BZKDP/robot-arm/README.md

# Роборука 5-DOF (редукторная)

Пятиосевой настольный манипулятор с редукторным приводом. Кинематическая цепь:
yaw базы (J1) → pitch плеча (J2) → roll (J4) → pitch (J5) → вращение кисти (J6).
Рама собрана из алюминиевого профиля и U-кронштейнов, звенья на трубе 20x20.

## Привод
- 5x шаговых двигателя NEMA17 (17HS4401 на основных осях, NEMA14 на кисти);
- планетарные редукторы CM36 1:71 на каждом суставе;
- металлические фланцевые муфты на вал 8 мм, вторая опора pitch-суставов на фланцевых подшипниках KFL08.

## Обратная связь и управление
- драйверы TMC2209 (STEP/DIR, в перспективе UART);
- магнитные энкодеры AS5600 на выходных осях суставов (абсолютный угол после редуктора);
- единый контроллер на ESP32; firmware на FastAccelStepper (аппаратные RMT-движки на ось);
- десктопная панель управления на Python (jog-режим, телеметрия, E-STOP, watchdog).

## Обучение
Планируется обучение движениям джойстиком (teach-by-demonstration) с дальнейшим
переносом траекторий в стек LeRobot для автономного управления.

## Состав репозитория
- `arm/` — основная рука: CAD-генераторы (Python/CadQuery), печатные детали, прошивка (`firmware/`), схемы разводки (SVG), BOM и аудиты;
- `stl_original/` — исходный STL-набор EEZYbotARM MK2, взятый за механическую основу;
- `pan-tilt-tracker/` — подсистема pan-tilt камеры (ESP32-CAM, сервоприводы STS3215, трекинг);
- `vacuum/` — вакуумный захват (держатель присоски);
- `BOM.md`, `notes.md` — перечень компонентов и рабочие заметки.

## Статус
Проект в разработке: J1/J2 собраны и протестированы под нагрузкой, идёт установка
энкодеров и калибровка остальных осей. Абсолютное позиционирование и IK — следующий этап.
