BZKDP/robot-arm/arm/full_arm_v10_detail/README_RU.md

# Роборука V10 — полная детальная модель

Открыть `ARM_V10_FULL_DETAIL_INTERACTIVE_3D.html` двойным щелчком. Интернет не нужен.

Это сборочная модель для проверки компоновки, а не единый файл для печати.

Включено: шесть осей J1–J6, подробная геометрия v8, новый J3, перенесённый J4 roll, нижняя клетка M5×80, roll-клетка M5×80, двойной Hall-индекс J1, AS5600 на pitch-суставах, муфты, KFL08, трубы, винты, шайбы, гайки и видимые маршруты жгутов.

Гармонические редукторы HBS17 намеренно не добавлены: они пока только рассматриваются.
