BZKDP/robot-arm/notes.md

# EEZYbotARM MK2 — печать на Creality Ender 3 V3 SE

Заметки и рекомендации для 3D-печати робо-руки. Обновляй раздел «Журнал печати» по ходу — отмечай, что уже напечатано и какие настройки использовал.

---

## 0. Принятые дефолты (если не подходит — поменяй)

- **Сервы:** MG996R × 3 (база, плечо, локоть) + SG90 × 1 (захват)
- **Шестерня серво:** `EBAmk2_010_gearservo_22DENTI.STL` (под 22T-сплайн MG996R). Если у тебя Hitec/DS3218 с 25T — взять `_25DENTI`. Универсальная `010_gearservo.STL` тоже годится, но потребует разворачивания посадочного отверстия под сплайн.
- **Мастер-шестерня:** `EBAmk2_011_gearmast_full.STL` (усиленная)
- **Горизонтальное звено:** `EBAmk2_006_horarm_plate.STL` (с пластиной — жёстче)
- **Материал:** PLA+ (или обычный PLA, если PLA+ нет). См. раздел «Материал».
- **Слайсер:** OrcaSlicer, профиль `Creality Ender-3 V3 SE`

---

## 1. Материал: PLA vs PETG

**Рекомендация: PLA+ (или PLA).**

| Критерий | PLA / PLA+ | PETG |
|---|---|---|
| Прочность на изгиб/нагрузку | ✅ выше | средняя (упругий — гнётся под винтом) |
| Жёсткость (важно для точности руки) | ✅ выше | ниже |
| Точность отверстий под М4 и валы | ✅ отлично | хуже (тянется) |
| Печать шестерён (мелкие зубья) | ✅ отлично | плохо (ниточность) |
| Стойкость к UV/жаре | ❌ деформация от 50–60 °C | ✅ до 70–80 °C |
| Хрупкость на ударе | хрупче | прочнее на удар |

**Когда выбирать PETG:** если рука будет работать на солнце, рядом с радиатором/обогревателем, или в неотапливаемом гараже летом (>40 °C в воздухе).

**Когда PLA+:** комнатные условия, точная геометрия, чёткие шестерни. Для EEZYbotARM MK2 это норма — у автора проекта (Carlo Franciscone) сами детали и опубликованные сборки в PLA/ABS.

**ABS не рекомендую** — Ender 3 V3 SE без корпуса, будут трещины (warping) на крупных деталях 001/002/012.

---

## 2. Температуры

### PLA+ (рекомендация)
- **Сопло:** 210 °C (первый слой 215 °C)
- **Стол:** 60 °C (первый слой 65 °C)
- **Обдув:** 100% после 2-го слоя

### PLA (обычный)
- **Сопло:** 200 °C (первый слой 205 °C)
- **Стол:** 55–60 °C
- **Обдув:** 100% после 2-го слоя

### PETG (если выбран)
- **Сопло:** 235 °C (первый слой 240 °C)
- **Стол:** 75 °C
- **Обдув:** 30–40% (выше — расслоение)
- **Z-offset:** на 0.05 мм выше обычного (PETG липнет агрессивно)

**Первое — сделай Temp Tower и Flow test для конкретной катушки.** Любой производитель врёт на ±10 °C от рекомендации на этикетке.

---

## 3. Скорости (для V3 SE)

V3 SE паспортно умеет до 250 мм/с, но для **точных механических деталей** руки это перебор — будет звон (ringing) и потеря точности отверстий.

| Параметр | Значение | Почему |
|---|---|---|
| Outer wall (наружные стены) | **80 мм/с** | внешний вид и точность размеров отверстий |
| Inner walls | 150 мм/с | внутри детали, не критично |
| Infill | 180–200 мм/с | стандартно |
| Top/Bottom solid | 100 мм/с | гладкая поверхность |
| Travel | 250 мм/с | без выдавливания, можно гнать |
| Initial layer | **30 мм/с** | критично для адгезии |
| Initial layer travel | 50 мм/с | |

Включи **Input Shaping** в профиле V3 SE (Orca поддерживает — обычно уже в дефолтном профиле).

---

## 4. Высота слоя

| Категория | Layer height | Зачем |
|---|---|---|
| Шестерни (010, 011, 016, 018) | **0.12 мм** | мелкие зубья, плавность зацепления |
| Захват finger dx/sx (015, 017) | 0.16 мм | компромисс точности и времени |
| Линки 004/005/008 | 0.2 мм | стандарт |
| Большие звенья 002/003/006 | 0.2 мм | |
| База 001/012/013 | 0.24 мм | большие объёмы, не критично |

Первый слой везде — **0.24 мм** (даже если основная высота 0.12) — для адгезии.

---

## 5. Заполнение (infill)

**Тип заполнения для всех нагруженных деталей: `Gyroid`** — лучший на скручивание и многонаправленную нагрузку. На сжатие хуже Cubic, но робо-рука работает в основном на изгиб/кручение.

| Категория | Infill % | Тип |
|---|---|---|
| База (001, 012, 013) | **40%** Gyroid | держит весь вес руки |
| Главное плечо 002, V-arm 003 | **35%** Gyroid | основные нагруженные звенья |
| Horizontal arm 006_plate | **35%** Gyroid | плюс пластина усиления внутри |
| Линки 004/005/007/008/009 | 30% Gyroid | средняя нагрузка |
| Шестерни 010/011/016/018 | **60%** Cubic | жёсткие зубья, без деформации |
| Claw base 014 | 30% Gyroid | |
| Claw fingers 015/017 | **40%** Cubic | держат груз, нужна жёсткость кончика |
| Drive cover 019 | 15% Gyroid | декоративная крышка |

---

## 6. Стены / Walls

- **Outer + inner walls = 4 периметра** для всех механических деталей
- **Шестерни (010, 011, 016, 018): 5 периметров** — зубья должны быть плотные
- **Top/Bottom layers:** 5 (минимум) — особенно для деталей с отверстиями под валы (M4)
- **Line width:** оставить дефолт (0.42 при сопле 0.4)

---

## 7. Поддержки — конкретно по деталям

**Общее правило MK2:** STL автора **уже ориентированы под минимум поддержек**. Не вращай детали без необходимости.

### Поддержки НУЖНЫ:
| Деталь | Где |
|---|---|
| `001_base` | внутри углубления под подшипник (если есть выступ) |
| `002_mainarm` | в районе отверстия серво (M-форма) |
| `006_horarm_plate` | **точно нужны** — есть нависающие площадки. Тип: **Tree (organic)** в Orca |
| `012_mainbase_NEW` | внутренние полости под серву и подшипник |
| `014_claw base` | под крепление сервы захвата |

### Поддержки НЕ нужны (печатать без них):
| Деталь | Почему |
|---|---|
| `010_gearservo*` | плоская, ориентация лежа |
| `011_gearmast*` | то же |
| `004_link135`, `005_link135angled`, `008_link147` | линки печатаются плашмя |
| `007_trialink`, `009_trialinkfront` | треугольники плоские |
| `013_lower base` | плита |
| `015/017_claw finger` | лежа на боку — нет навесов |
| `016_claw gear drive`, `018_claw gear driven` | плоско, лежа |
| `019_drive_cover` | плоская крышка |
| `003_varm` | вертикальное звено, обычно без поддержек |

### Tree (Organic) vs Normal в OrcaSlicer
- **Tree (Organic)** — для `006_horarm_plate`, `001_base`, `012_mainbase`, `014_claw base` (сложная геометрия, легко удаляется)
- **Normal** — нигде особо не нужен. Только если будут глюки Tree.

### Параметры поддержек (Orca):
- Z-расстояние: **0.2 мм** (1 слой при 0.2 мм)
- Pattern: Default
- Threshold angle: 50° (по умолчанию)
- **Снимаем кусачками после остывания**, не пытайся ломать горячую деталь.

---

## 8. Ориентация на столе (критично!)

Слои печати должны идти **перпендикулярно нагрузке**, чтобы детали не расслаивались по шву.

| Деталь | Ориентация |
|---|---|
| **Шестерни 010, 011, 016, 018** | **Лежа плашмя**, зубьями вверх. Никогда не вертикально! Расслоение по зубу = шестерня сломается на первой нагрузке. |
| **Линки 004, 005, 008** | Плашмя (отверстия M4 вверх) — стержень нагружен на изгиб, слои перпендикулярны |
| **`002 mainarm`, `003 varm`** | По длинной оси на столе (как «лежит лопатка») |
| **`006 horarm_plate`** | Самой широкой плоскостью вниз, поддержки сверху |
| **`015/017 claw finger`** | На бок (как они работают в захвате) |
| **`001 base`** | Дном вниз |
| **`014 claw base`** | Открытой стороной вверх (поддержки внутри) |

В OrcaSlicer есть кнопка **Auto-orient** — она часто угадывает правильно, но **проверяй вручную** для шестерён и линков.

---

## 9. Адгезия (Brim / Raft / Skirt)

| Деталь | Адгезия |
|---|---|
| Большие плоские (001, 012, 013, 019) | **Skirt** (1 контур, 4 мм) — для прайма |
| Шестерни 010, 011, 016, 018 | **Brim 5 мм** — иначе угол отлипнет и зубья поплывут |
| Линки 004, 005, 007, 008, 009 | **Brim 3 мм** — мало площади на столе |
| `015/017 claw finger` (на боку) | **Brim 5 мм** — мало контакта |
| 006 horarm_plate | Skirt + Tree support срабатывают как адгезия |

**Raft не нужен** — V3 SE с PEI/PC-стеклом держит первый слой отлично, raft только тратит пластик и портит низ детали.

---

## 10. Порядок печати

### Шаг A — Тест точности (ОБЯЗАТЕЛЬНО первым)
Перед массовой печатью убедись, что твоя сборка даёт **±0.2 мм** на отверстиях:

1. Распечатай `EBAmk2_010_gearservo_22DENTI.STL` (~30 мин) — у неё центральное отверстие под вал сервы. Проверь по штангенциркулю.
2. Распечатай `EBAmk2_004_link135.STL` (~1.5 ч) — длинный линк с двумя отверстиями M4. Проверь штангенциркулем и попробуй вставить M4-винт. Должен заходить с лёгким усилием, не болтаться, не клинить.

**Если отверстия зарастают** → в слайсере выкрути `Hole horizontal compensation` или `XY hole compensation` на +0.1...+0.2 мм.
**Если слишком велики** → -0.1 мм или подкрути e-step / flow rate.

### Шаг B — Основная партия (от простого к сложному)
Печатать партиями по 1–3 детали (мелкие можно вместе на одном столе):

| № | Деталь | Прим. время | Примечание |
|---|---|---|---|
| 1 | 010_gearservo_22DENTI | 0.5 ч | (уже из теста) |
| 2 | 011_gearmast_full | 2 ч | |
| 3 | 016_claw gear drive | 0.5 ч | |
| 4 | 018_claw gear driven | 0.5 ч | |
| 5 | 015_claw finger dx | 1 ч | |
| 6 | 017_claw finger sx | 1 ч | |
| 7 | 014_claw base | 2 ч | |
| 8 | 019_drive_cover_new | 1 ч | |
| 9 | 004_link135 | 1.5 ч | (уже из теста) |
| 10 | 005_link135angled | 1.5 ч | |
| 11 | 007_trialink | 2.5 ч | |
| 12 | 008_link147_new | 2 ч | |
| 13 | 009_trialinkfront | 2.5 ч | |
| 14 | 013_lower base | 1.5 ч | |
| 15 | 003_varm | 2 ч | |
| 16 | 002_mainarm | 5 ч | крупная |
| 17 | 006_horarm_plate | 6 ч | крупная + поддержки |
| 18 | 001_base | 6 ч | |
| 19 | 012_mainbase_NEW | 7 ч | самая большая |

**Итого: ~45–50 часов чистой печати** на PLA при средних настройках (~180 мм/с infill, 80 мм/с outer wall).

Разумно растянуть на 5–7 дней по 1–2 партии в день — не оставляй принтер на ночь без присмотра, особенно в начале.

---

## 11. Workflow в OrcaSlicer (пошагово)

1. **Запусти OrcaSlicer.** При первом запуске мастер настройки — выбери `Creality` → `Ender-3 V3 SE` (профиль есть из коробки).
2. **Импорт STL:** `File → Import → Import STL` (или Ctrl+I), выбери файл из `.\stl_original\`.
3. **Ориентация:** нажми **Auto-orient** (иконка с поворотом), потом проверь по рекомендациям из §8.
4. **Применить настройки:** в правой панели выбери Filament (`Generic PLA`/`Generic PLA+`), затем процесс печати — создай свой preset:
    - `Process → New Preset → "EEZYbotARM_strong_0.2"`
    - Заполни параметры из §3–§9 для соответствующей категории детали.
    - Сохрани.
5. **Поддержки:** включи в `Support → Enable Support`. Тип — `Tree (organic)` (см. §7).
   - **Manual painting** (кнопка с кистью на верхней панели) — используй, когда хочешь убрать лишние поддержки или, наоборот, добавить точечно. Особенно полезно для `006_horarm_plate`.
6. **Slice:** кнопка `Slice plate` (внизу справа).
7. **Превью слоёв:** после слайса откроется preview. Прокрути ползунок снизу вверх — проверь:
   - Первый слой — без дыр
   - Поддержки не сваливаются на воздух
   - Шестерни и зубья выглядят как нужно
   - Время и расход внизу справа
8. **Экспорт G-code:** кнопка `Export G-code` (рядом со Slice). Сохрани в `.\gcode_output\`.

**Имя файла:** `NN_<деталь>_<материал>_<infill>.gcode`, например:
```
10_gearservo_22DENTI_PLA_60.gcode
04_link135_PLA_30.gcode
19_mainbase_NEW_PLA_40.gcode
```

### CLI (для будущей автоматизации)
```bash
"/c/Program Files/OrcaSlicer/orca-slicer.exe" --slice 0 \
  --load "профиль.json" \
  --output "gcode_output/файл.gcode" \
  "stl_original/EBAmk2_004_link135.STL"
```
Полная документация: `orca-slicer.exe --help`.

---

## 12. Перенос на принтер (Ender 3 V3 SE)

### Через USB-флешку
- **ФС:** **FAT32** (обязательно). exFAT V3 SE не читает. NTFS тоже не читает.
- **Размер флешки:** до 32 ГБ (FAT32-лимит). Хватает за глаза.
- **Имена файлов:** только латиница и цифры, без пробелов и кириллицы. Длина до 64 символов. Дефис и подчёркивание ok.
- **Куда класть:** в корень флешки. Поддерживаются подпапки до 1 уровня, но не все G-code-плагины их видят — лучше в корень.
- **Сортировка на экране:** по дате модификации (сверху — самые свежие).
- **Превью:** OrcaSlicer вшивает превью в G-code (thumbnail). Профиль `Ender-3 V3 SE` включает это по умолчанию.

### Через Wi-Fi (опционально)
**Ender 3 V3 SE НЕ имеет встроенного Wi-Fi** ([источник](https://www.crealitycloud.com/post-detail/6782c6e2ccf5567488d6dc88)). Нужен внешний модуль — варианты:
- **Creality Wi-Fi Box 2.0** (USB) — самый простой, подключается по USB к плате принтера, работает с `Creality Print` и Creality Cloud
- **Nebula Pad / Sonic Pad** — даёт Klipper + удалённый интерфейс, дороже
- **Raspberry Pi с OctoPrint** — самый гибкий, но требует возни. **OctoPrint в стоке Ender 3 V3 SE через USB работает** — V3 SE отдаёт серийник как обычный Marlin-принтер.

Без модуля — **флешка остаётся основным каналом**.

---

## 13. Pre-print checklist (делай перед КАЖДОЙ печатью)

### Калибровка стола (V3 SE с CR Touch)
- [ ] Нагрей стол до **рабочей температуры** (60 °C для PLA) — алюминий расширяется, делать леволинг холодным неправильно.
- [ ] Меню `Prepare → Auto Home` → дождись завершения.
- [ ] Меню `Prepare → Auto Leveling` — CR Touch проедет сетку (~3 минуты).
- [ ] После леволинга сделай **Z-offset проверку**: лист A4 между соплом и столом, медленно опускай Z по 0.05 мм, пока бумага не начнёт тереться (но не клинить).
- [ ] Сохрани Z-offset в EEPROM (`Settings → Store Settings` или автоматически на V3 SE).

### Перед запуском печати
- [ ] **Очисти стол изопропилом** (90%+) — никакого жира от пальцев.
- [ ] **Проверь ремни:** ось X и Y — нажимаешь пальцем посередине, ремень прогибается на 3–5 мм, дальше упругое сопротивление. Слишком слабый — будет ringing. Слишком тугой — потеря шагов.
- [ ] **Прокатай филамент 50 см** из сопла после смены катушки — должна идти **ровная** нитка без пузырей.
- [ ] **Flow test:** распечатай single wall куб 20×20×20 без верха/низа, измерь толщину стенки штангенциркулем — должна быть = line width × 1 (0.42 при сопле 0.4). Корректируй `Flow ratio` в filament-настройках.
- [ ] **Температурный тест:** для новой катушки — Temp Tower (есть готовые STL/gcode в репах OrcaSlicer).

### Первый слой (наблюдай первые 5 минут)
- [ ] Сопло **не царапает** стол (Z-offset слишком низкий) — крути up на 0.05.
- [ ] Линии **не размазываются и не зазоры** между ними — идеально, когда линии чуть приплюснуты, без щелей.
- [ ] Углы **не задираются** — если задрались, увеличь Brim или снизь скорость первого слоя до 20 мм/с.
- [ ] Если что-то не так — **жми `Stop` сразу**, не жди. Лучше перепечатать первый слой 10 раз, чем выкинуть 6-часовую печать с расслоением.

---

## 14. Мониторинг длинных печатей

V3 SE — без Wi-Fi и без экрана с прогрессом в облако в базовой комплектации. Варианты:

| Решение | Сложность | Что даёт |
|---|---|---|
| **Web-камера (USB → ноутбук)** | минимум | визуальный контроль, можно записать таймлапс через OBS/iSpy |
| **OctoPrint на Raspberry Pi** | средне | удалённый старт/стоп, прогресс, snapshot, плагины (включая failure detection) |
| **Creality Wi-Fi Box 2.0** | минимум | приложение `Creality Print` → удалённый статус, отправка G-code по Wi-Fi |
| **Nebula Pad** | средне | Klipper + Mainsail, лучшее качество и input shaping |

**Минимум-вариант:** телефон на штативе с приложением типа `Alfred Home Security Camera` (бесплатно) — даёт прямой стрим на твой второй телефон / комп. Если что — приходишь и жмёшь стоп.

**Никогда не оставляй принтер совсем без присмотра**, особенно ночью (рекомендация Creality и здравый смысл).

---

## 15. Журнал печати

Заполняй по ходу. Формат: дата · деталь · профиль · результат · заметки.

| Дата | Деталь | Профиль | Время | Результат | Заметки |
|---|---|---|---|---|---|
| | | | | | |
| | | | | | |

---

## 16. Полезные ссылки

- [EEZYbotARM MK2 на Instructables (инструкция автора)](https://www.instructables.com/EEZYbotARM-Mk2-3D-Printed-Robot/)
- [Thingiverse / MyMiniFactory оригинал](https://www.myminifactory.com/object/3d-print-eezybotarm-mk2-46620)
- [Ender-3 V3 SE Downloads (firmware, Creality Print)](https://www.creality.com/download/creality-ender-3-v3-se)
- [OrcaSlicer releases](https://github.com/SoftFever/OrcaSlicer/releases)
