BZKDP/robot-arm/arm/electronics_carrier_v1/ELECTRONICS_CARRIER_V2_INTERACTIVE_3D.html

# Кассета электроники — V2 PREVIEW

2× обычная ESP32 · 5× LERDGE TMC2209 · 3× F15 · CJMCU-9548 · ASW-17D · 5× AS5600. ЛКМ — вращать, колесо — масштаб, ПКМ — двигать камеру.

Разнести уровни 0%

СобраноРазобраноОбъёмСверху

Показать внутренности и провода

Скрыть верхнюю пластину

Верх STLКороб STLТест кнопки STLОбзор PNG

Пока это PREVIEW: детали ещё не измерены штангенциркулем. Полный корпус печатать после контрольных замеров. Калибратор выключателя уже можно использовать после его получения.

Две обычные ESP32
Левая управляет моторами, правая опрашивает датчики. У каждой свой передний выход USB-C, поэтому обе можно одновременно подключить к компьютеру двумя кабелями и открыть два COM-порта.

CJMCU-9548 / TCA9548A
Размер заложен 31,5×22 мм. Крепление универсальное: направляющие за края и прорези под стяжку, потому что источники расходятся по диаметру штатных отверстий. Пять AS5600 подключаются к каналам SC0/SD0…SC4/SD4.

Пять AS5600 находятся на руке
В корпус заходят пять отдельных четырёхжильных кабелей S1–S5: 3V3, GND, SDA, SCL. Справа предусмотрено пять вводов с разгрузкой стяжками и один отдельный AUX. SDA/SCL датчиков не объединяются до TCA.

Три внутренних F15
F1: 3V3 моторной ESP → VIO пяти драйверов. F2: 3V3 датчиковой ESP → VCC пяти AS5600. F3: GND датчиковой ESP → GND пяти AS5600. Размер посадки 39,8×29×14,5 мм; крепление уголками и стяжкой.

Питание и земли
Линии 3V3 двух ESP32 между собой не соединять. Общая GND ESP32, драйверов и 12-вольтового источника обязательна. CJMCU-9548 получает 3V3 и GND от датчиковой ESP32 короткими проводами.

Выключатель REXANT ASW-17D
Учтён новый точный чертёж: окно 34,2×20,2 мм, рамка 38,5×22,5 мм. В модели окно 34,5×20,5 мм. Короб увеличен до 40 мм, чтобы поместились корпус и клеммы. Это обычное отключение питания моторов, не аварийная кнопка.

Пять драйверов и моторные кабели
J1–J5 стоят одним рядом, радиаторы открыты. Сзади каждому драйверу соответствует отдельный широкий ввод моторного кабеля с парой пазов под стяжку.

Габариты печати
Верх и короб: 200×160 мм, подходят для стола Ender‑3 V3 SE 220×220 мм. Полезная высота нижнего отсека 37 мм. Обе печатные сетки замкнуты и состоят из одного тела.

+12 V после выключателя общая GND управление моторами кабели датчиков S1–S5

СВЕРХУ: ПЛАТЫ И КЛЕММЫ · ВНУТРИ: 3× F15, КОНДЕНСАТОР, ПАЙКА И КАБЕЛИ
