BZKDP/robot-arm/arm/electronics_carrier_v1/FINAL_DIMENSION_CHECK_RU.md

# Проверка размеров финальной кассеты

## Принтер и габарит

- Принтер: Creality Ender-3 V3 SE.
- Рабочая область: 220×220×250 мм.
- Основание каждой печатаемой детали: 200×140 мм.
- Запас на столе: 10 мм с каждой стороны по оси 200 мм и 40 мм по оси 140 мм.
- С brim 5 мм: итоговый след 210×150 мм; минимальный запас до границы стола 5 мм.

## Нижний короб

- Общая высота: 24 мм.
- Дно: 3 мм.
- Стенки: 3 мм.
- Полезная внутренняя высота: около 21 мм.
- Ввод 12 В: 10×16 мм.
- Выводы моторов: 5 штук по 12×10 мм.
- Выводы датчиков/AUX: 6 штук по 10×8 мм.
- Передний вырез USB-C: 22×10 мм.

## Верхняя пластина

- Толщина основы: 3,2 мм.
- Максимальная высота с направляющими: 6,38 мм.
- ESP32: номинальный DevKit 30 pin 51,5×28,5 мм; междурядье выводов 25,4 мм.
- LERDGE TMC2209: официальная плата 20,5×15,5 мм; междурядье выводов 12,7 мм.
- Высота драйвера с радиатором по пользовательскому замеру: 13 мм; радиаторы открыты сверху.
- CH-22/12P-1/1: 75,6×41,6×15 мм; отверстия Ø3,4 мм; межосевое расстояние 70 мм.
- От заднего края прорези CH-22 до края пластины остаётся 5,7 мм материала.
- Между зоной драйверов и корпусами CH-22 остаётся около 6,95 мм.
- От торца каждой CH-22 до боковой границы пластины остаётся около 20,2 мм.
- Проход USB-C в пластине: 22×14 мм.

## Проверка STL

Обе печатаемые сетки проверены программно:

- замкнутые и водонепроницаемые;
- согласованное направление граней;
- каждая состоит из одного связного тела;
- нет разорванных граней;
- нижняя поверхность лежит на Z=0;
- обе детали помещаются на стол 220×220 мм с brim 5 мм;
- поддержки не требуются: найденные нижние микрограни имеют короткие пролёты, печатаемые как обычные мосты.

Перед окончательной пайкой обязательна сухая примерка: у клонов ESP32 может немного отличаться внешний контур и положение USB-разъёма, поэтому посадка сделана по рядам контактов и увеличенному окну, а не по жёсткому контуру платы.
