BZKDP/robot-arm/arm/PROJECT_AUDIT_2026-08-28.md

# Роборука — независимый аудит проекта на 2026-08-28

## 1. Текущее понимание конструкции

Финальная обсуждавшаяся кинематическая цепь имеет пять управляемых осей:

`J1 yaw базы → J2 pitch плеча → J4 roll → J5 pitch → J6 вращение кисти`.

J3-локоть был исключён ради массы. Поэтому старые файлы, где есть J3 и шесть двигателей, не являются текущей архитектурой.

Основная механика:

- длинные NEMA17 на J1 и J2;
- CM36 1:71;
- металлические фланцевые муфты на вал 8 мм;
- U-кронштейны;
- труба 20 × 20 × 1,5 мм;
- противоположная опора pitch-суставов — вал Ø8 и ромбический фланцевый подшипник;
- AS5600 на выходных осях pitch-суставов;
- NEMA17 в большом стакане на J4 roll;
- NEMA14 в малом стакане на J6.

## 2. Что восстановлено из спорных итераций J2

Точный замер реальной металлической муфты:

- фланец: Ø21,8 × 2 мм;
- хаб: примерно Ø14,1 мм;
- общая длина: около 12,8 мм;
- вал: Ø8 мм;
- четыре отверстия: около Ø3,5 мм, то есть крепёж M3;
- измеренное расстояние между противоположными центрами: BC ≈16,5 мм.

Предыдущий мост имел две отдельные проблемы:

1. Трубные винты стояли на ±16 мм, и фланец муфты перекрывал их цековки. В T5 они перенесены на ±21,5 мм.
2. После правильного вывода «муфта = M3» генератор V4 снова ошибочно вернулся к M4. Эта версия больше не считается рабочей.

Текущая размерная цепь T5 по оси Z:

- стенка A U-кронштейна: −24…−21,5 мм;
- хаб муфты: примерно −21…−10,2 мм;
- фланец муфты: −10,2…−8,2 мм;
- мост T5: −8,2…−3,2 мм;
- труба: −3,2…+16,8 мм;
- зазор до стенки B: около 4,7 мм;
- стенка B: +21,5…+24 мм.

## 3. Текущий мост V7/T5

- Габарит: 40 × 56 × 5 мм.
- Труба: M4 на ±21,5 мм; цековки Ø8,4 × 3 мм.
- Центральный проход: Ø9,2 мм.
- Муфта: четыре радиальных паза шириной 4,0 мм.
- После V6 добавлено ещё +5% без отдельного пробника.
- Новая цель: BC20,963 мм; номинальный центр пазов V7: BC21,0 мм.
- Допустимый диапазон V7: BC18,0…24,0 мм.
- Крепёж муфты: 4 × M3×7 и гайки M3.

Сетка STL герметична, габарит и сечения проверены автоматически. Точки BC=20,963 проходят внутри всех четырёх пазов.

## 4. Стакан roll NEMA17

Старый стакан имел правильный моторный квадрат 31 × 31 мм, но не оставлял места головкам длинных M3 возле углов стенки. Старое указание M4×30 также не позволяло нормально поставить гайку на стакан наружной шириной 29,4 мм.

В финальной V3:

- фланец 50 × 50 × 5 мм;
- карман трубы 20,4 × 20,4 мм, глубина около 30,5 мм фактического входа;
- NEMA17: квадрат 31 × 31 мм, проход M3 Ø3,8 мм;
- четыре вертикальных выреза Ø6,6 мм для головок и шестигранника;
- поперечные отверстия Ø4,6 мм;
- встроен удаляемый после печати диск Ø70×0,4 мм, увеличивающий расчётную площадь первого слоя примерно на 66%;
- кабельный паз открыт сверху, поэтому печать не строит поздний мостик над окном;
- к трубе: M4×35 минимум или M4×40 с шайбами/нейлоками;
- внутри трубы обязательны распорки;
- стяжные M3 мотора нужно измерить и заменить по одному на винты на 5 мм длиннее.

Маленький стакан NEMA14 пока остаётся прототипом: перед его будущей печатью нужно повторить исправление доступа к головкам и проверить реальный мотор.

## 5. Сильные стороны конструкции

- Нагруженная кинематика основана на металлических редукторах, U-кронштейнах, валу и подшипнике, а не целиком на печатном пластике.
- Выходной AS5600 на pitch-суставе видит люфт редуктора и фактический угол звена, что полезнее датчика только на моторе.
- Двухопорная схема J2/J5 механически значительно лучше консольного крепления.
- Кассета распределяет затяжку M4 и защищает тонкую трубу от локального смятия.
- Повторяемость одинаковых узлов J2/J5 упрощает запасные детали и калибровку.
- Проект модульный: PETG-мост можно позже заменить алюминиевой пластиной без полной переделки руки.

## 6. Главные риски механики

### 6.1. Пять осей без локтя

Это не универсальная рука с произвольным радиусом достижения. Без J3 рабочая область сильно ограничена дугой/оболочкой. Для перекладывания банок между заранее выставленными фиксированными местами это может работать. Для произвольного pick-and-place позже понадобится лёгкий локоть либо линейная ось/подвижная база.

### 6.2. Противоположная ось Ø8

Её нельзя оставлять свободно вращаться или перемещаться относительно трубы. Иначе AS5600/подшипник покажут люфт, а труба будет жить отдельно от оси. После сухой проверки нужна жёсткая фиксация: удерживающий состав для цилиндрических соединений, эпоксидка либо новая кассета с разрезным зажимом/стопорным винтом. Зажимная версия предпочтительнее клея для обслуживаемости.

### 6.3. Зазор T5

Расчётный запас у второй стенки около 4,7 мм, обычная головка M4 DIN912 около 4 мм. Геометрически проходит, но реальный запас всего около 0,7 мм. Низкая головка M4 ISO 7380 даёт лучший резерв. До питания узел нужно вручную провести по всему диапазону.

### 6.4. PETG под постоянной нагрузкой

Мост подходит для сборки и прототипа, но PETG ползёт под постоянным прижимом и нагревом. После проверки геометрии нагруженный J2 лучше сделать из алюминия 4–5 мм. Первые циклы проводить на малой скорости и повторно проверить затяжку M3/M4 после прогрева.

### 6.5. Точность

Цель ±0,3–0,5 мм для первой версии слишком оптимистична. Ошибку суммируют люфт планетарников, изгиб труб, PETG, зазор подшипников, магнитная ошибка AS5600 и калибровка нескольких осей. Реалистичная первая цель — стабильные 1–3 мм. После калибровки, подхода к точке всегда с одной стороны и устранения люфта можно стремиться к 0,5–1,5 мм.

## 7. Электрика и текущий тестовый софт

Папка `one_joint_stand` — полезный стенд одного сустава, но не готовый контроллер руки.

Критичные ограничения текущей прошивки:

- `PIN_EN = -1`, а EN драйвера привязан к GND. Команда `EN OFF` останавливает выдачу STEP, но физически не отключает силовые ключи TMC2209.
- При старте текущий угол AS5600 автоматически становится нулём. Абсолютная механическая калибровка после перезапуска не сохраняется.
- `GOTO` использует кратчайший путь по кругу 0…360°. Для ограниченного сустава это может выбрать запрещённую сторону и ударить в механику.
- Нет watchdog/heartbeat: при зависшем ПК или оборванном USB постоянный JOG может продолжиться.
- STEP формируется опросом `micros()` в основном цикле; I2C, телеметрия и блокирующее чтение строки создают джиттер.
- Нет конечников, программных границ, защёлки ошибки энкодера, аварийного входа и безопасной процедуры включения.
- Deadband 1° соответствует примерно 2,6 мм линейного смещения на плече 150 мм ещё до остальных ошибок.

До движения собранной руки нужен новый низкоуровневый контроллер:

1. физически управляемый EN каждого драйвера;
2. аппаратная аварийная остановка, снимающая VMOT;
3. heartbeat и немедленный STOP при потере связи/датчика;
4. сохранённый ноль и направление каждой оси;
5. развёрнутый угол и жёсткие soft limits вместо кругового кратчайшего пути;
6. аппаратный генератор STEP и синхронные траектории;
7. конечный автомат `BOOT → SENSOR_CHECK → DISABLED → HOMING → READY → MOVING → FAULT`;
8. работа сначала на пониженном токе и скорости.

## 8. Противоречие архитектуры контроллеров

`system_wiring.svg` и `cluster_wiring.svg` всё ещё описывают три ESP32 и шесть осей, включая отменённый J3. Для первых J1+J2 одна ESP32 достаточна. Перед полной рукой нужно выбрать окончательную разводку.

Распределённые ESP32 уменьшают проблему одинакового I2C-адреса AS5600 0x36, но три независимых USB-COM требуют аккуратной синхронизации и fault-протокола. Для промышленно-похожего варианта лучше CAN/RS485 между контроллерами; для прототипа USB допустим, если траектория интерполируется локально, есть timestamps и общий аварийный останов.

## 9. Рекомендуемый порядок запуска J1+J2

1. Напечатать и физически проверить тестовый шаблон муфты.
2. Напечатать мост V7 и стакан roll V3 отдельными файлами.
3. Собрать J2 без двигателя и проверить ручной ход, зазоры и жёсткость противоположной оси.
4. Подключить только AS5600, проверить статус магнита и направление угла.
5. Собрать один мотор с TMC2209 на столе, с реальным EN и аварийным отключением VMOT.
6. На малом токе проверить направление STEP/DIR без присоединённого плеча.
7. Соединить мотор с J2, выставить механический ноль и очень узкие временные soft limits.
8. Провести медленный JOG короткими импульсами.
9. Только после этого включать позиционное движение, затем J1+J2 вместе.
10. Камеру, IK, pick-and-place и обучение добавлять после повторяемого безопасного движения двух осей.

## 10. Итоговая оценка

Это сильный и действительно интересный прототип, а не бессмысленный набор деталей. Хорошая часть проекта — металлическая силовая схема и обратная связь на выходе. Слабая часть — не сама идея, а накопившиеся несовместимые версии размеров, слишком раннее обещание высокой точности и отсутствие системной безопасности в софте.

В текущем виде проект можно довести до работающего демонстратора фиксированного pick-and-place. До надёжной рабочей машины потребуются алюминиевый мост, жёсткая фиксация осей, калибровка люфта, окончательная архитектура контроллеров и полностью переписанный безопасный motion-control слой.
