BZKDP/robot-arm/arm/electronics_carrier_v1/ELECTRONICS_CARRIER_V1_INTERACTIVE_3D.html

# Кассета электроники — финальная компоновка

ESP32 DevKit 30 pin · 5× LERDGE TMC2209 · двухэтажная разводка. ЛКМ — вращать, колесо — масштаб, ПКМ — двигать камеру.

Разнести уровни 0%

СобраноРазобраноОбъёмСверху

Показать провода снизу

Скрыть верхнюю пластину

Верхний держатель STLНижний короб STLОбзор PNG

Печатать двумя отдельными деталями: верхний держатель — плоской стороной на стол, направляющими вверх; нижний короб — дном на стол, открытой стороной вверх. Сборочный STL предназначен только для просмотра.

ESP32 — нижний левый угол
USB смотрит наружу. Две длинные прорези повторяют ряды 30-pin с шагом 2,54 мм. Пины и пайка доступны из нижнего отсека.

J1–J5 — один ряд драйверов
Размер каждого LERDGE взят из документации: 20,5×15,5 мм. Ряды контактов разнесены на 12,7 мм. Радиаторы полностью открыты сверху.

Питание — две твои CH-22/12P-1/1
Размер каждой по фото: 75,6×41,6×15 мм; два отверстия Ø3,4 мм с межосевым 70 мм. Левая колодка — +12 V, правая — GND. Используем по шесть каналов: пять драйверов и один запасной.

Важно: CH-22 не является общей шиной
По схеме на фото соседние каналы изолированы. Общую линию нельзя получить одной колодкой без отдельного объединения. В нижнем закрытом отсеке показаны две изолированные силовые шины, от которых идут отдельные короткие хвосты к шести каналам каждой колодки.

Пустой резерв под будущий хаб датчиков
Это не дополнительная купленная деталь. Сейчас зона остаётся пустой. Позже сюда можно закрепить маленькую плату, которая соберёт провода магнитных датчиков положения локтей. Если она не понадобится, площадка останется обычным свободным местом.

Твой конденсатор 470 мкФ / 50 В
Это уже имеющийся цилиндрический конденсатор между +12 V и GND. Он сглаживает короткие провалы и выбросы питания драйверов. В финале он лежит внутри нижнего отсека и фиксируется стяжкой — сверху цилиндра больше нет.

Все внешние кабели имеют собственный ввод
Спереди — увеличенное окно USB-C; слева — ввод питания 12 V; сзади — пять выходов моторов; справа — шесть малых выходов датчиков/AUX. Возле каждого ввода снизу есть пара пазов под стяжку для разгрузки пайки.

Нижний отсек
Полезная высота около 21 мм. Красная и чёрная линии — силовые шины; синие — STEP/DIR/UART; серые — пять четырёхжильных выходов к моторам. Верх снимается на шести M3.

Проверка перед печатью выполнена
Обе детали имеют размер основания 200×140 мм и помещаются на стол Ender-3 V3 SE 220×220 мм вместе с brim 5 мм. Сетки замкнуты, состоят из одного тела и лежат плоско на Z=0. Выключатель и предохранитель можно добавить позже в разрыв внешнего провода питания — отдельной неизвестной посадки сейчас нет.

+12 V общая земля управление от ESP32 кабели двигателей

ВЕРХ: МОДУЛИ И РАДИАТОРЫ · НИЗ: ПАЙКА, ПИТАНИЕ И КАБЕЛЬНЫЕ КАНАЛЫ
