BZKDP/robot-arm/arm/adapter_plate_PREVIEW.png

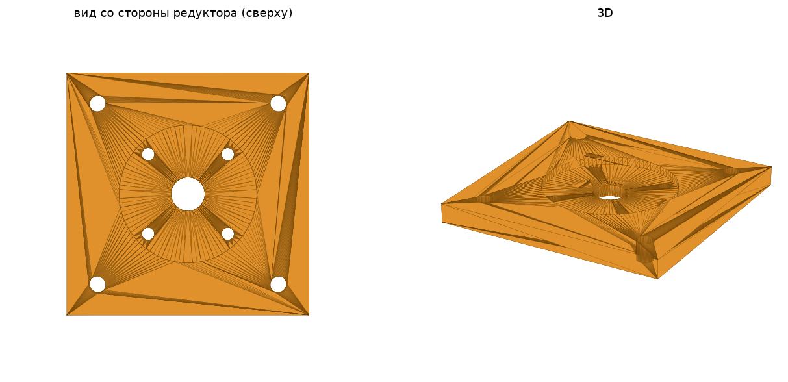
arm/adapter_plate_PREVIEW.png
