BZKDP/robot-arm/arm/arm_top.png

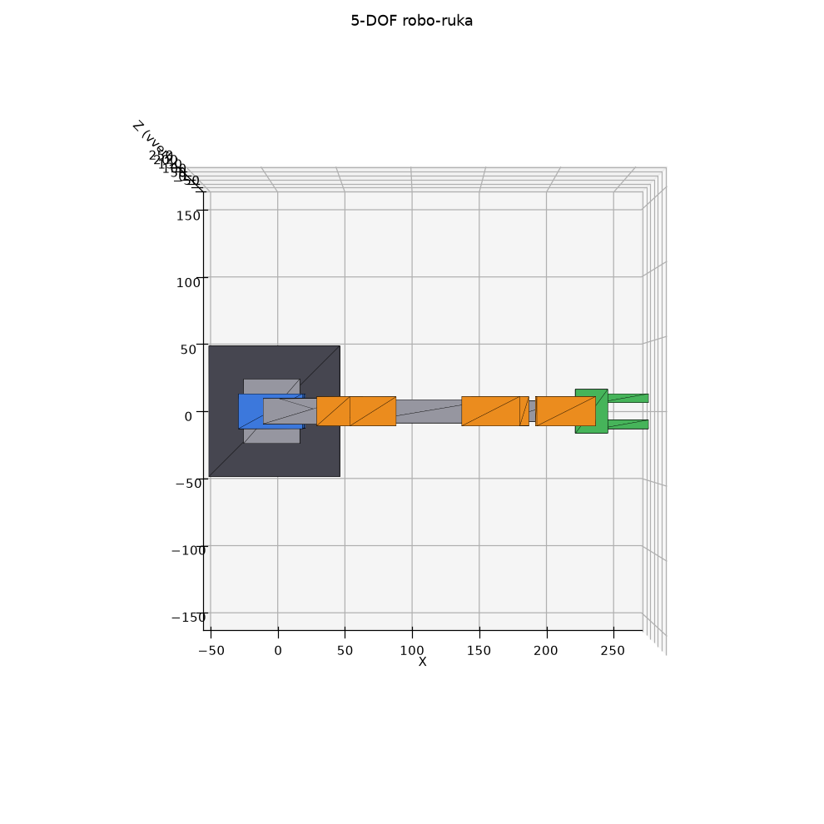
arm/arm_top.png
