BZKDP/robot-arm/arm/arm_view1.png

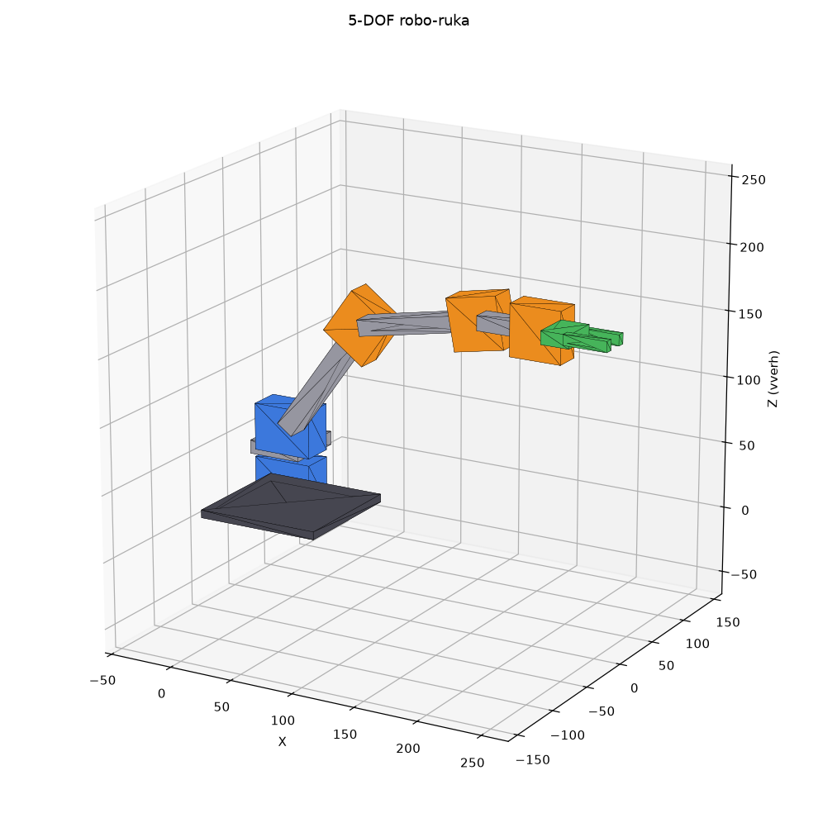
arm/arm_view1.png
