BZKDP/robot-arm/arm/arm_view2.png

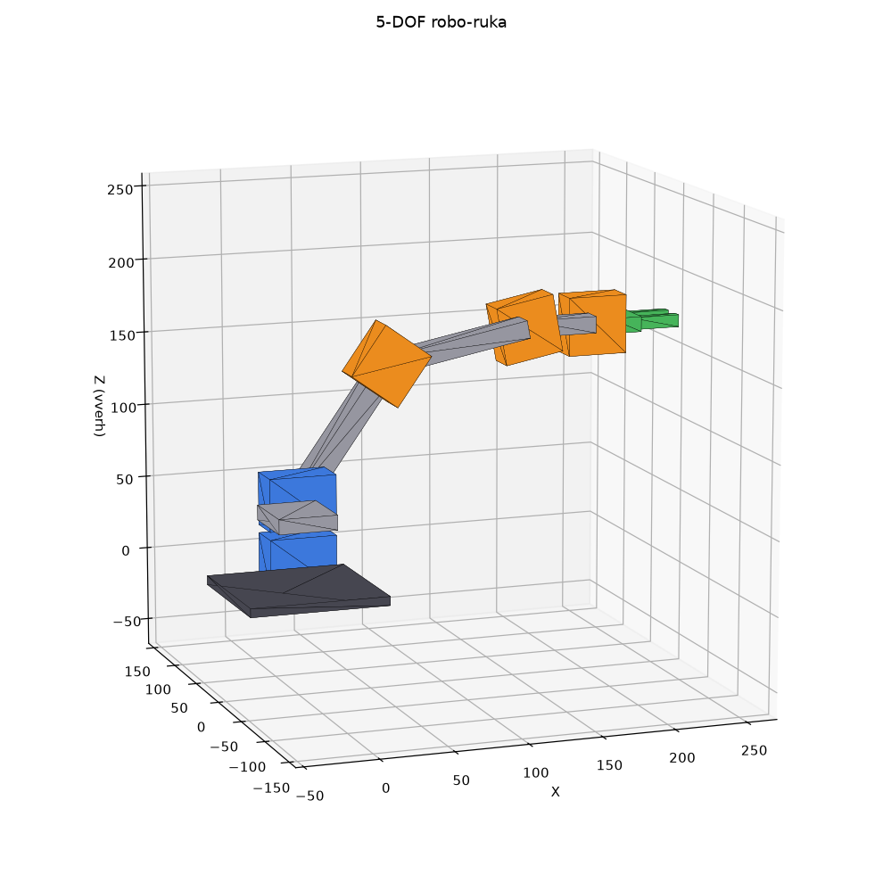
arm/arm_view2.png
