BZKDP/robot-arm/arm/base_j1/arm_v9_6axis_review_check.png

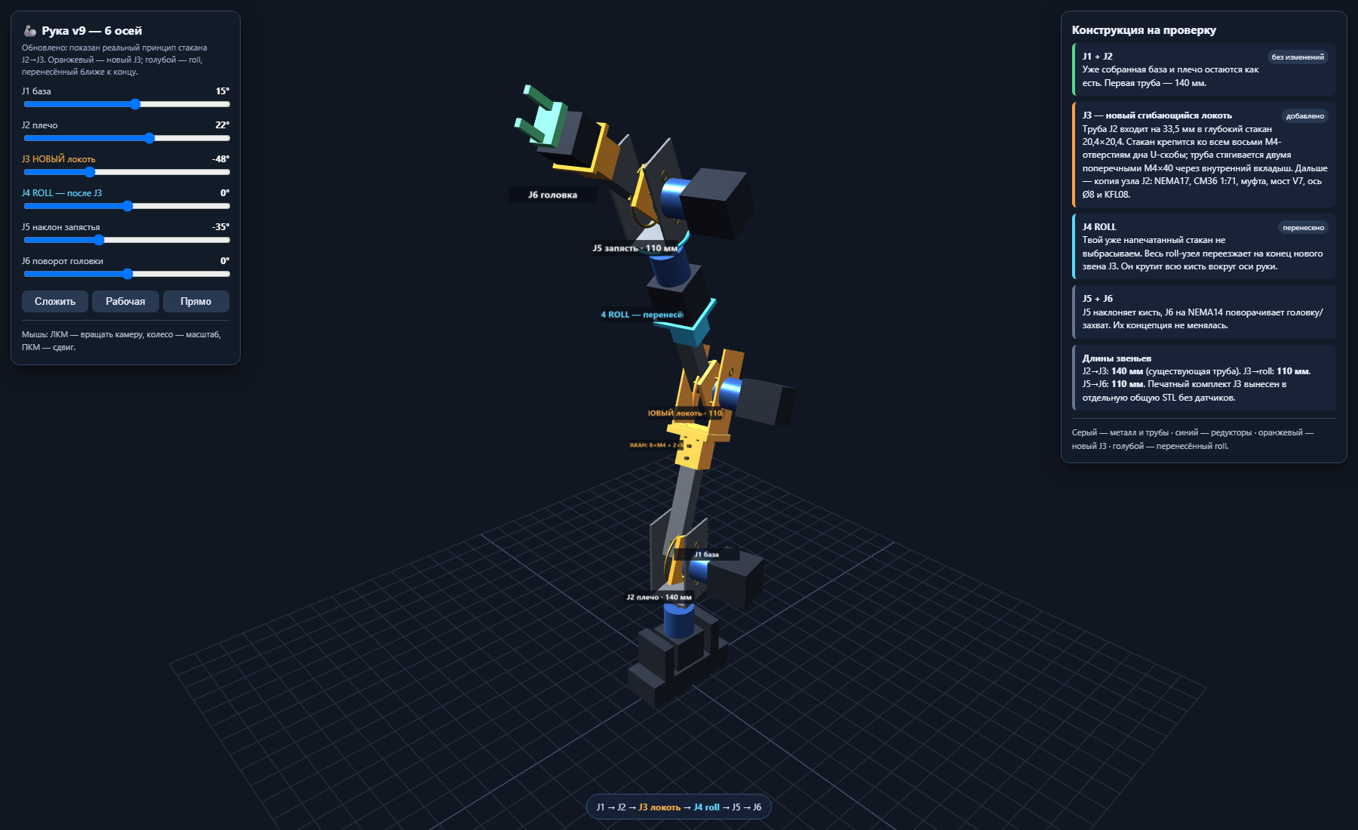
arm/base_j1/arm_v9_6axis_review_check.png
