BZKDP/robot-arm/arm/base_j1/base_arm_v1.png

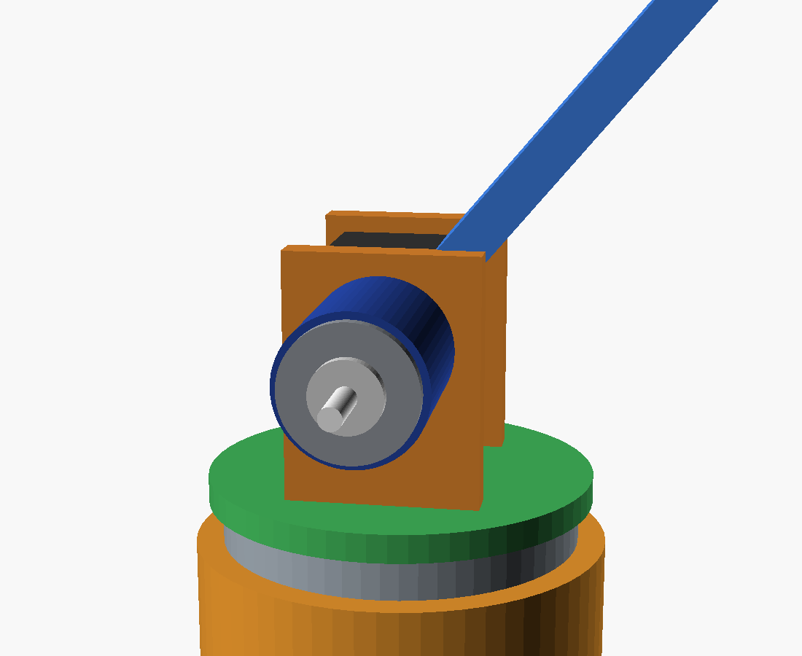
arm/base_j1/base_arm_v1.png
