BZKDP/robot-arm/arm/base_j1/base_arm_v3_back.png

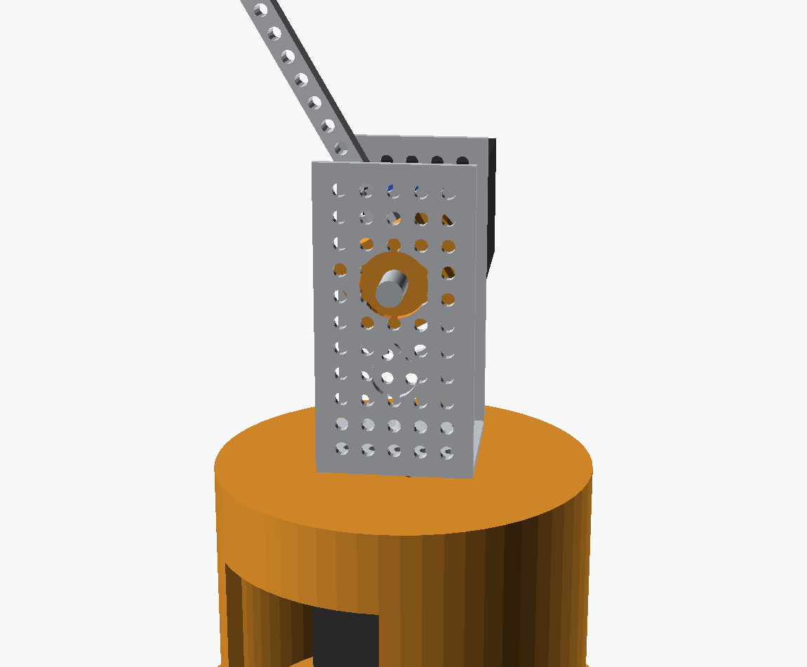
arm/base_j1/base_arm_v3_back.png
