BZKDP/robot-arm/arm/base_j1/base_j1_cutaway.png

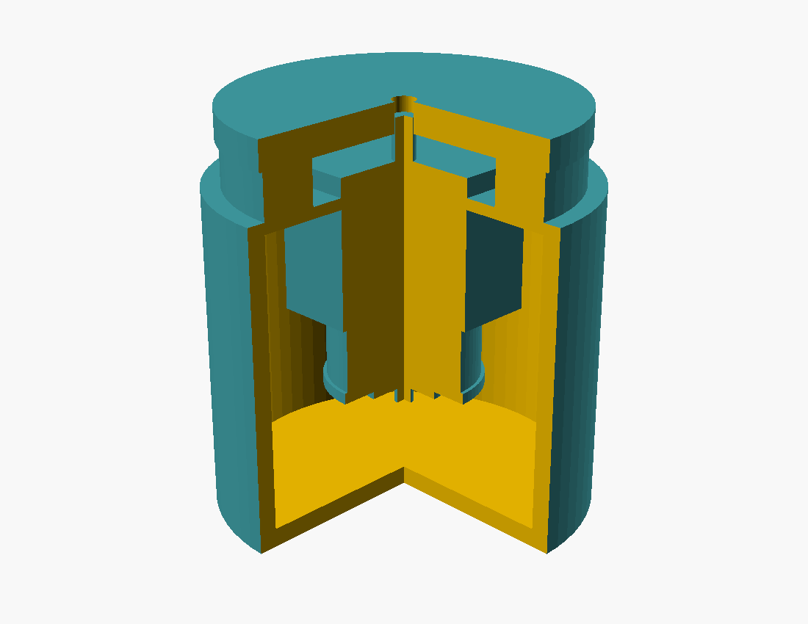
arm/base_j1/base_j1_cutaway.png
