BZKDP/robot-arm/arm/coffee_view1.png

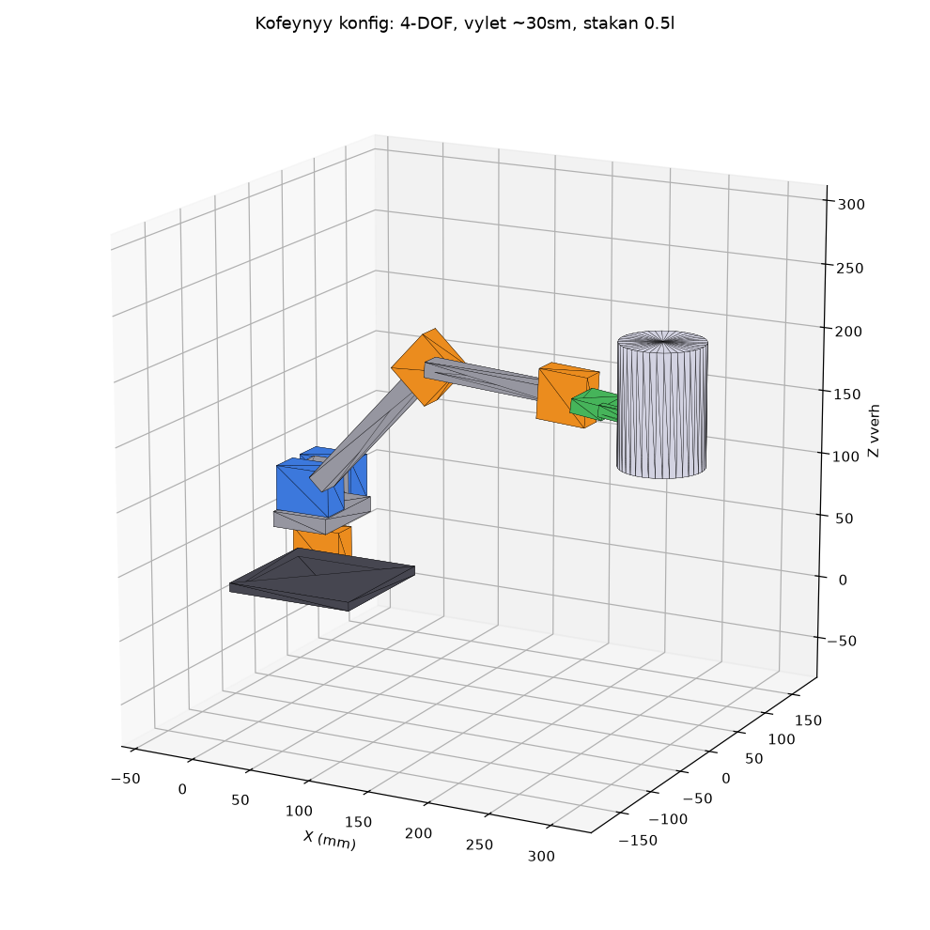
arm/coffee_view1.png
