BZKDP/robot-arm/arm/coffee_view2.png

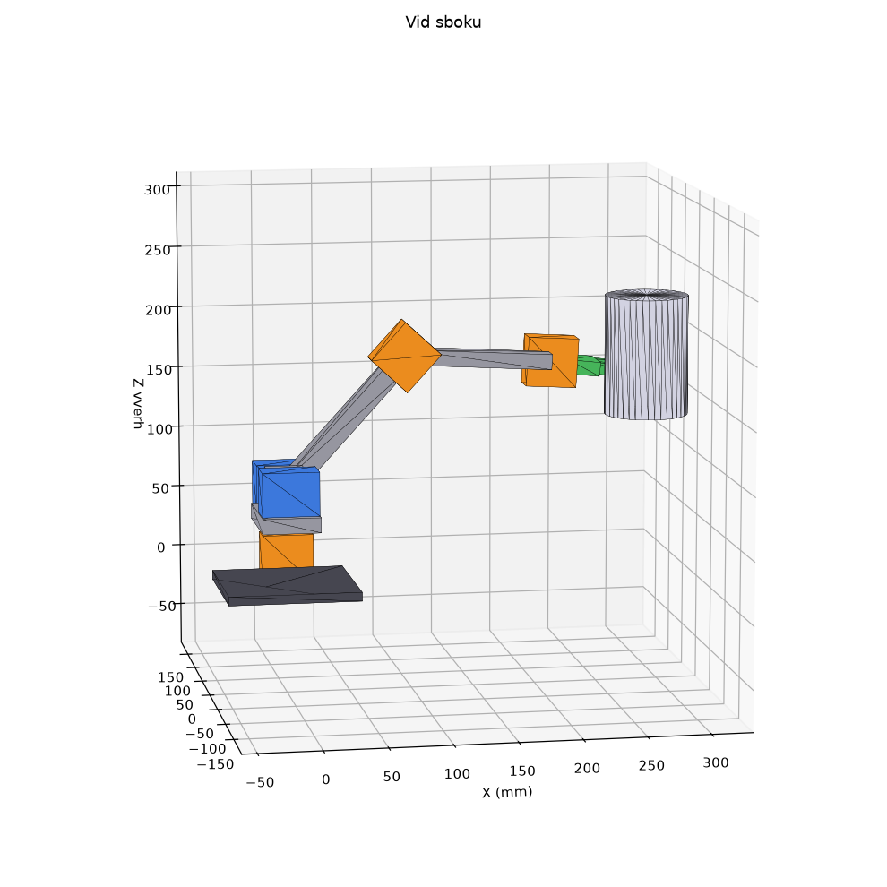
arm/coffee_view2.png
