BZKDP/robot-arm/arm/electronics_carrier_v1/ELECTRONICS_CARRIER_FINAL_INTERACTIVE_CHECK.png

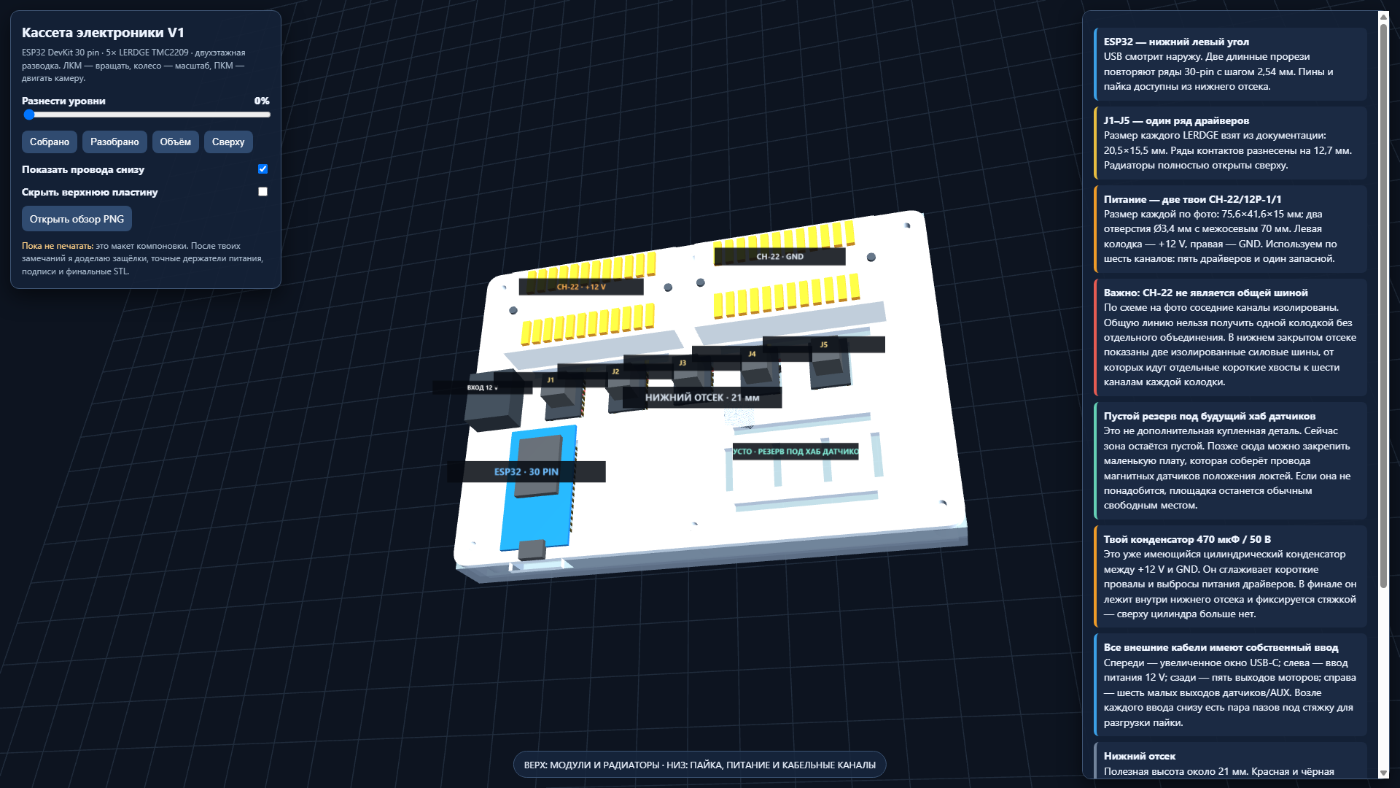
arm/electronics_carrier_v1/ELECTRONICS_CARRIER_FINAL_INTERACTIVE_CHECK.png
