BZKDP/robot-arm/arm/electronics_carrier_v1/ELECTRONICS_CARRIER_V2_PREVIEW_3D_REVIEW.png

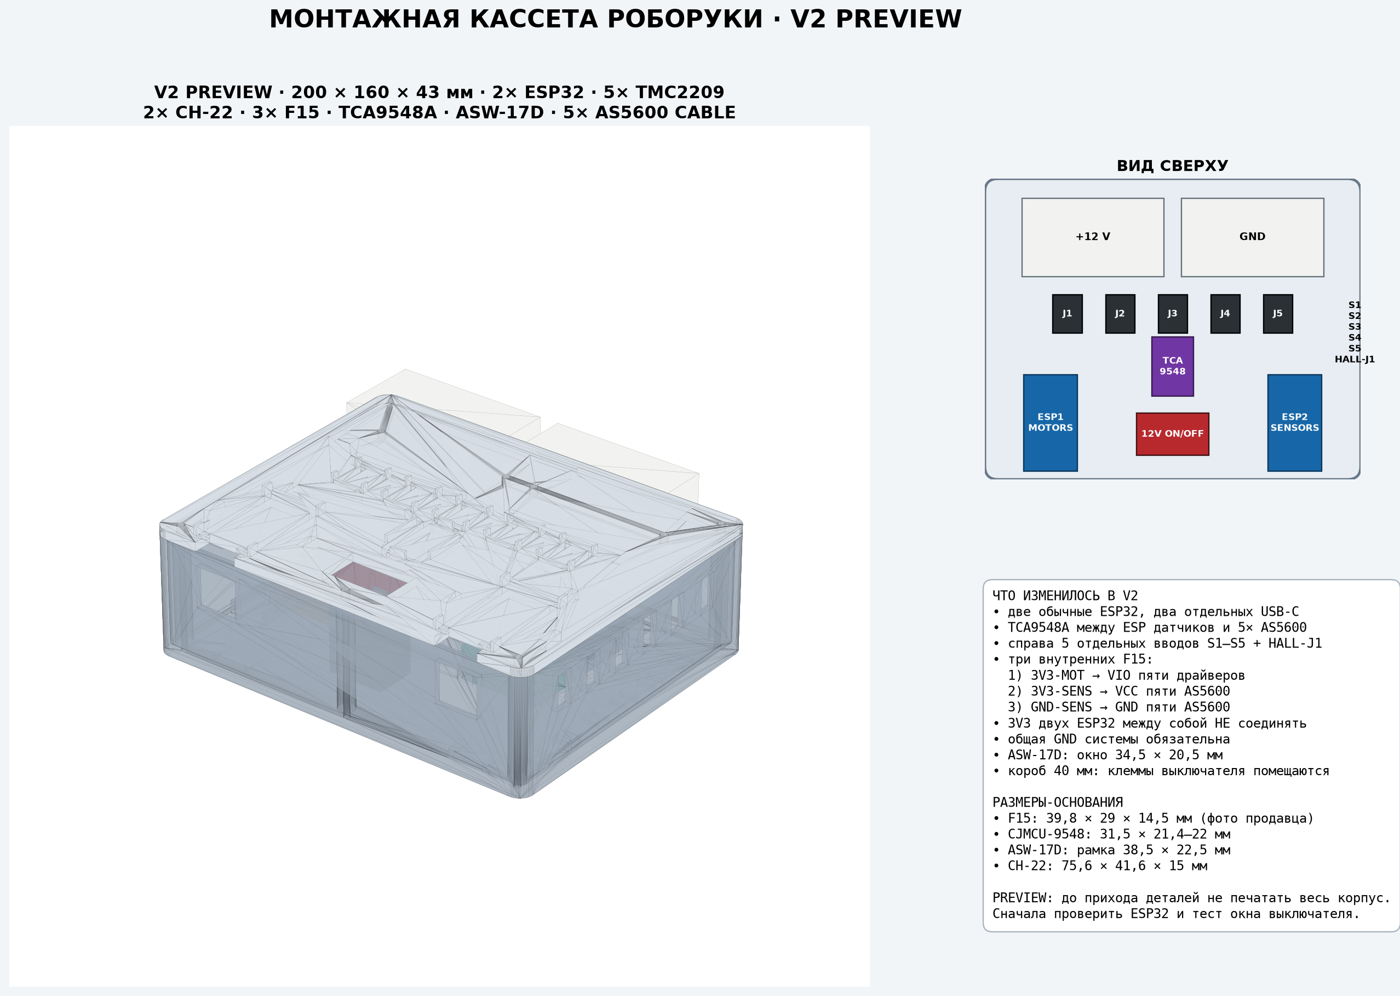
arm/electronics_carrier_v1/ELECTRONICS_CARRIER_V2_PREVIEW_3D_REVIEW.png
