BZKDP/robot-arm/arm/final_view1.png

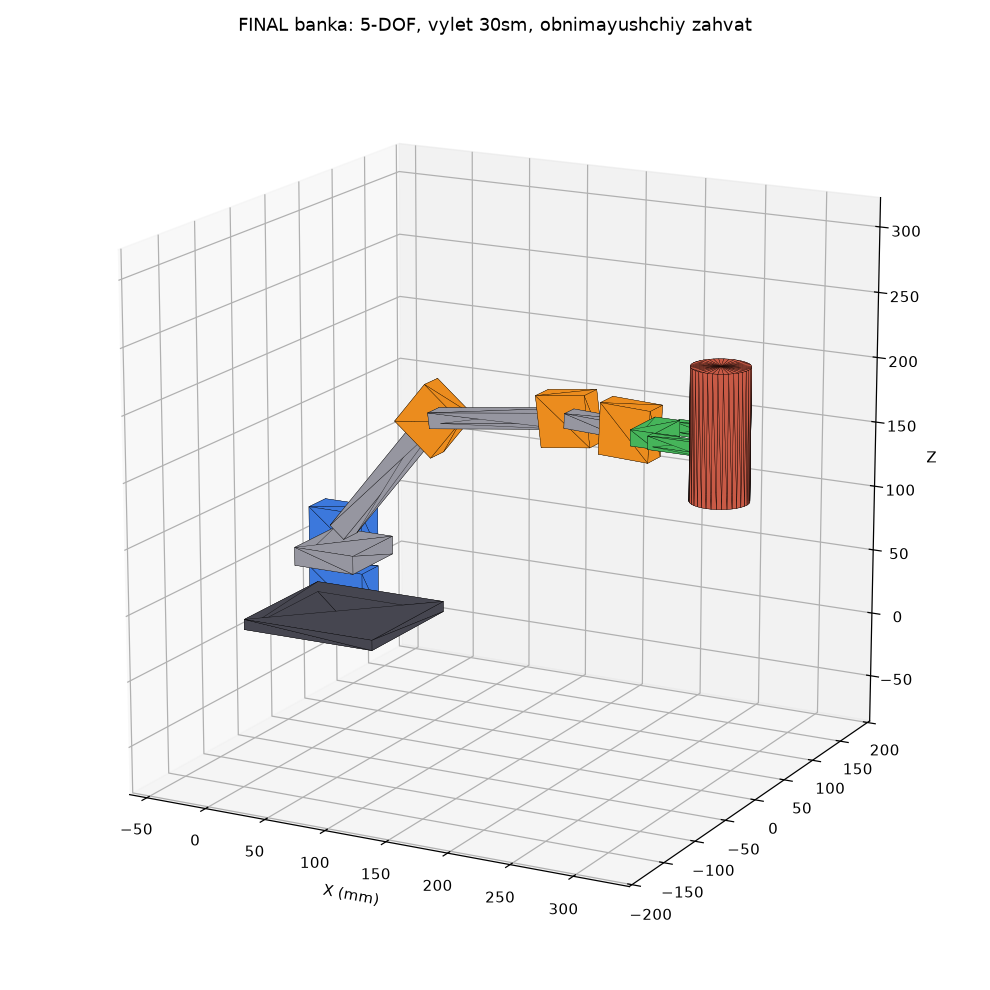
arm/final_view1.png
