BZKDP/robot-arm/arm/final_view2.png

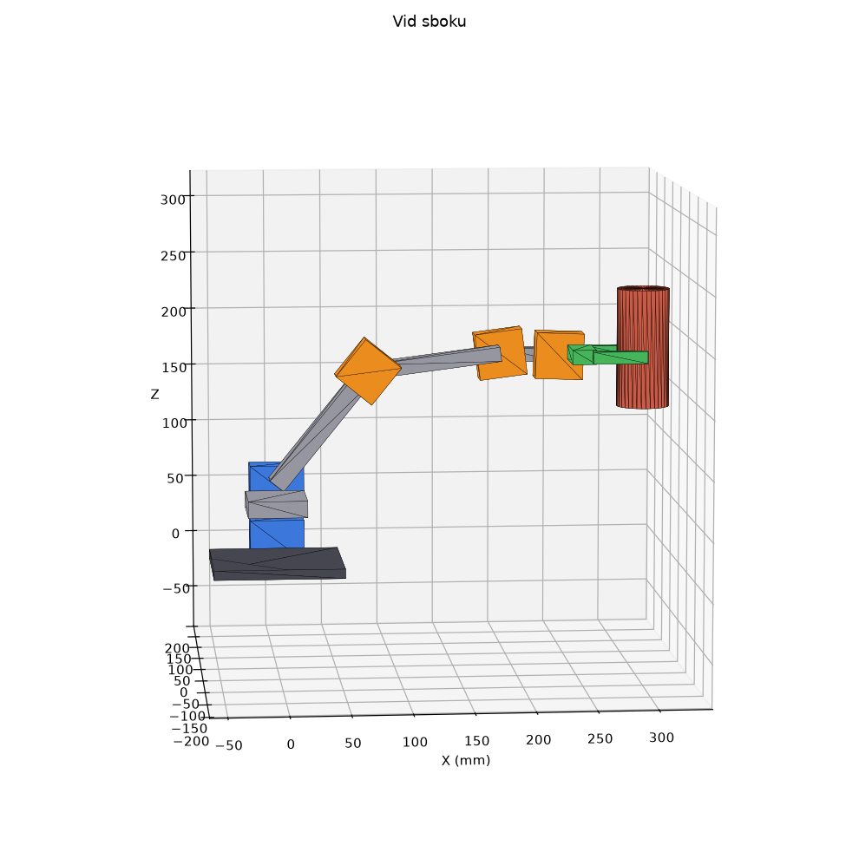
arm/final_view2.png
