BZKDP/robot-arm/arm/fit_section.png

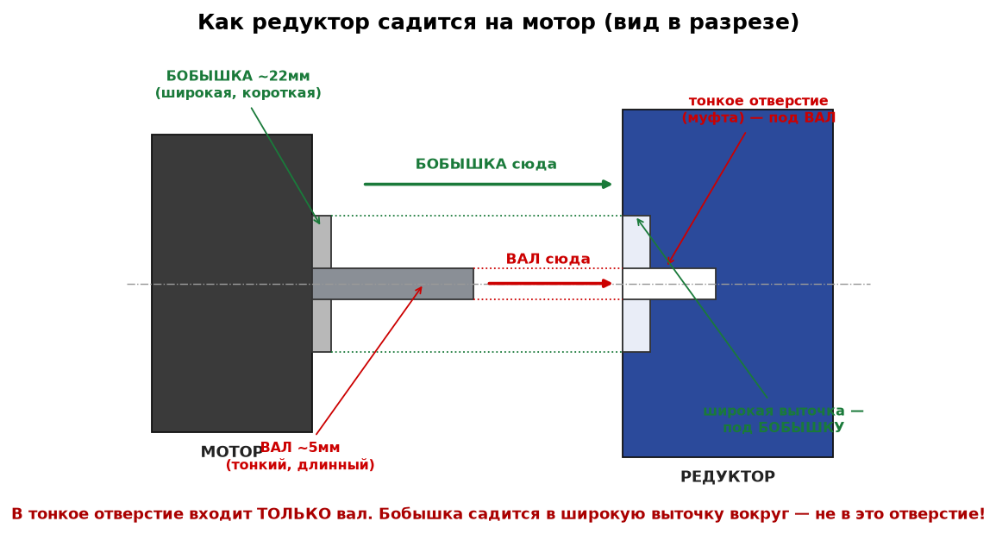
arm/fit_section.png
