BZKDP/robot-arm/arm/full_arm_v10_detail/ARM_V10_FULL_DETAIL_REVIEW.png

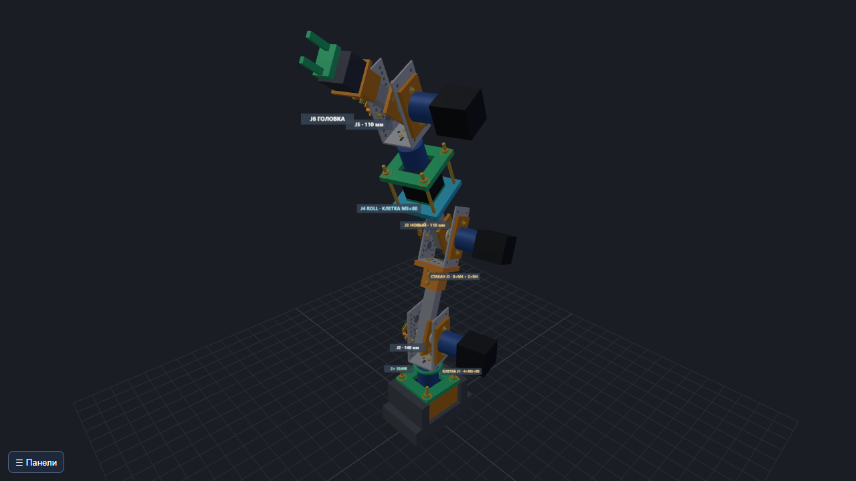
arm/full_arm_v10_detail/ARM_V10_FULL_DETAIL_REVIEW.png
