BZKDP/robot-arm/arm/joint_module_v1/joint_module_v1_preview.png

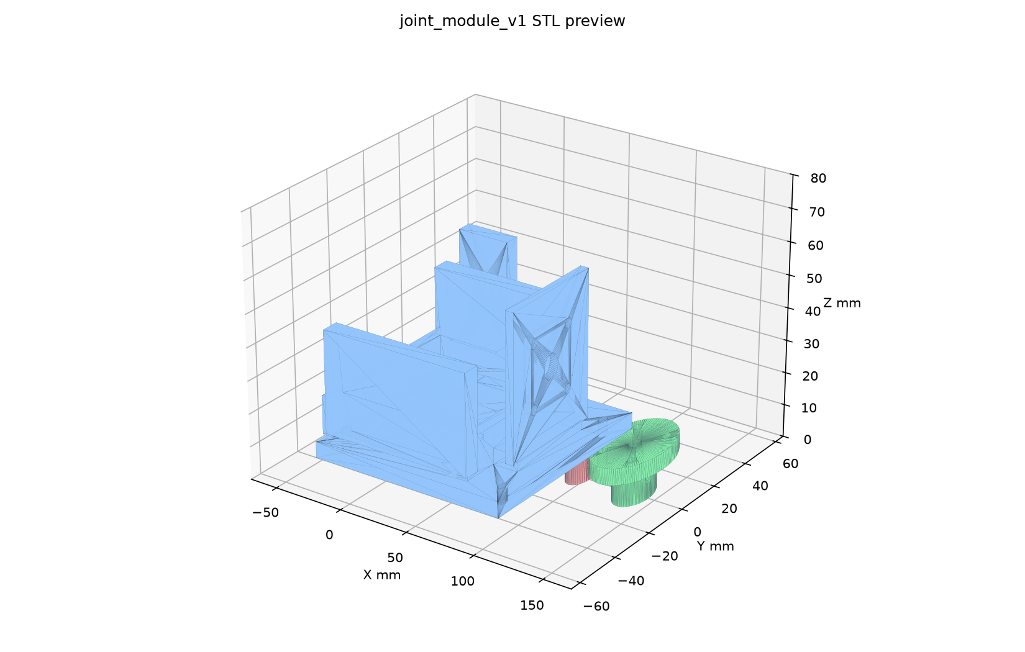
arm/joint_module_v1/joint_module_v1_preview.png
