BZKDP/robot-arm/arm/modular_five_joint_electronics_check.png

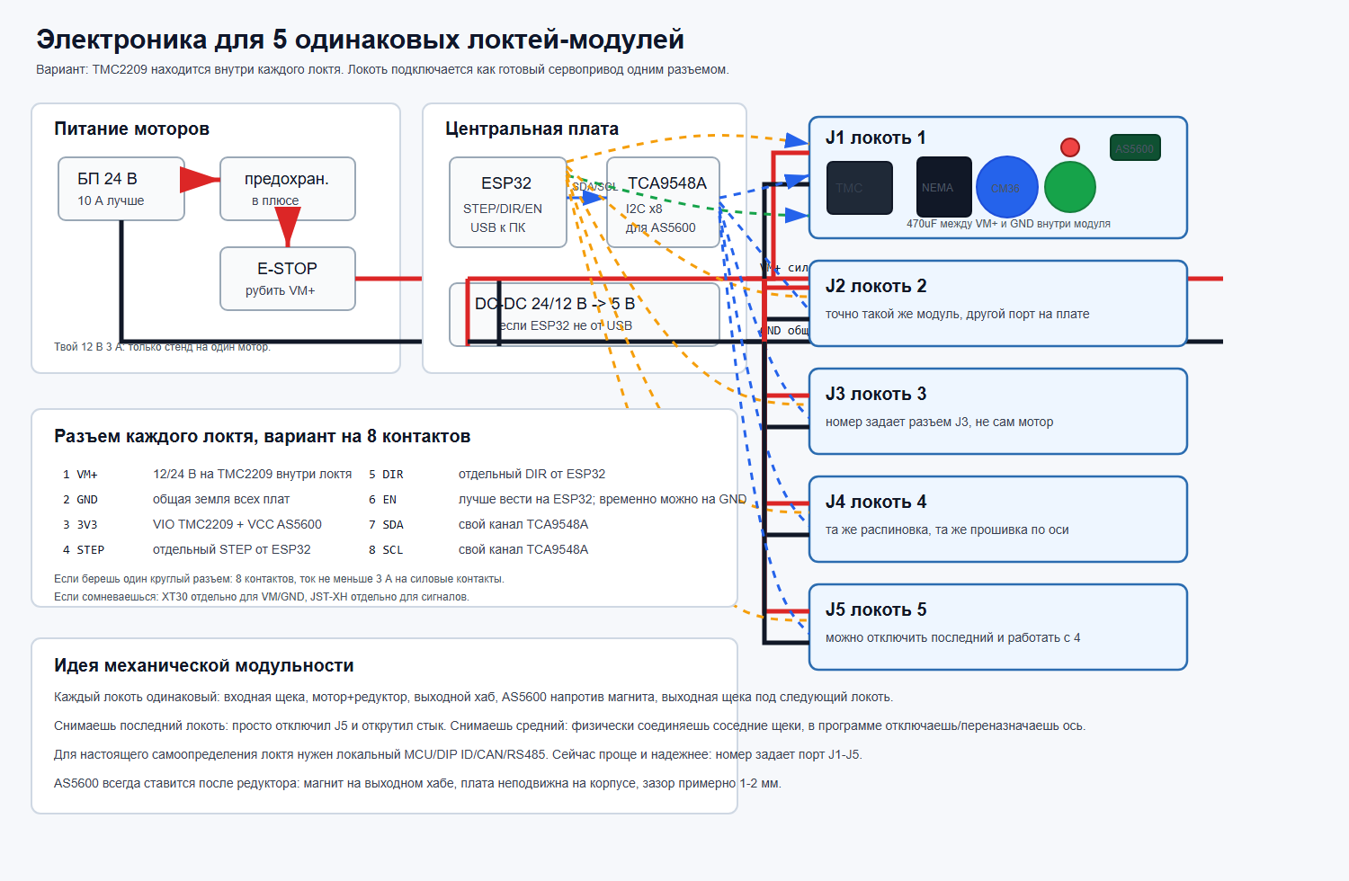
arm/modular_five_joint_electronics_check.png
