BZKDP/robot-arm/arm/modular_joint_module_3d_check.png

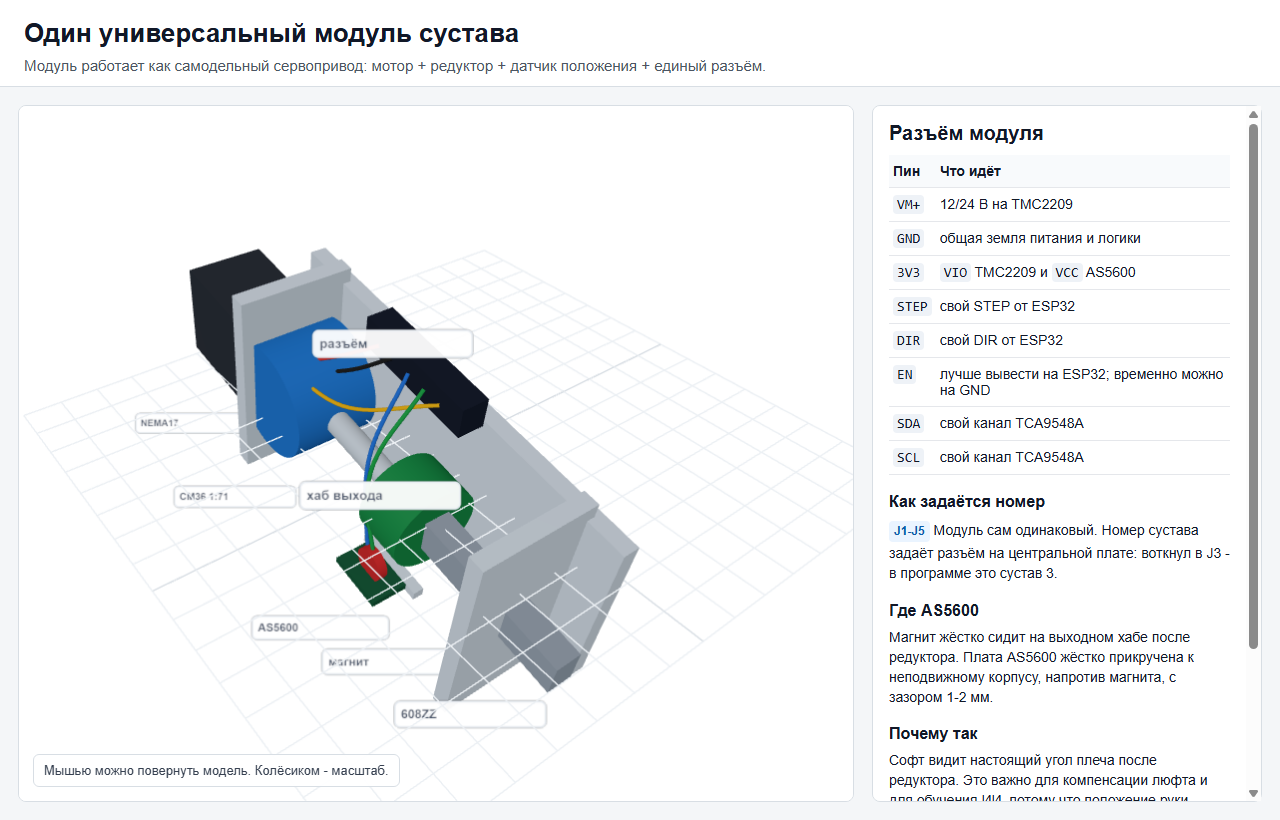
arm/modular_joint_module_3d_check.png
