BZKDP/robot-arm/pan-tilt-tracker/_c.jpg

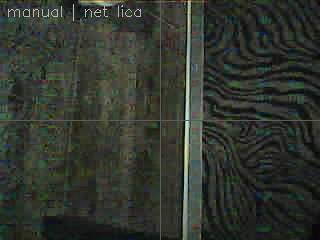
pan-tilt-tracker/_c.jpg
