BZKDP/robot-arm/pan-tilt-tracker/_chk.jpg

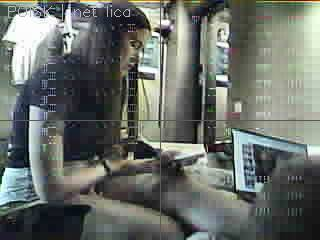
pan-tilt-tracker/_chk.jpg
