BZKDP/robot-arm/pan-tilt-tracker/_clahe.jpg

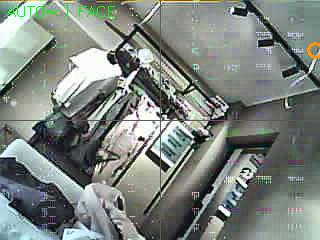
pan-tilt-tracker/_clahe.jpg
