BZKDP/robot-arm/pan-tilt-tracker/_clean.jpg

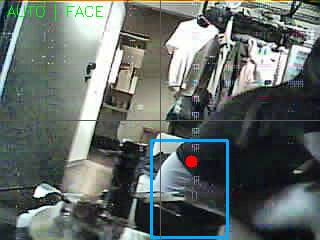
pan-tilt-tracker/_clean.jpg
