BZKDP/robot-arm/pan-tilt-tracker/_dark.jpg

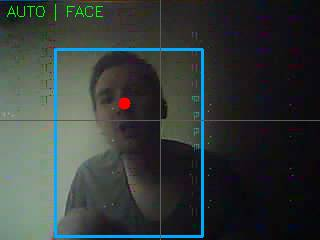
pan-tilt-tracker/_dark.jpg
