BZKDP/robot-arm/pan-tilt-tracker/_final.jpg

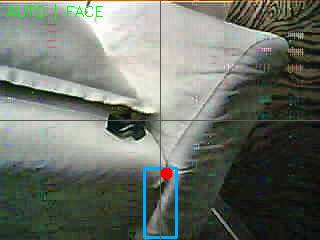
pan-tilt-tracker/_final.jpg
