BZKDP/robot-arm/pan-tilt-tracker/_frame.jpg

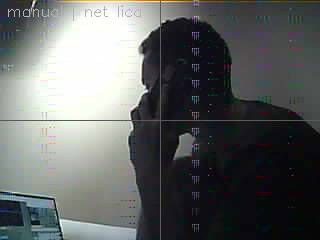
pan-tilt-tracker/_frame.jpg
