BZKDP/robot-arm/pan-tilt-tracker/_fs_CIF.jpg

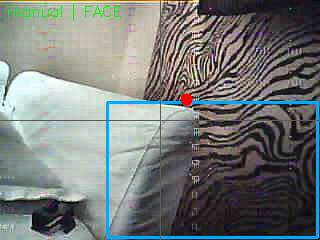
pan-tilt-tracker/_fs_CIF.jpg
