BZKDP/robot-arm/pan-tilt-tracker/_fs_HVGA.jpg

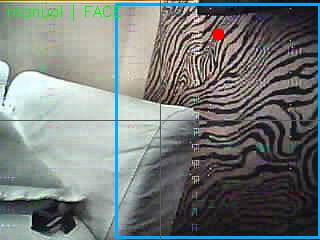
pan-tilt-tracker/_fs_HVGA.jpg
