BZKDP/robot-arm/pan-tilt-tracker/_fs_QVGA.jpg

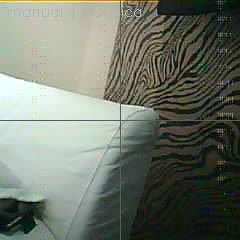
pan-tilt-tracker/_fs_QVGA.jpg
