BZKDP/robot-arm/pan-tilt-tracker/_fs_VGA.jpg

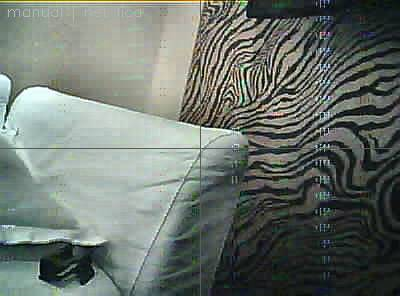
pan-tilt-tracker/_fs_VGA.jpg
