BZKDP/robot-arm/pan-tilt-tracker/_g2.jpg

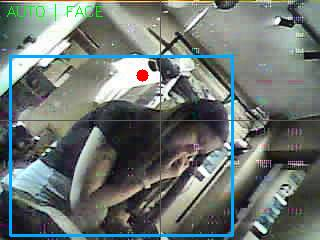
pan-tilt-tracker/_g2.jpg
