BZKDP/robot-arm/pan-tilt-tracker/_girl.jpg

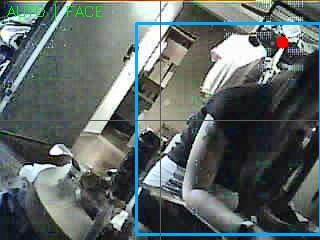
pan-tilt-tracker/_girl.jpg
