BZKDP/robot-arm/pan-tilt-tracker/_head.jpg

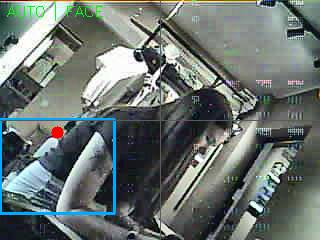
pan-tilt-tracker/_head.jpg
