BZKDP/robot-arm/pan-tilt-tracker/_light.jpg

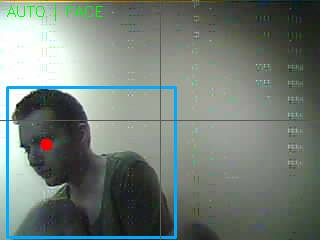
pan-tilt-tracker/_light.jpg
