BZKDP/robot-arm/pan-tilt-tracker/_lock.jpg

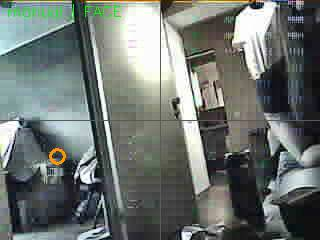
pan-tilt-tracker/_lock.jpg
