BZKDP/robot-arm/pan-tilt-tracker/_loss0.jpg

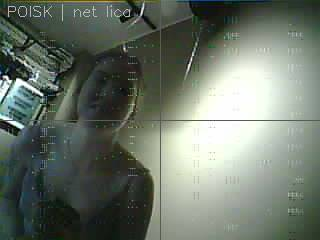
pan-tilt-tracker/_loss0.jpg
