BZKDP/robot-arm/pan-tilt-tracker/_loss1.jpg

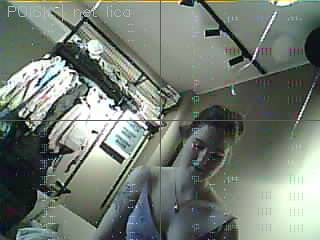
pan-tilt-tracker/_loss1.jpg
