BZKDP/robot-arm/pan-tilt-tracker/_loss2.jpg

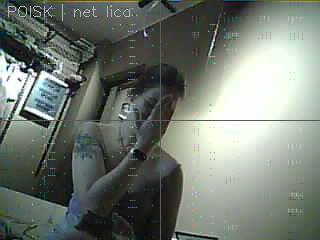
pan-tilt-tracker/_loss2.jpg
