BZKDP/robot-arm/pan-tilt-tracker/_loss3.jpg

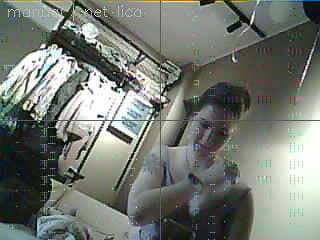
pan-tilt-tracker/_loss3.jpg
