BZKDP/robot-arm/pan-tilt-tracker/_loss4.jpg

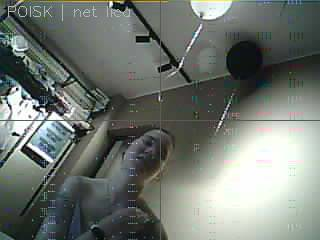
pan-tilt-tracker/_loss4.jpg
