BZKDP/robot-arm/pan-tilt-tracker/_loss5.jpg

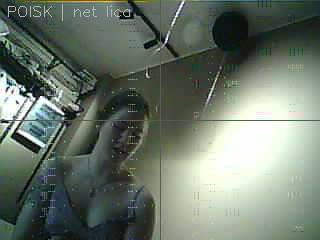
pan-tilt-tracker/_loss5.jpg
