BZKDP/robot-arm/pan-tilt-tracker/_m0.jpg

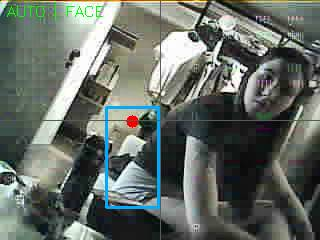
pan-tilt-tracker/_m0.jpg
