BZKDP/robot-arm/pan-tilt-tracker/_m1.jpg

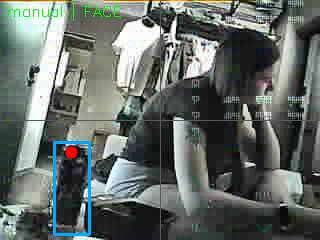
pan-tilt-tracker/_m1.jpg
