BZKDP/robot-arm/pan-tilt-tracker/_m2.jpg

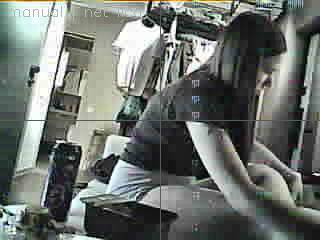
pan-tilt-tracker/_m2.jpg
