BZKDP/robot-arm/pan-tilt-tracker/_m3.jpg

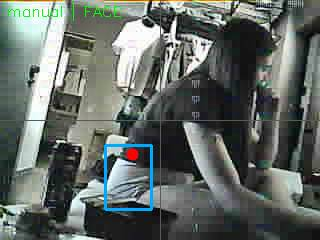
pan-tilt-tracker/_m3.jpg
