BZKDP/robot-arm/pan-tilt-tracker/_m4.jpg

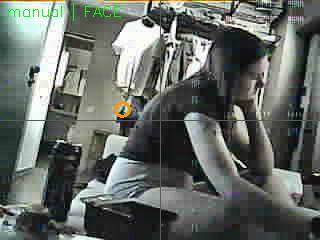
pan-tilt-tracker/_m4.jpg
