BZKDP/robot-arm/pan-tilt-tracker/_m5.jpg

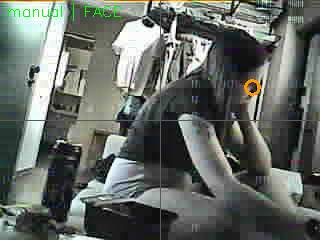
pan-tilt-tracker/_m5.jpg
