BZKDP/robot-arm/pan-tilt-tracker/_n2.jpg

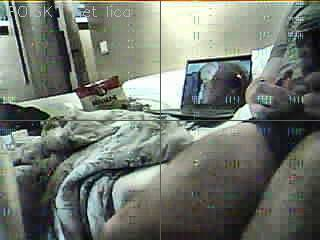
pan-tilt-tracker/_n2.jpg
