BZKDP/robot-arm/pan-tilt-tracker/_n3.jpg

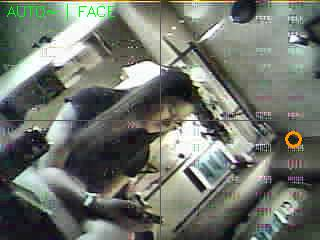
pan-tilt-tracker/_n3.jpg
