BZKDP/robot-arm/pan-tilt-tracker/_now.jpg

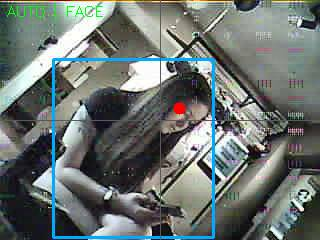
pan-tilt-tracker/_now.jpg
