BZKDP/robot-arm/pan-tilt-tracker/_q14.jpg

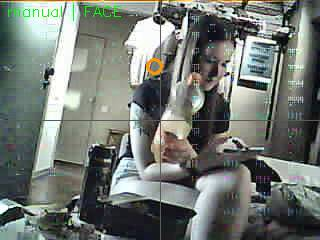
pan-tilt-tracker/_q14.jpg
