BZKDP/robot-arm/pan-tilt-tracker/_q28.jpg

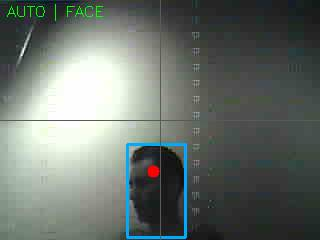
pan-tilt-tracker/_q28.jpg
