BZKDP/robot-arm/pan-tilt-tracker/_q.jpg

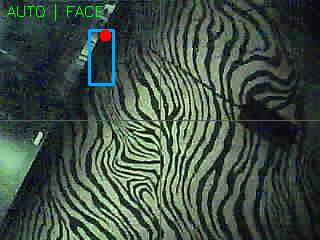
pan-tilt-tracker/_q.jpg
