BZKDP/robot-arm/pan-tilt-tracker/_see.jpg

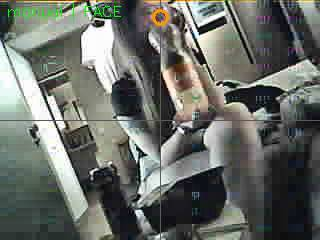
pan-tilt-tracker/_see.jpg
