BZKDP/robot-arm/pan-tilt-tracker/_t0.jpg

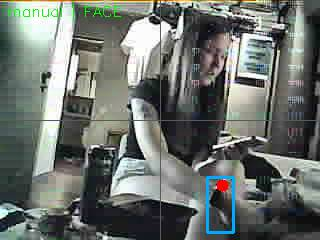
pan-tilt-tracker/_t0.jpg
