BZKDP/robot-arm/pan-tilt-tracker/_t1.jpg

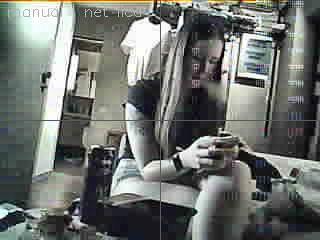
pan-tilt-tracker/_t1.jpg
