BZKDP/robot-arm/pan-tilt-tracker/_t5.jpg

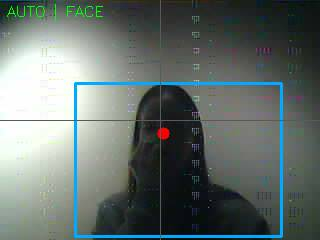
pan-tilt-tracker/_t5.jpg
