BZKDP/robot-arm/pan-tilt-tracker/_v.jpg

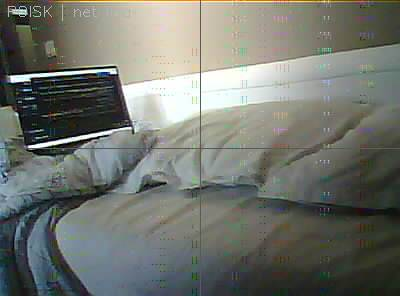
pan-tilt-tracker/_v.jpg
