BZKDP/robot-arm/pan-tilt-tracker/twin/align.png

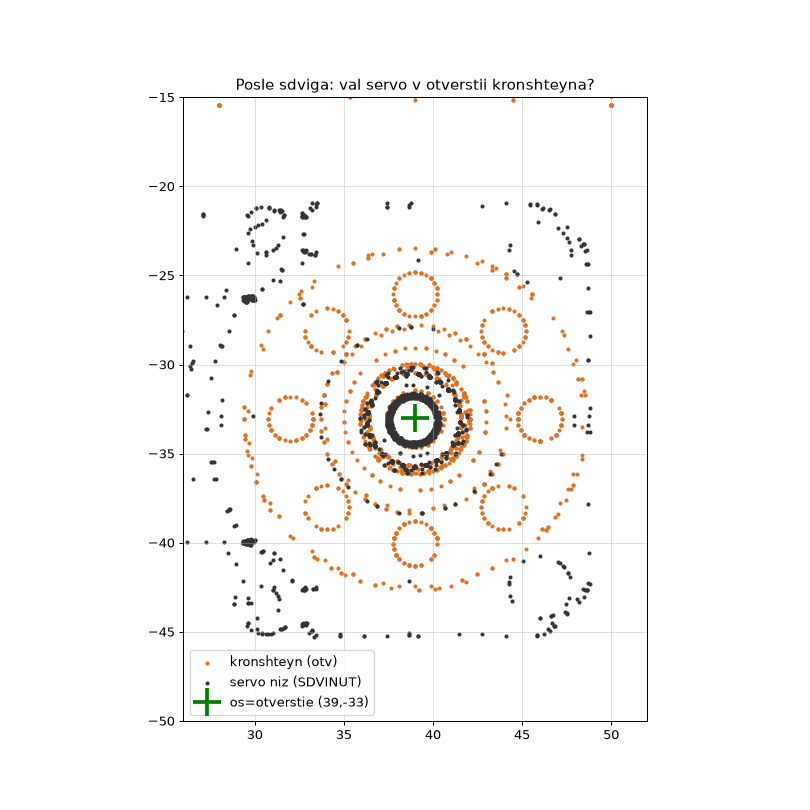
pan-tilt-tracker/twin/align.png
