BZKDP/robot-arm/pan-tilt-tracker/twin/axis_check.png

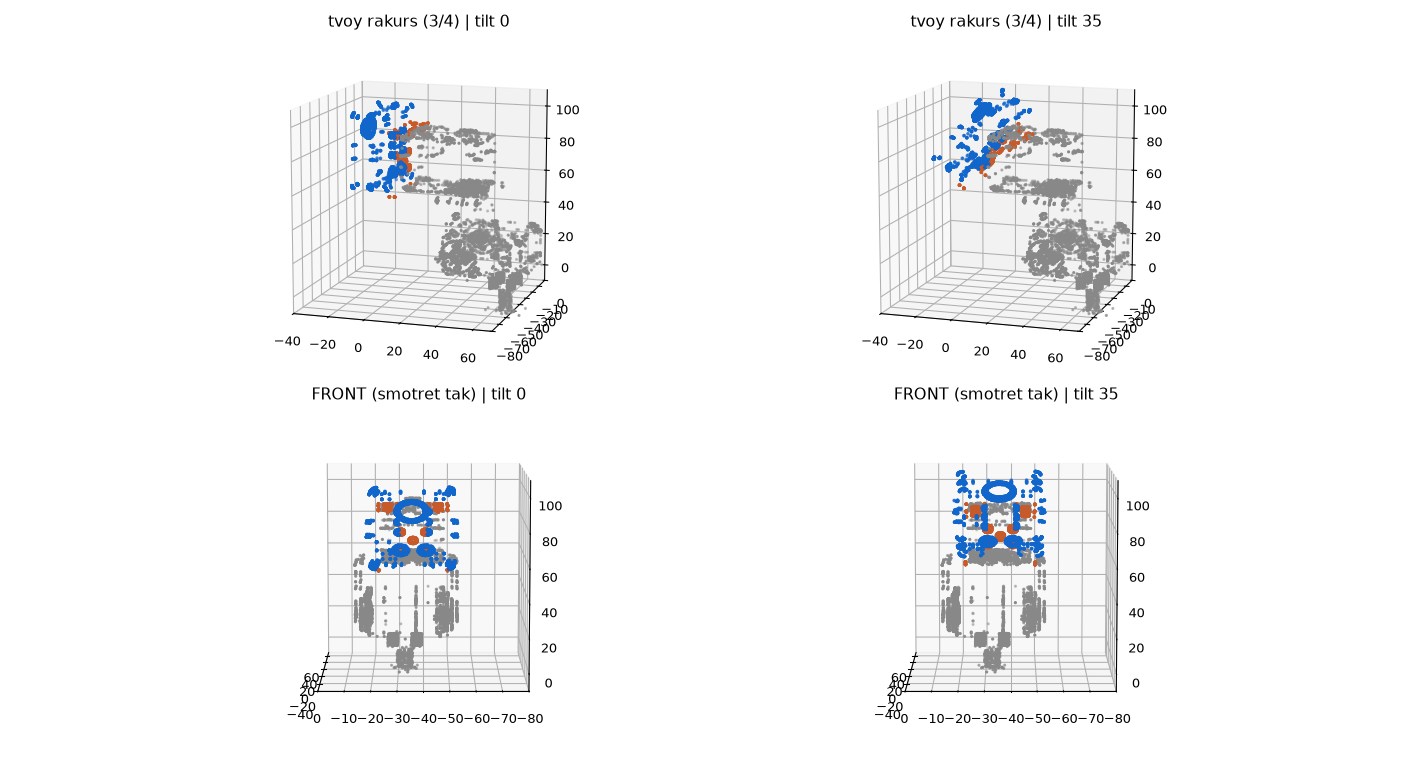
pan-tilt-tracker/twin/axis_check.png
