BZKDP/robot-arm/pan-tilt-tracker/twin/brk_hole.png

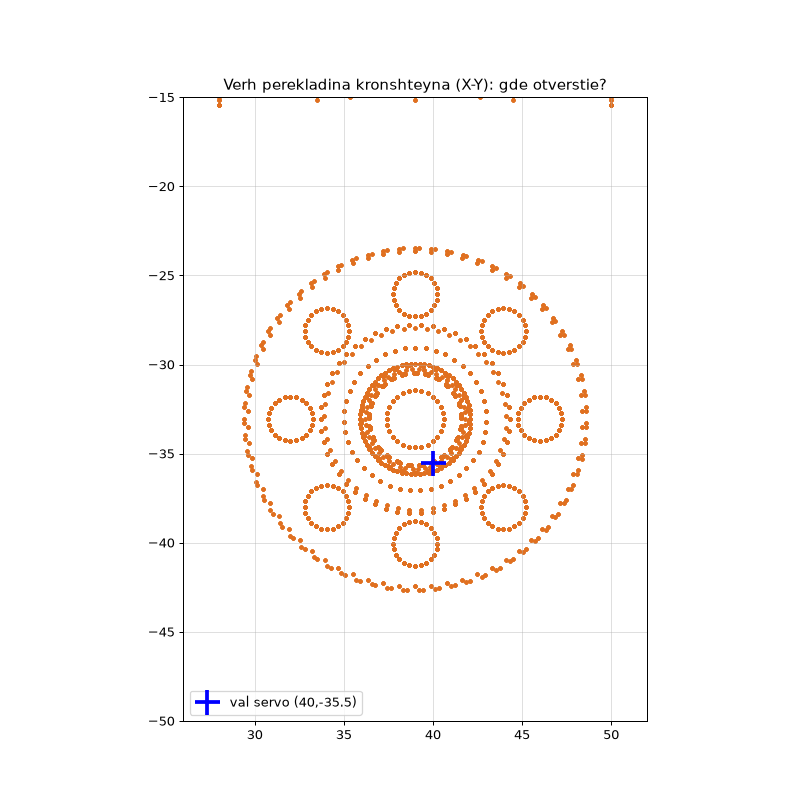
pan-tilt-tracker/twin/brk_hole.png
