BZKDP/robot-arm/pan-tilt-tracker/twin/horn.png

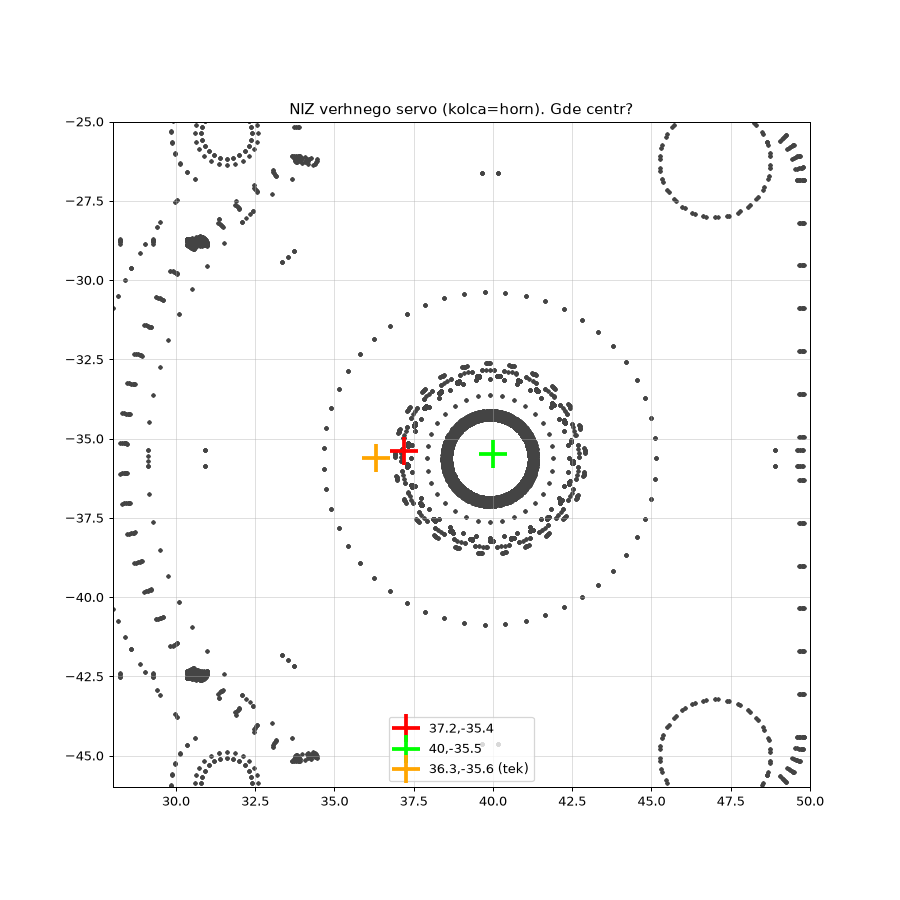
pan-tilt-tracker/twin/horn.png
