BZKDP/robot-arm/pan-tilt-tracker/twin/kin_check.png

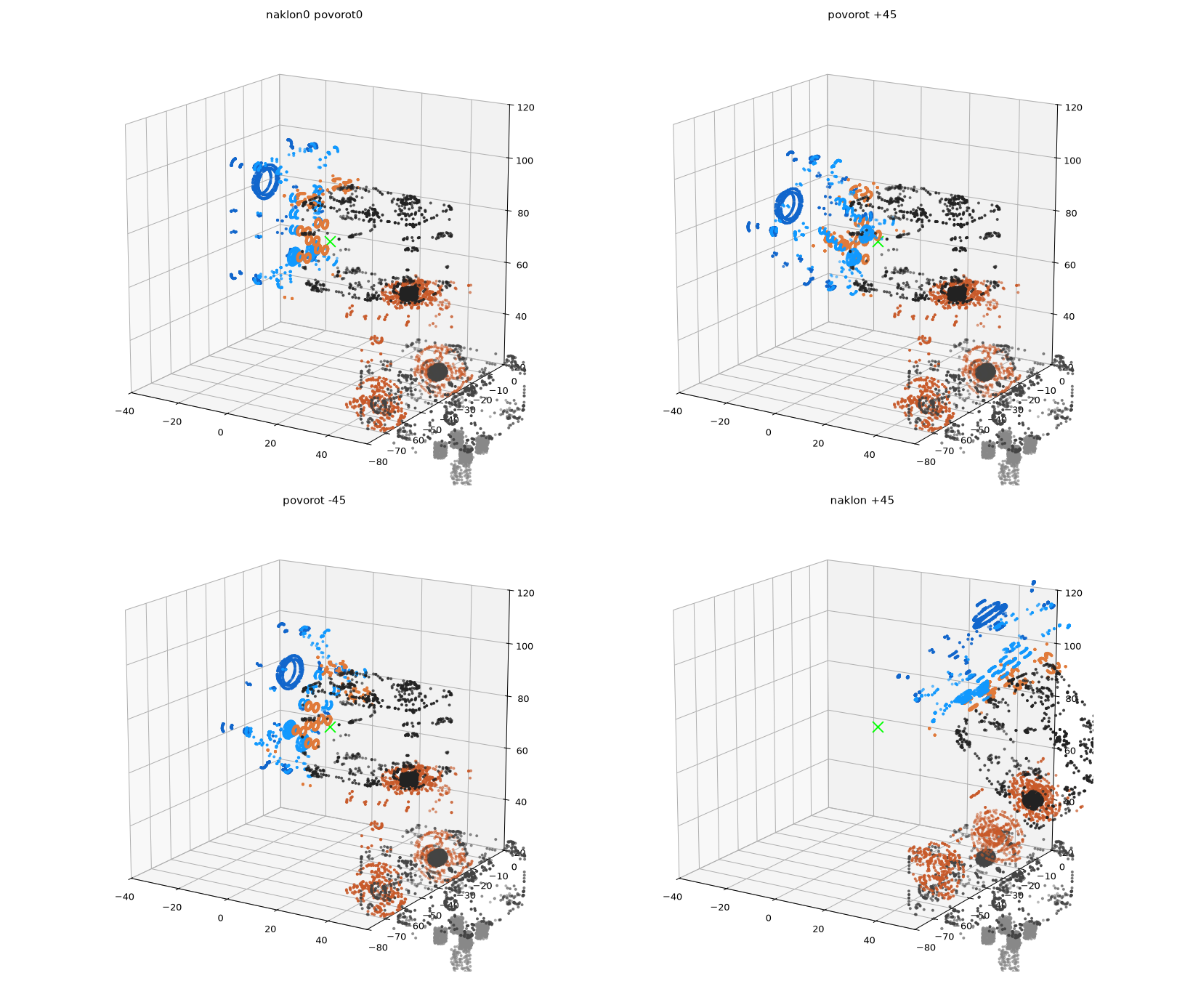
pan-tilt-tracker/twin/kin_check.png
