BZKDP/robot-arm/pan-tilt-tracker/twin/seat.png

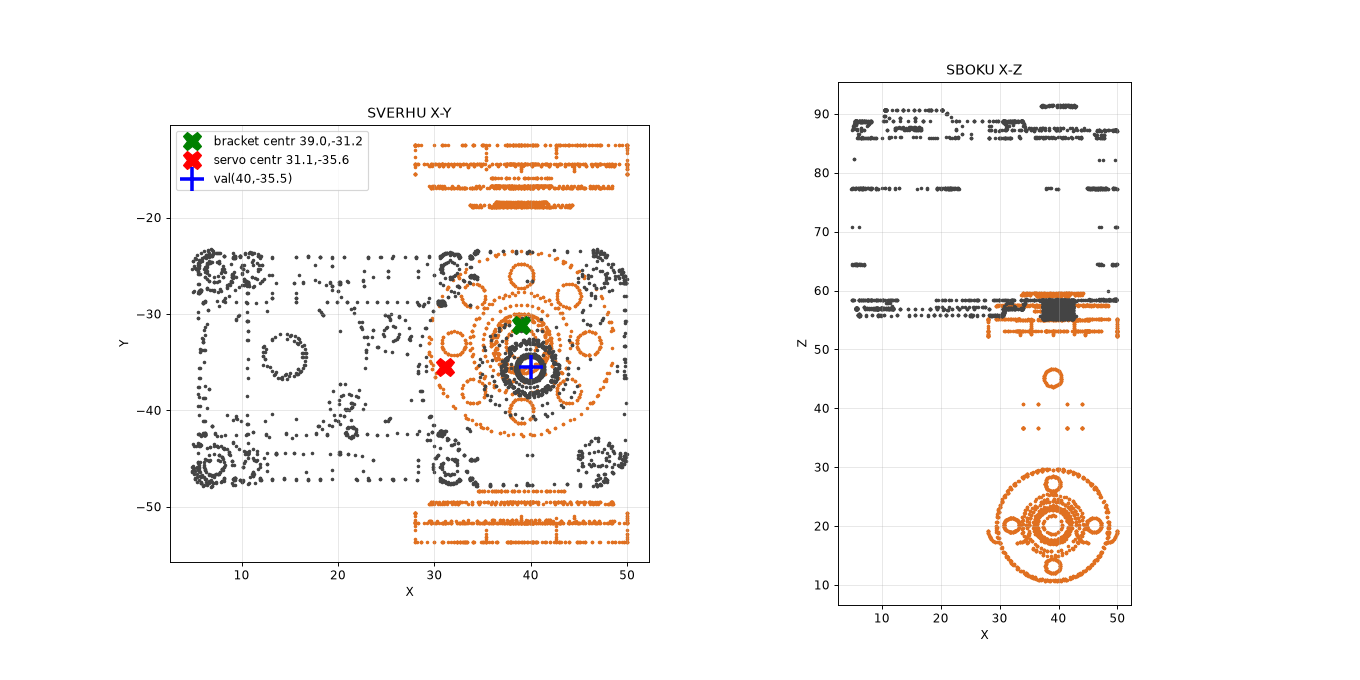
pan-tilt-tracker/twin/seat.png
