BZKDP/robot-arm/pan-tilt-tracker/twin/viz.png

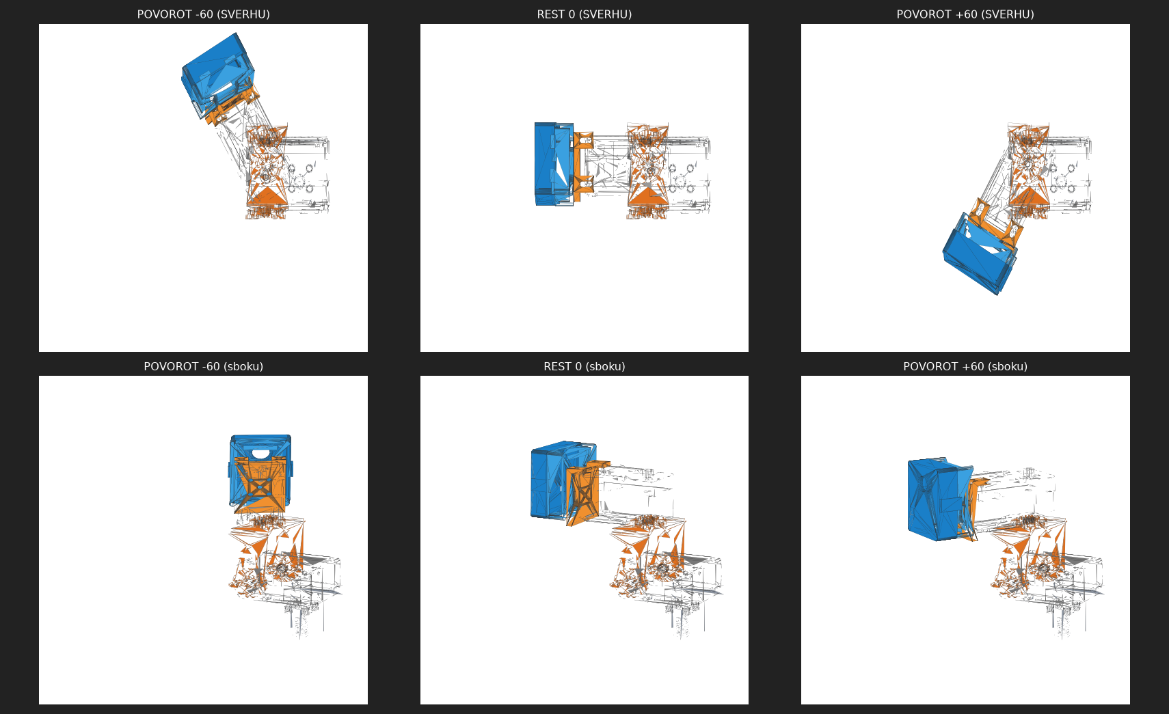
pan-tilt-tracker/twin/viz.png
