BZKDP/robot-arm/pan-tilt-tracker/twin/yaw_top.png

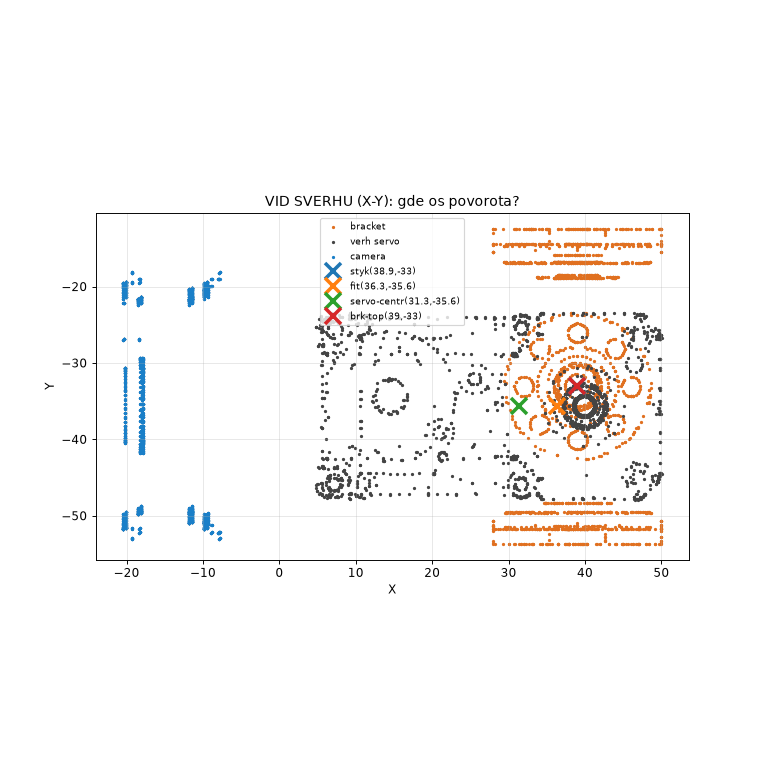
pan-tilt-tracker/twin/yaw_top.png
