BZKDP/robot-arm/vacuum/cup_holder_preview.png

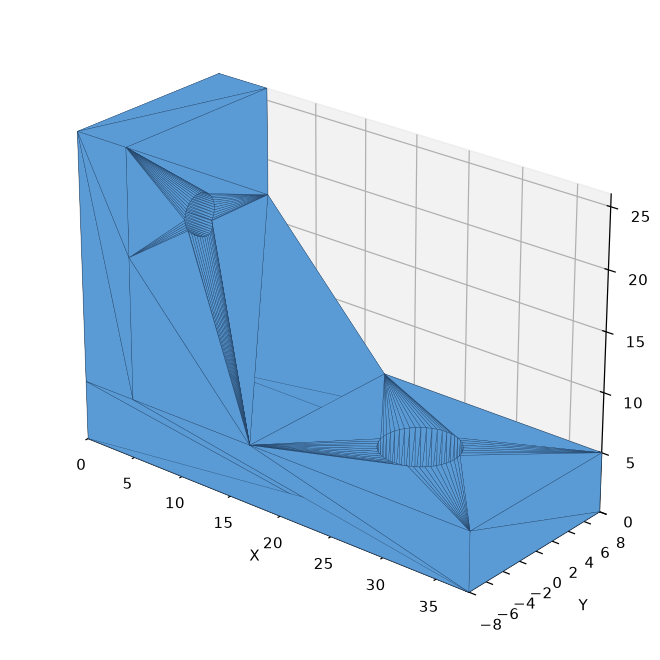
vacuum/cup_holder_preview.png
