BZKDP/robot-arm/BOM.md

# Лист сборки — робо-рука на платформе

Статусы: ✅ есть · 🚚 заказано (едет) · 🛒 докупить · 🖨 напечатать сам

Обратная связь = **вариант 🅑**: TMC2209 (драйверы) + AS5600 (энкодеры на выходе) + ESP32 (один мозг). Плаг-ин: винтовые клеммники + QWIIC, минимум пайки.

---

## 1. САМА РУКА (структура + приводы + электроника)

### Механика / структура
| Деталь | Кол-во | Статус |
|---|---|---|
| NEMA 17 (17HS4401) шаговый | 5 | 1 🚚 + 4 🛒 |
| Планетарный редуктор CM36 1:71 (42мм) | 5 | 🚚 |
| U-кронштейн алюминий (вилка сустава) | 4 | 🚚 |
| Балка алюм. 4×8×184мм (звенья/плечи) | ~6 | 🚚 |
| Подшипник фланцевый KFL08 (вторая опора pitch-суставов) | 4–6 | ✅ ПРИЕХАЛ (на каждом локте) |
| Металл. фланцевая муфта Ø8 (D-профиль) | 4 | ✅ есть/едет (печатная — только времянка) |
| Стаб-ось: пруток Ø8 (~25мм) или болт М8 гладкий — в подшипник | 4–6 | 🛒 хозмаг (не Али) |
| Крепёж: винты M3/M4, гайки, стойки | набор | 🛒 |
| Филамент PETG/PLA+ (переходники, хабы, гнёзда) | 1 кат. | 🛒 |
| **Подшипник взамен мебельного круга J4-roll** (61811 55×72×9 → шпиндель 2×30202 → RB4510) | 1 | 🛒 план 04.08 |
| База J1 — жёстко зажата в металлических тисках (свой подшипник не нужен) | — | ✅ решено 04.08 |
| 3D-печать: переходник-плита + хаб + гнездо 608 (×суставы) | — | 🖨 |

### Электроника — управление + обратная связь
| Деталь | Кол-во | Статус |
|---|---|---|
| ESP32 (нижний мозг руки) | 1 | ✅ (есть куча) |
| — опц. ESP32-**S3** ради запаса пинов | 1 | 🛒 (не обязательно) |
| TMC2209 драйвер (5-pack) | 5 | 🚚/🛒 |
| AS5600 энкодер + диаметр. магнит | 5 | 🛒 |
| TCA9548A мультиплексор I2C | 1 | 🛒 |

### Плаг-ин слой (чтобы не паять)
| Деталь | Кол-во | Статус |
|---|---|---|
| ESP32 плата-расширение с винт. клеммами | 1 | 🛒 |
| TMC2209 breakout с клеммником | 5 | 🛒 |
| Dupont-провода (4-жил) + гребёнки-штырьки на AS5600 (QWIIC НЕ берём) | набор | 🛒 |
| Распределитель питания — WAGO/аналог | — | ✅ есть |
| Радиаторы на TMC | — | ✅ (беру с TMC) |
| Провода, гребёнки | набор | 🛒 |

### Питание руки
| Деталь | Кол-во | Статус |
|---|---|---|
| БП 12–24В, ≥8А (на 5 моторов) | 1 | ✅ проверить / 🛒 |
| DC-DC понижайка 5В и 3.3В (логика/энкодеры) | 2 | ✅/🛒 |

### Мозг верхнего уровня
| Деталь | Кол-во | Статус |
|---|---|---|
| Мини-ПК / Raspberry Pi 5 (сайт-двойник, запись, обучение) | 1 | ✅ |
| Xbox-геймпад (телеоперация + запись движений) | 1 | 🛒 (если нет) |

> Запястье J4/J5: базово тоже NEMA17+редуктор. Альтернатива для облегчения кисти — твои **FB5118M ×3** или **STS3215 ×2** (у них ОС уже есть). Решим при сборке.

---

## 2. МАНИПУЛЯТОР (захват — end effector)
| Деталь | Кол-во | Статус |
|---|---|---|
| Манипулятор-захват под серво | 1 | 🚚 |
| Серво захвата (SG90 / MG90S) | 1 | ✅ (есть) |
| Крепление захвата к запястью | — | 🖨 |
| (позже) датчик усилия на губках | 1 | 🛒 опц. |

---

## 3. ШАССИ (собираем готовым под руку, цепляем в конце)
| Деталь | Кол-во | Статус |
|---|---|---|
| Гусеничное шасси R3 + 2× MG513 (Hall-энкодеры) | 1 | 🚚 |
| Драйвер BTS7960 (по борту) | 2 | 🚚 |
| ESP32 (реалтайм шасси: моторы+энкодеры+IMU) | 1 | ✅ |
| IMU BNO085 | 1 | 🛒 |
| Аккумулятор 3S + DC-DC для шасси | 1 | 🛒 |
| Площадка крепления руки/мини-ПК на шасси | — | 🖨/🛒 |
| Клеммники, провода | набор | 🛒 |

---

## 4. КАМЕРЫ (делаем готовность, ставим в конце)
| Деталь | Кол-во | Статус |
|---|---|---|
| USB-камера на запястье | 1 | 🛒 |
| USB-камера обзорная (сцена) | 1 | 🛒 |
| (опц.) depth-камера OAK-D / RealSense | 1 | 🛒 позже |
| Крепления камер | — | 🖨 |

---

## 5. ЛИДАР (на шасси, позже)
| Деталь | Кол-во | Статус |
|---|---|---|
| LDROBOT D500 (2D 360°, ROS2) | 1 | 🚚 |
| Крепёж лидара на платформу | — | 🖨 |

---

## Что докупить в первую очередь (для запуска РУКИ)
1. 4× NEMA17 17HS4401 (двухвальные не нужны — энкодер на выходе)
2. 5× AS5600 + магниты · 1× TCA9548A
3. TMC2209 (если 5-pack ещё не заказан)
4. 5× TMC2209 breakout-клеммник · ESP32 клеммная плата · Dupont-провода (WAGO уже есть)
5. 4–6× подшипник 608ZZ + пруток Ø8/болт М8 (хозмаг) + крепёж M3/M4
6. БП 12–24В ≥8А (если текущего мало) · филамент
7. Xbox-геймпад
