BZKDP/robot-arm/arm/printed/hall_quad_index_v3/HALL_QUAD_INDEX_V3_SHOPPING_LIST_RU.md

# Что купить для J1 + J4

## Электроника

- Установлено будет **8× SS49E**: 4 на J1 и 4 на J4. Уже есть 6, поэтому минимум докупить 2; разумно купить 4 и оставить 2 запасных. Поиск: `Honeywell SS49E линейный аналоговый датчик Холла TO-92`.
- **2× ADS1115**, по одному на сустав. Поиск: `ADS1115 модуль АЦП 16 бит 4 канала I2C`.
- **2× магнит неодимовый D3x2 мм, аксиальная намагниченность**; лучше упаковку 10 шт. Поиск: `магнит неодимовый 3x2 мм диск аксиальный`.
- По желанию 8× керамический 100 нФ для локальной развязки питания у длинных проводов. Поиск: `конденсатор керамический 0.1 мкФ 100 нФ`.

## Крепёж двух суставов

- 8× M3×12 DIN 912.
- 8× M3×6 DIN 912.
- Тонкая Kapton/PET-плёнка 0,10–0,20 мм для поджима слишком тонких клонов корпуса.

## Провод

- От каждого сустава до панели: 6 жил — 3V3, GND, OUT0, OUT1, OUT2, OUT3.
- В панели: ADS1115 → TCA9548A → сенсорная ESP32 по I2C.
