BZKDP/robot-arm/arm/printed/_current_parts_review.png

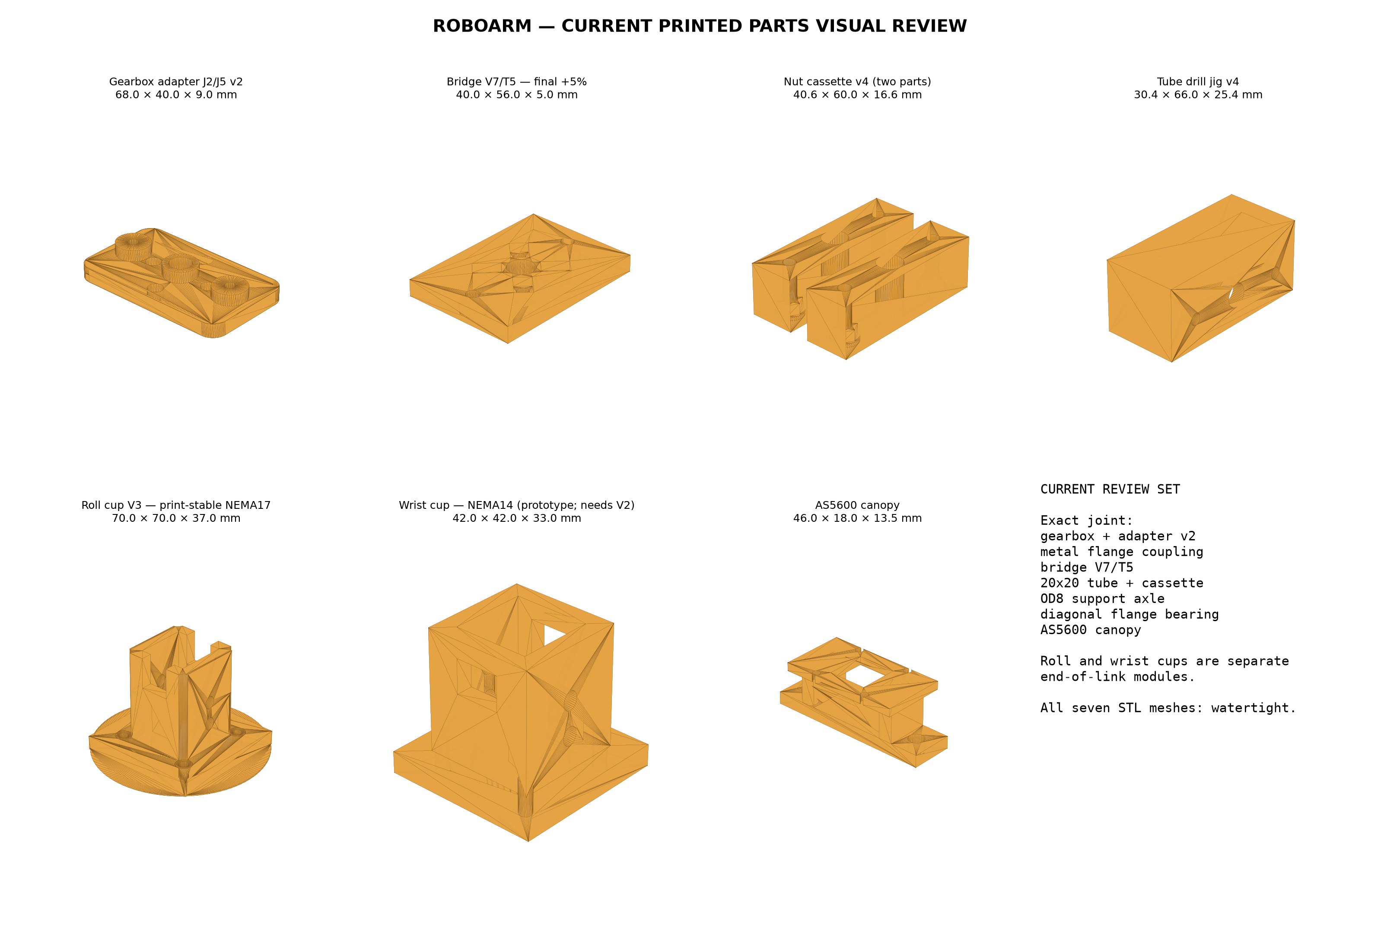
arm/printed/_current_parts_review.png
