BZKDP/robot-arm/arm/printed/_v3_parts.png

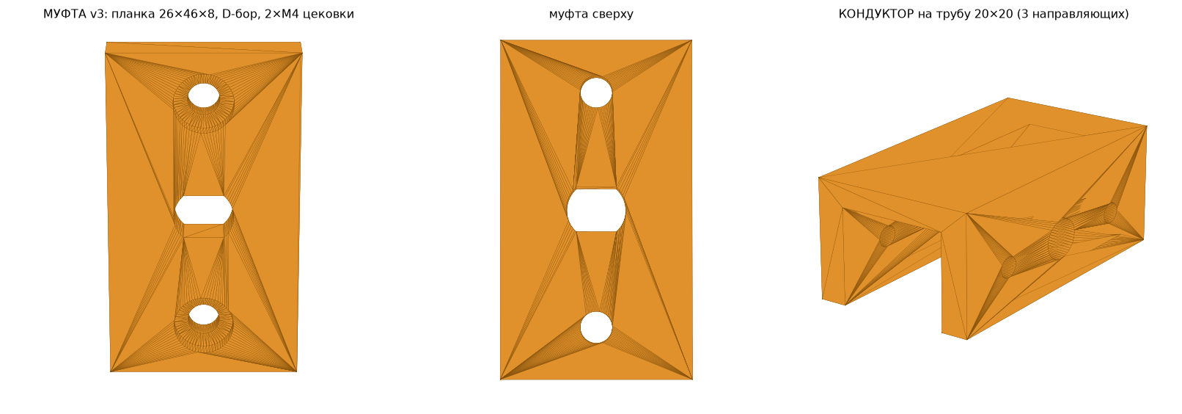
arm/printed/_v3_parts.png
