BZKDP/robot-arm/arm/printed/hall_j1_dual_index_v2/HALL_J1_DUAL_INDEX_V2_PARTS_REVIEW.png

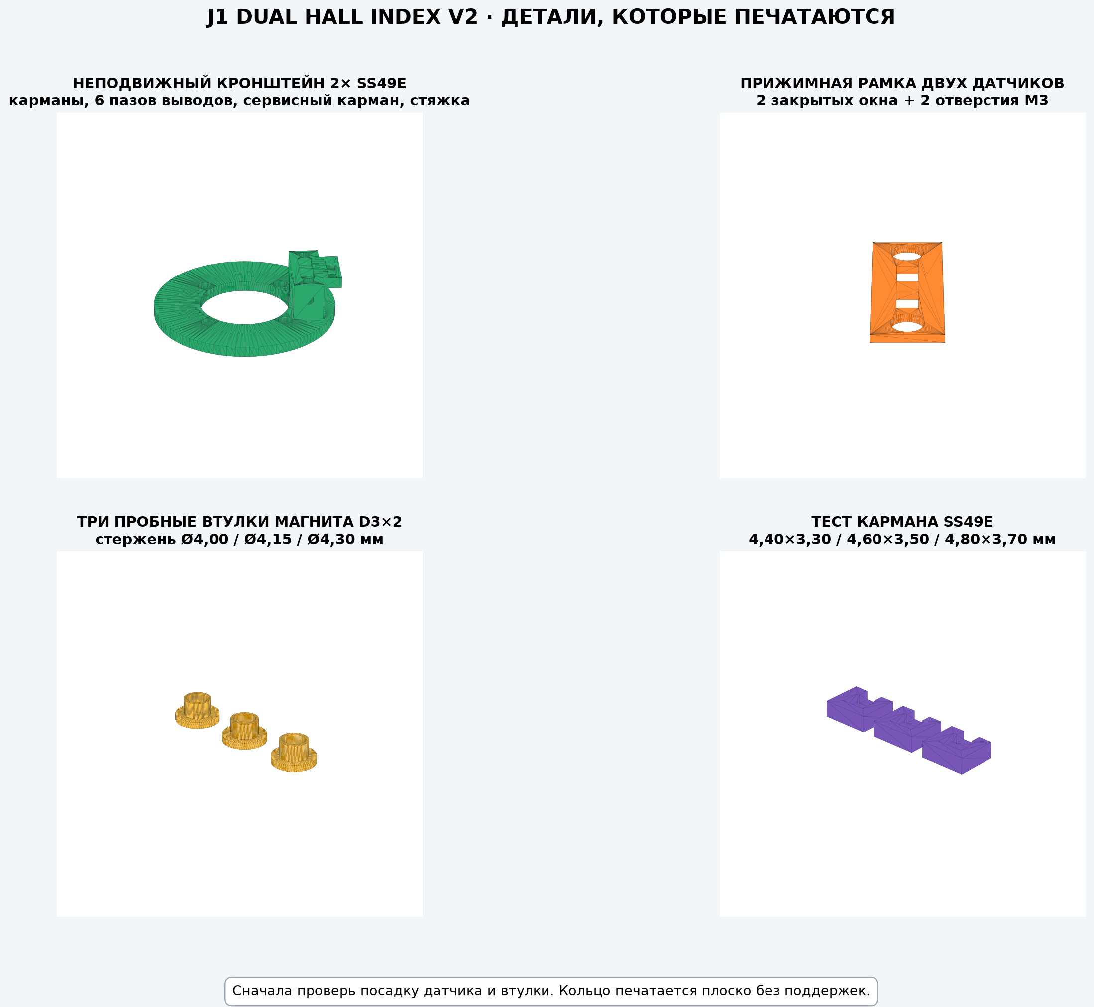
arm/printed/hall_j1_dual_index_v2/HALL_J1_DUAL_INDEX_V2_PARTS_REVIEW.png
