BZKDP/robot-arm/arm/printed/hall_j1_index_v1/HALL_J1_INDEX_V1_PARTS_REVIEW.png

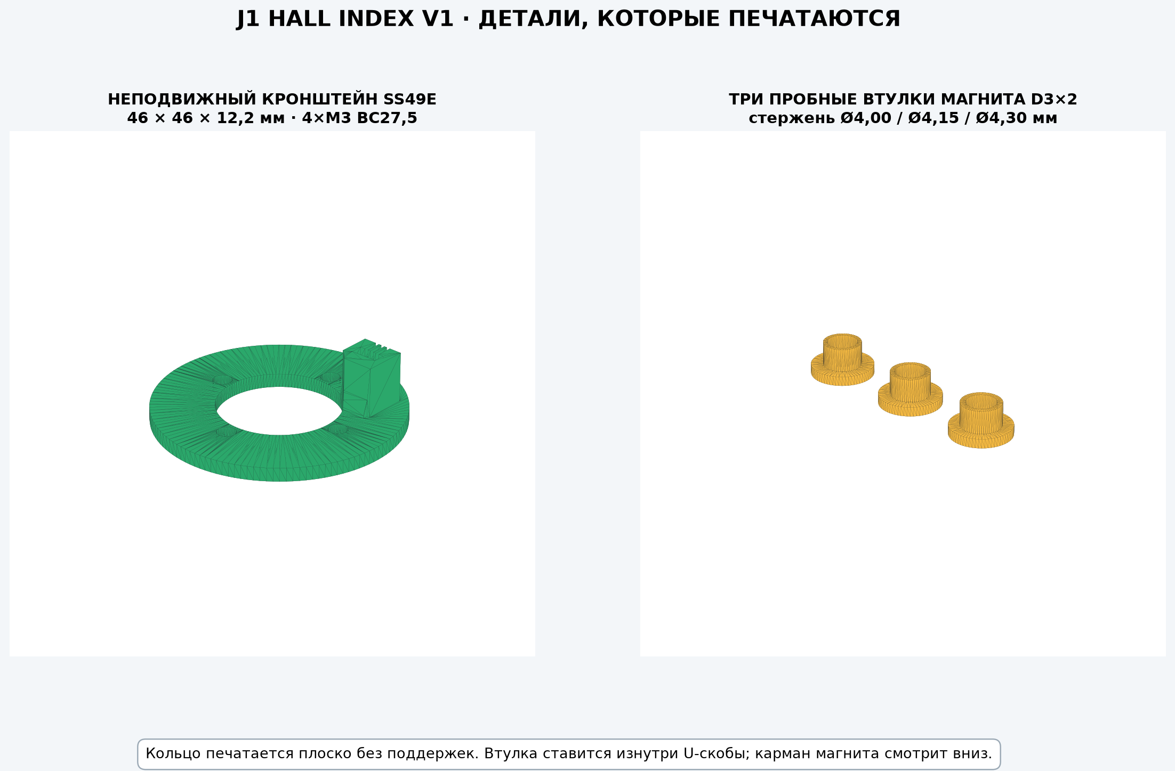
arm/printed/hall_j1_index_v1/HALL_J1_INDEX_V1_PARTS_REVIEW.png
