BZKDP/robot-arm/arm/printed/zero_drill_parts.png

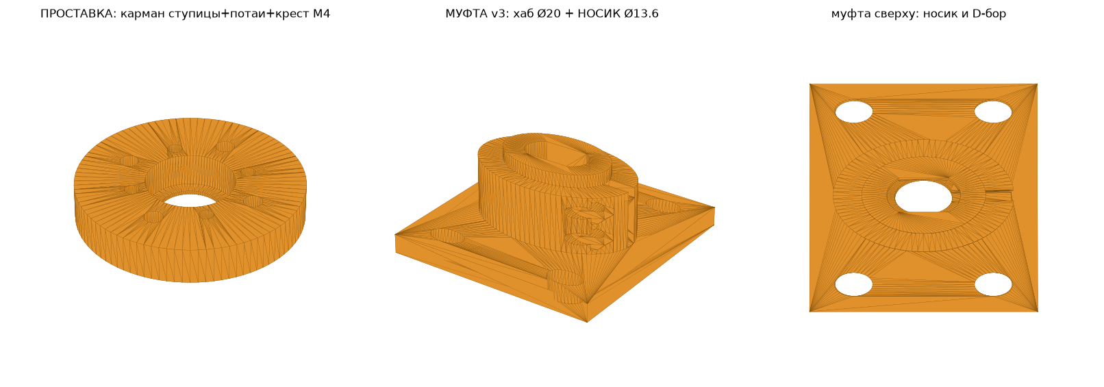
arm/printed/zero_drill_parts.png
