BZKDP/robot-arm/arm/electronics_carrier_v1/electronics_carrier_v1_ASSEMBLY_PREVIEW_DO_NOT_PRINT.stl

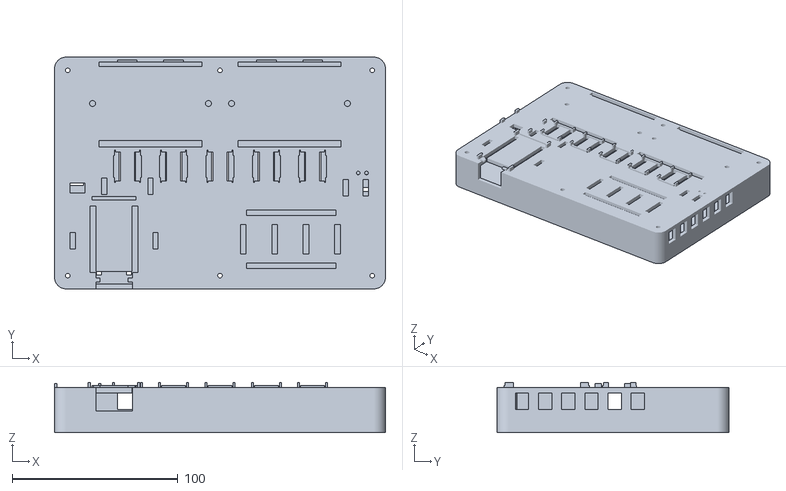
[picture p77: CAD file, 2026-10-12]
arm/electronics_carrier_v1/electronics_carrier_v1_ASSEMBLY_PREVIEW_DO_NOT_PRINT.stl
200.0 x 140.0 x 30.4
