BZKDP/robot-arm/stl_original/EBAmk2_012_mainbase_NEW.STL

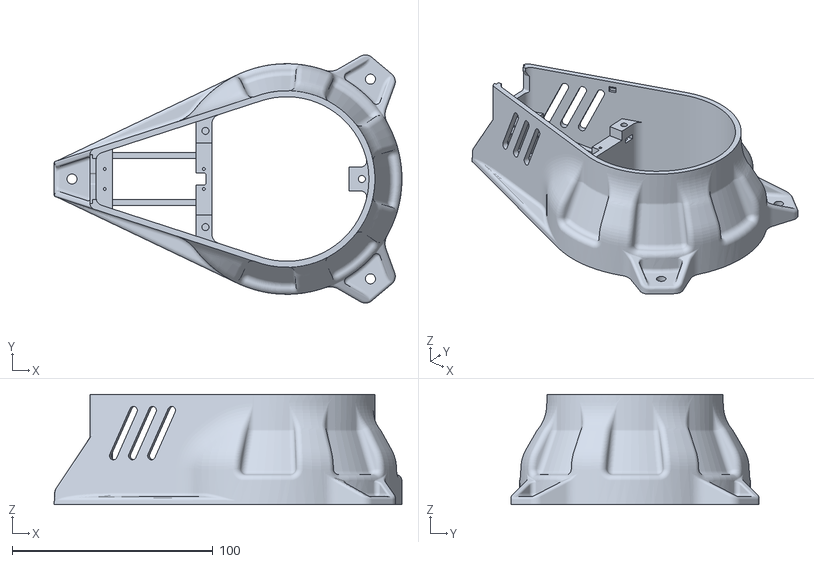
[picture p78: CAD file, 2026-10-12]
stl_original/EBAmk2_012_mainbase_NEW.STL
173.5 x 123.7 x 55.0
