BZKDP/robot-arm/arm/printed/base_motor_vise_cage_v1/base_vise_cage_v1_ASSEMBLY_REVIEW_ONLY.stl

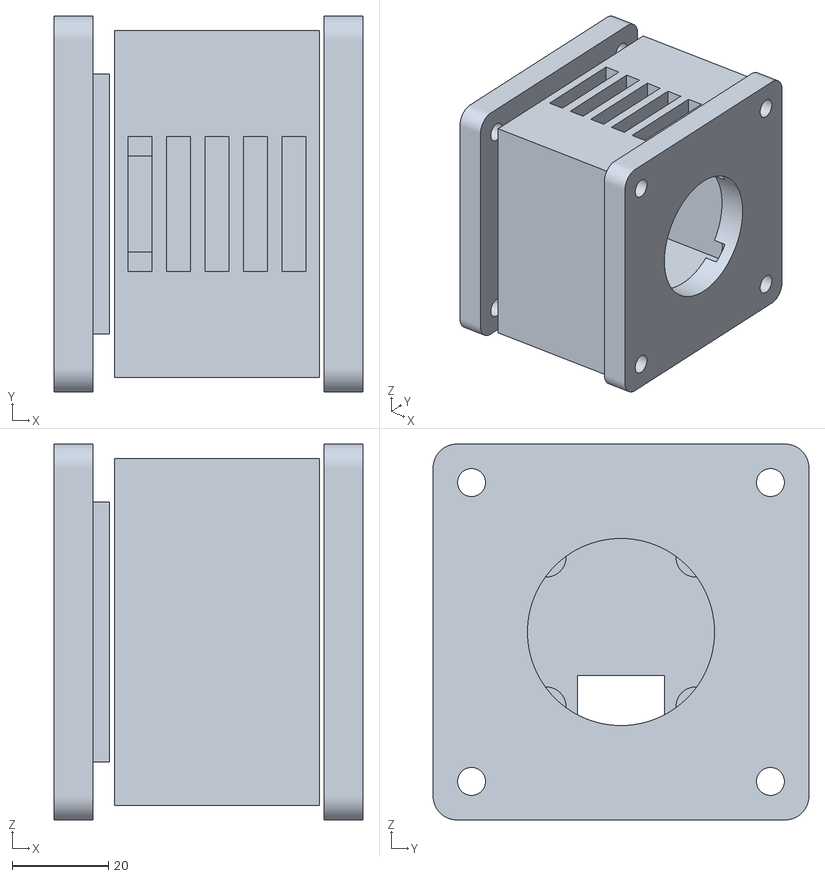
[picture p79: CAD file, 2026-10-12]
arm/printed/base_motor_vise_cage_v1/base_vise_cage_v1_ASSEMBLY_REVIEW_ONLY.stl
64.0 x 78.0 x 78.0
