BZKDP/robot-arm/arm/printed/hall_j1_index_v1/HALL_J1_INDEX_V1_ASSEMBLY_REVIEW_ONLY.stl

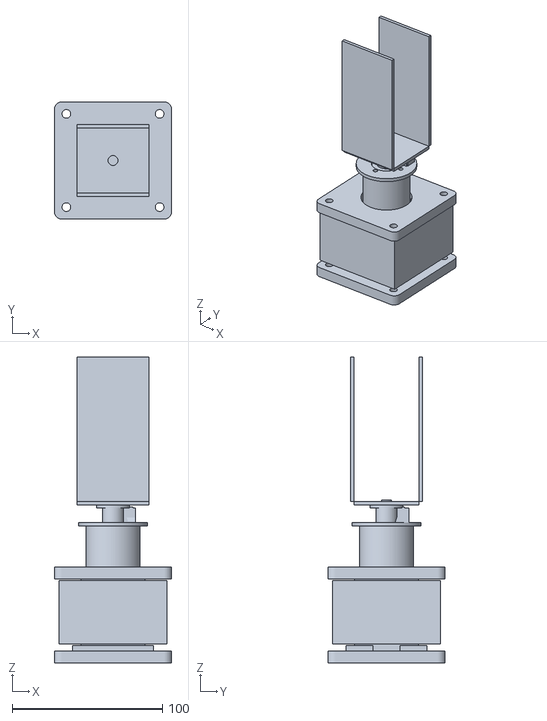
[picture p80: CAD file, 2026-10-12]
arm/printed/hall_j1_index_v1/HALL_J1_INDEX_V1_ASSEMBLY_REVIEW_ONLY.stl
78.0 x 78.0 x 203.5
