BZKDP/robot-arm/arm/printed/hall_quad_index_v3/HALL_QUAD_INDEX_V3_ASSEMBLY_REVIEW_ONLY.stl

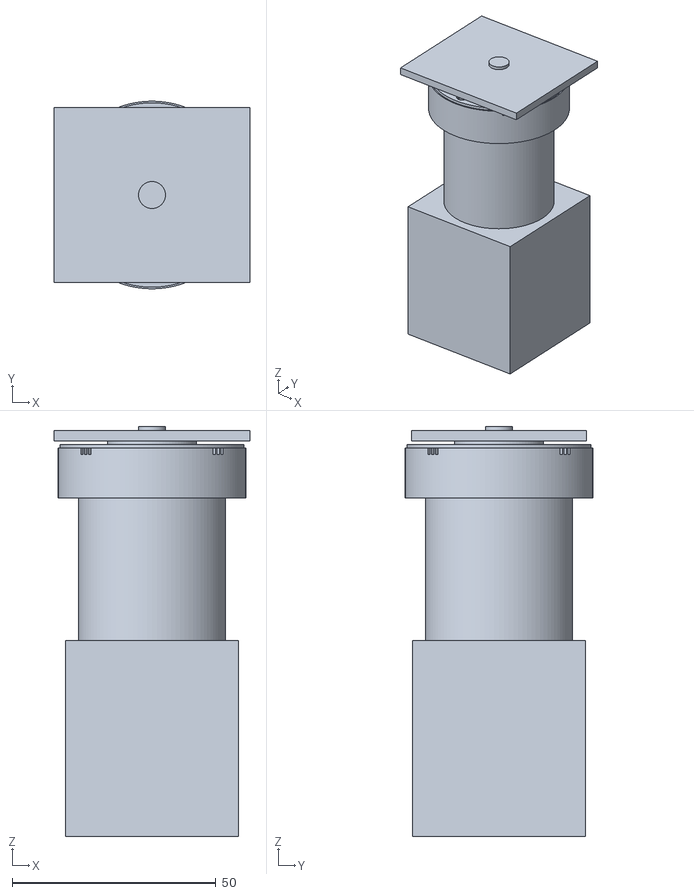
[picture p81: CAD file, 2026-10-12]
arm/printed/hall_quad_index_v3/HALL_QUAD_INDEX_V3_ASSEMBLY_REVIEW_ONLY.stl
48.0 x 46.0 x 100.5
