BZKDP/robot-arm/arm/printed/hall_j1_dual_index_v2/HALL_J1_DUAL_INDEX_V2_ASSEMBLY_REVIEW_ONLY.stl

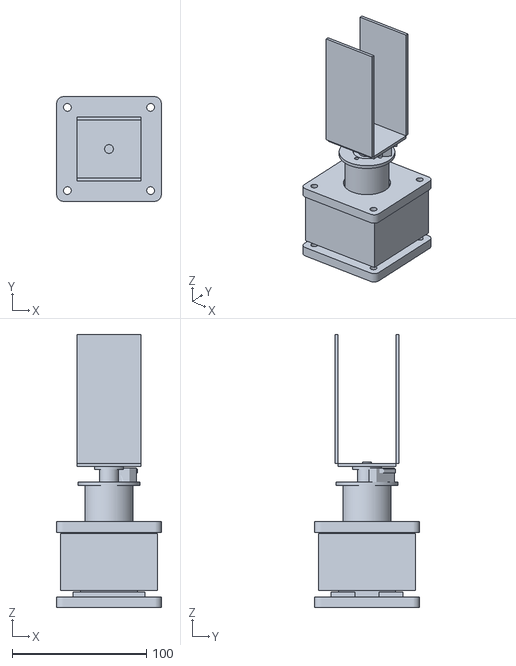
[picture p82: CAD file, 2026-10-12]
arm/printed/hall_j1_dual_index_v2/HALL_J1_DUAL_INDEX_V2_ASSEMBLY_REVIEW_ONLY.stl
78.0 x 78.0 x 203.5
