BZKDP/robot-arm/arm/electronics_carrier_v1/electronics_carrier_V2_PREVIEW_ASSEMBLY_REVIEW_ONLY.stl

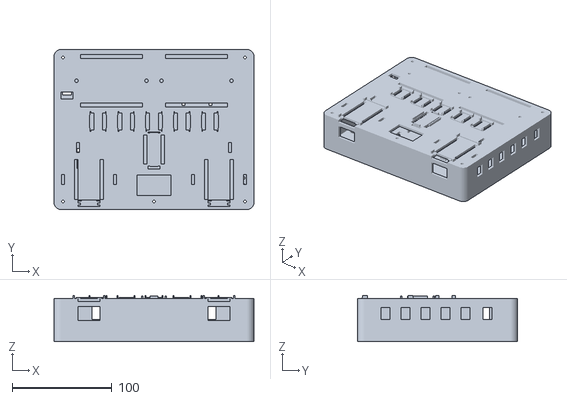
[picture p83: CAD file, 2026-10-12]
arm/electronics_carrier_v1/electronics_carrier_V2_PREVIEW_ASSEMBLY_REVIEW_ONLY.stl
200.0 x 160.0 x 46.2
