BZKDP/robot-arm/arm/adapter_plate_PREVIEW.stl

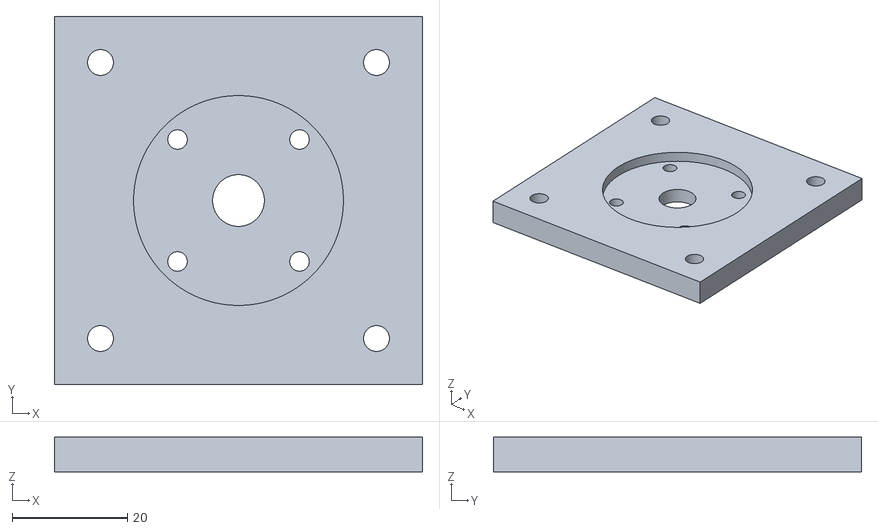
[picture p84: CAD file, 2026-10-12]
arm/adapter_plate_PREVIEW.stl
64.0 x 64.0 x 6.00
