BZKDP/robot-arm/arm/joint_module_v1/shaft_magnet_cap_8mm_v1.stl

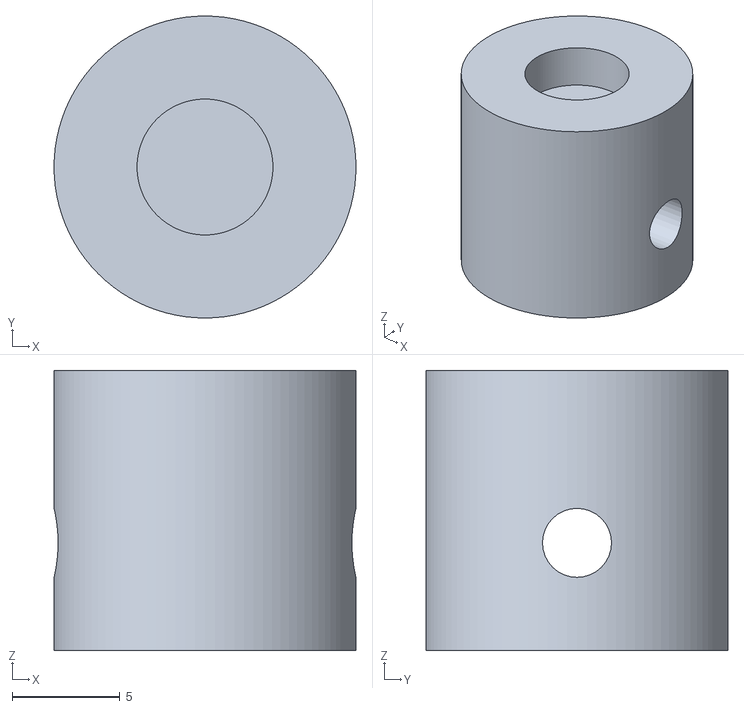
[picture p85: CAD file, 2026-10-12]
arm/joint_module_v1/shaft_magnet_cap_8mm_v1.stl
14.0 x 14.0 x 13.0
