BZKDP/robot-arm/arm/printed/base_motor_vise_cage_v1/base_vise_cage_v1_front_frame_BOTTOM_PETG.stl

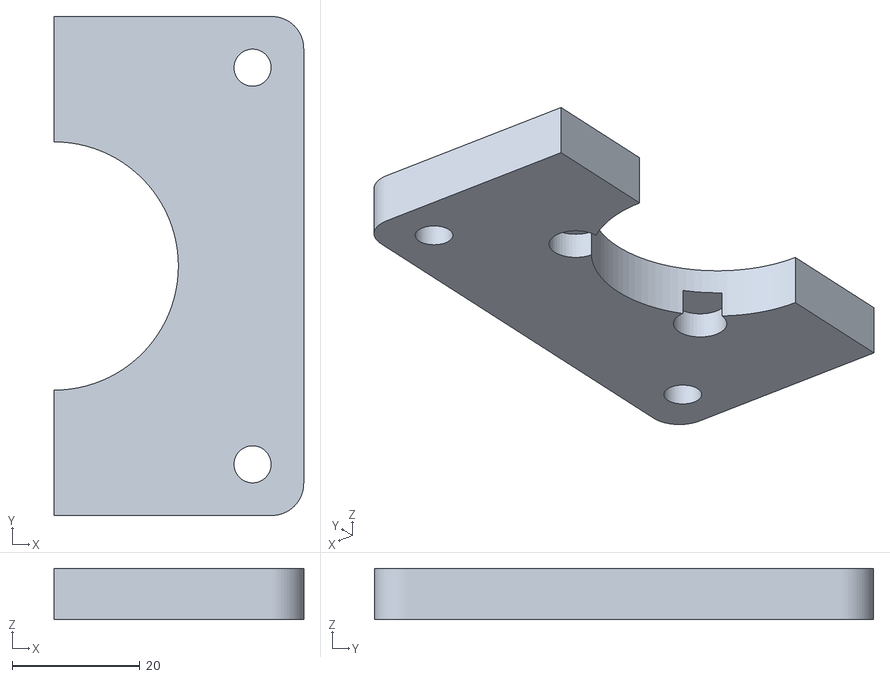
[picture p86: CAD file, 2026-10-12]
arm/printed/base_motor_vise_cage_v1/base_vise_cage_v1_front_frame_BOTTOM_PETG.stl
39.0 x 78.0 x 8.00
