BZKDP/robot-arm/arm/printed/hall_j1_dual_index_v2/hall_j1_SS49E_body_pocket_fit_test_3_sizes_PETG.stl

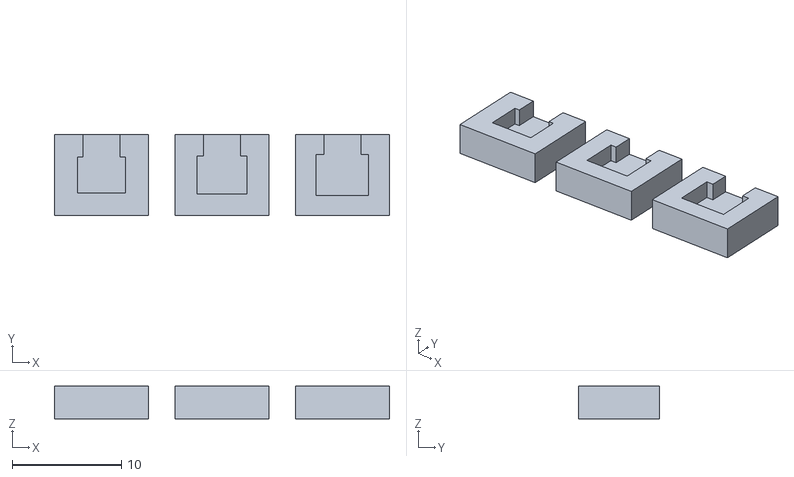
[picture p87: CAD file, 2026-10-12]
arm/printed/hall_j1_dual_index_v2/hall_j1_SS49E_body_pocket_fit_test_3_sizes_PETG.stl
30.6 x 7.40 x 3.00
