BZKDP/robot-arm/arm/printed/hall_j1_index_v1/PLATE_HALL_J1_INDEX_V1_PRINT_ALL.stl

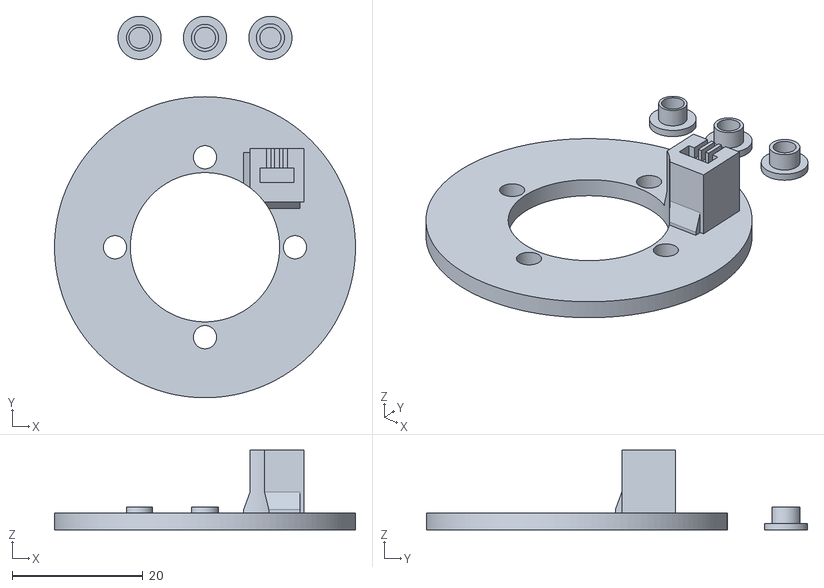
[picture p88: CAD file, 2026-10-12]
arm/printed/hall_j1_index_v1/PLATE_HALL_J1_INDEX_V1_PRINT_ALL.stl
46.0 x 58.3 x 12.2
