BZKDP/robot-arm/arm/printed/hall_quad_index_v3/PLATE_HALL_QUAD_INDEX_V3_TWO_JOINTS_PRINT.stl

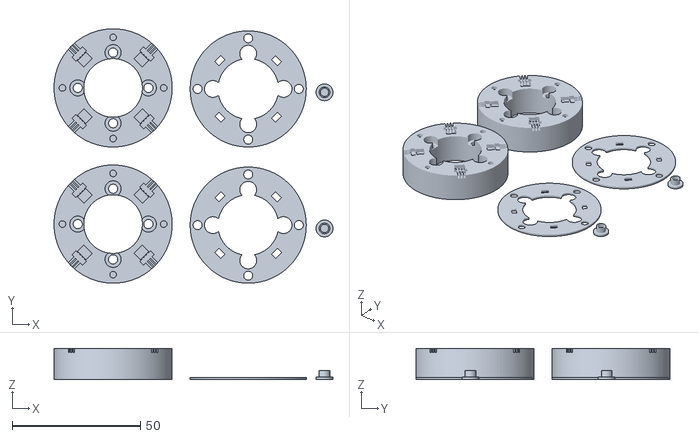
[picture p89: CAD file, 2026-10-12]
arm/printed/hall_quad_index_v3/PLATE_HALL_QUAD_INDEX_V3_TWO_JOINTS_PRINT.stl
108.6 x 99.0 x 12.2
