BZKDP/robot-arm/arm/printed/j4_roll_quad_hall_v6/j4_roll_v6_rear_square_key_PETG.stl

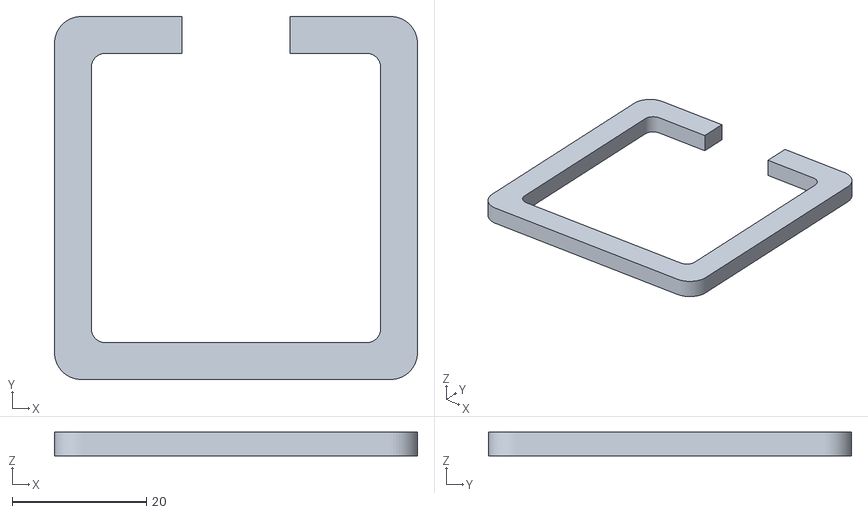
[picture p90: CAD file, 2026-10-12]
arm/printed/j4_roll_quad_hall_v6/j4_roll_v6_rear_square_key_PETG.stl
54.0 x 54.0 x 3.50
