BZKDP/robot-arm/arm/printed/roll_cage_v4_front_frame_BOTTOM_PETG.stl

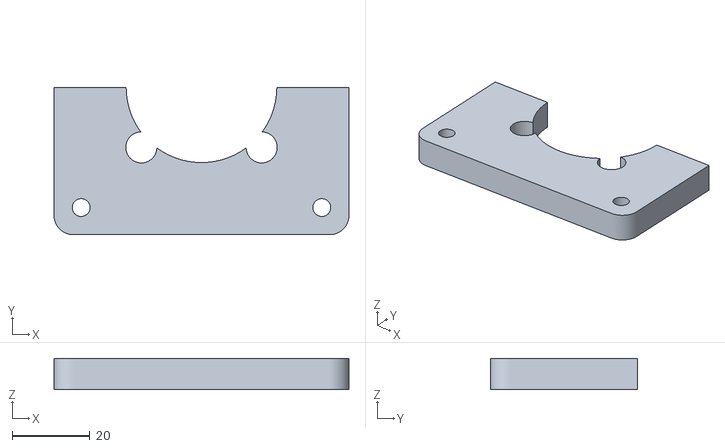
[picture p91: CAD file, 2026-10-12]
arm/printed/roll_cage_v4_front_frame_BOTTOM_PETG.stl
76.0 x 38.0 x 8.00
