BZKDP/robot-arm/pan-tilt-tracker/twin/static/models/tilt_motor.stl

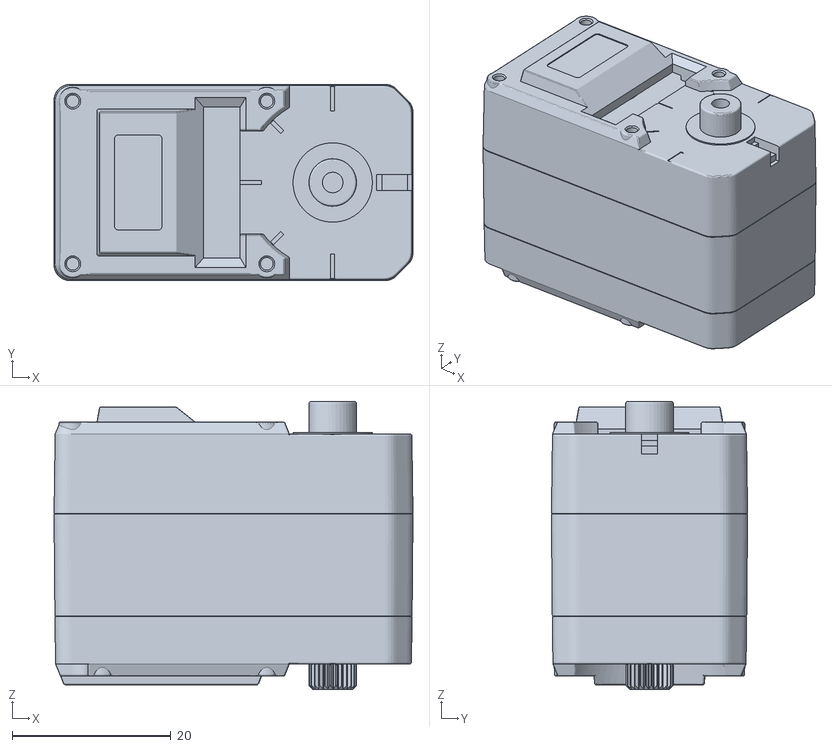
[picture p92: CAD file, 2026-10-12]
pan-tilt-tracker/twin/static/models/tilt_motor.stl
45.2 x 24.7 x 36.3
