BZKDP/robot-arm/vacuum/cup_holder_arm.stl

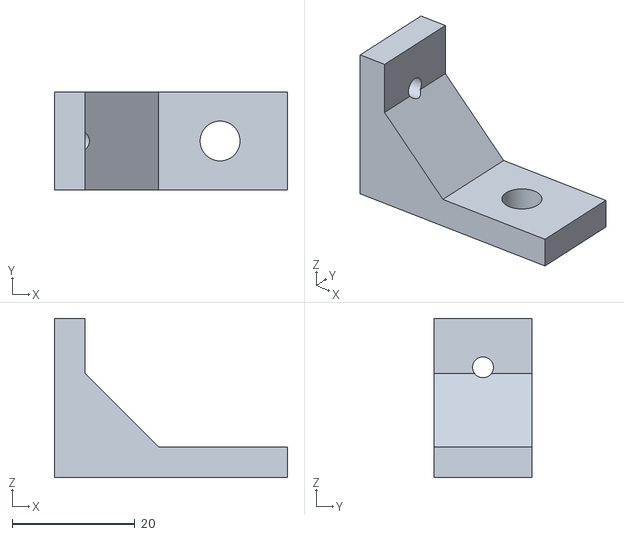
[picture p93: CAD file, 2026-10-12]
vacuum/cup_holder_arm.stl
38.0 x 16.0 x 26.0
