BZKDP/robot-arm/arm/electronics_carrier_v1/electronics_carrier_FINAL_TOP_Ender3V3SE.stl

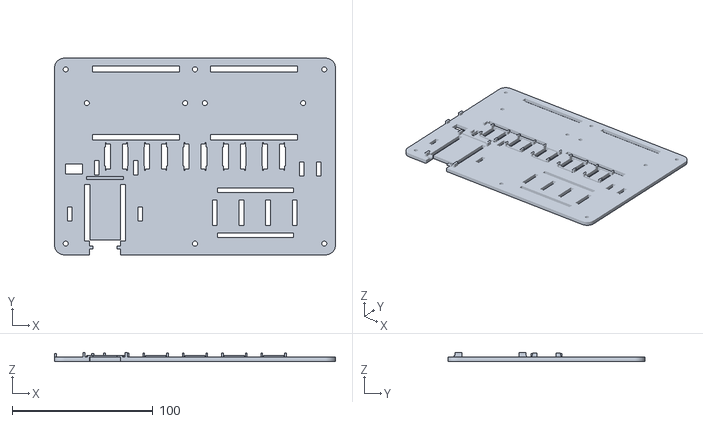
[picture p94: CAD file, 2026-10-12]
arm/electronics_carrier_v1/electronics_carrier_FINAL_TOP_Ender3V3SE.stl
200.0 x 140.0 x 6.38
