BZKDP/robot-arm/arm/joint_module_v1/output_hub_8mm_flange_as5600_v1.stl

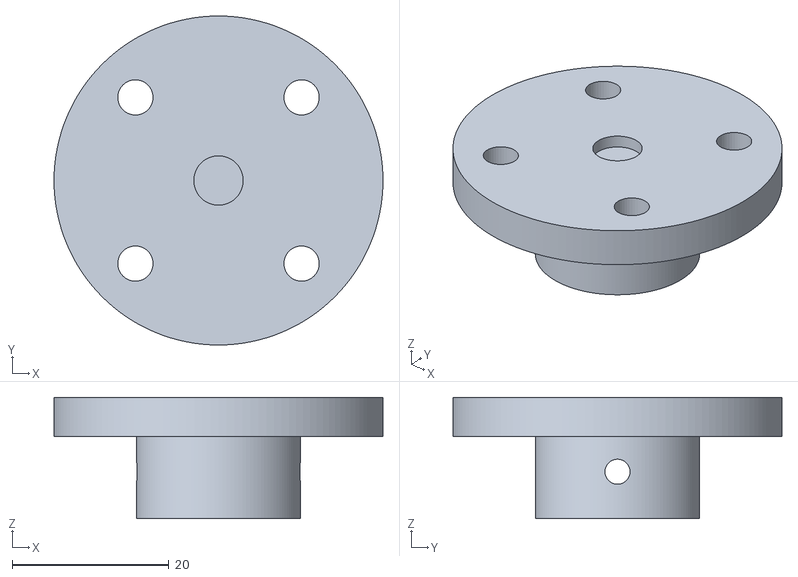
[picture p95: CAD file, 2026-10-12]
arm/joint_module_v1/output_hub_8mm_flange_as5600_v1.stl
42.0 x 42.0 x 15.5
