BZKDP/robot-arm/arm/printed/hall_j1_dual_index_v2/hall_j1_magnet_bushing_D3x2_OD4p15_PETG.stl

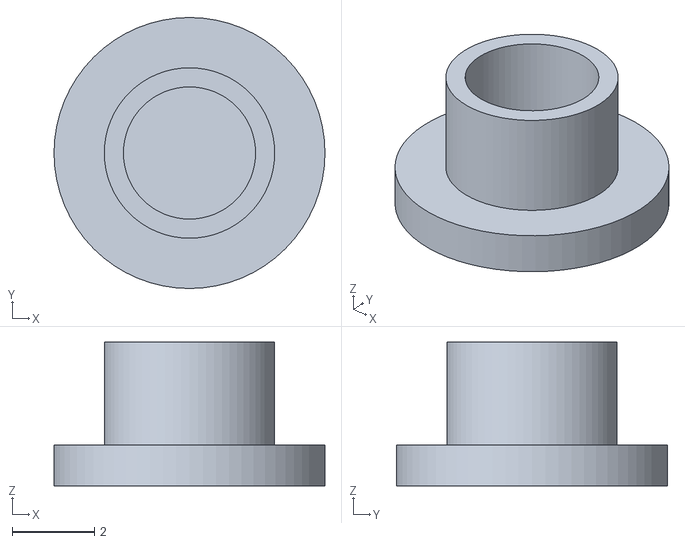
[picture p96: CAD file, 2026-10-12]
arm/printed/hall_j1_dual_index_v2/hall_j1_magnet_bushing_D3x2_OD4p15_PETG.stl
6.60 x 6.60 x 3.50
