BZKDP/robot-arm/arm/printed/j4_roll_quad_hall_v6/j4_roll_v6_hall_retainer_ring_PETG.stl

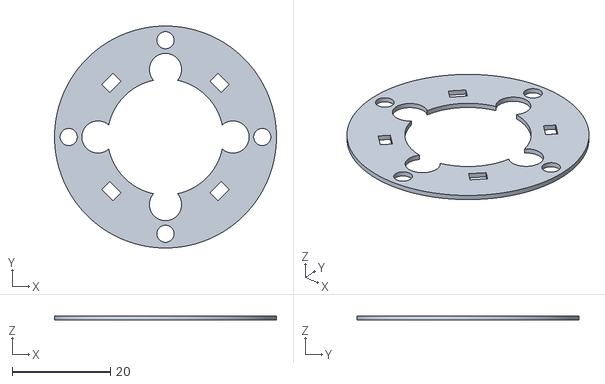
[picture p97: CAD file, 2026-10-12]
arm/printed/j4_roll_quad_hall_v6/j4_roll_v6_hall_retainer_ring_PETG.stl
45.2 x 45.2 x 0.9
