BZKDP/robot-arm/arm/printed/PLATE_J1J2_PETG.stl

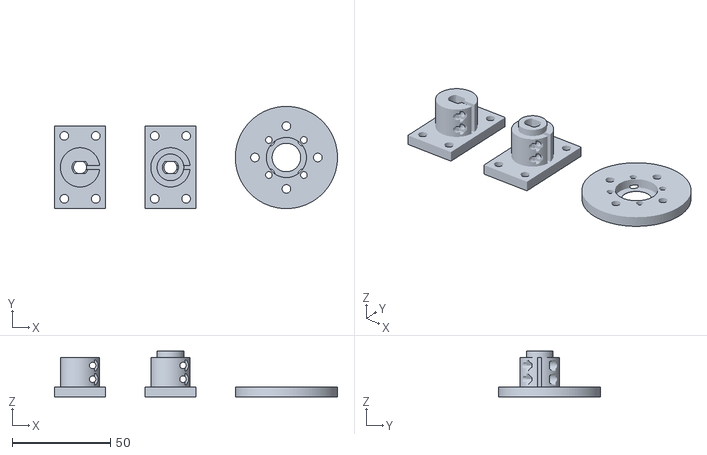
[picture p98: CAD file, 2026-10-12]
arm/printed/PLATE_J1J2_PETG.stl
144.0 x 52.0 x 23.3
