BZKDP/robot-arm/arm/test_coupon_fb5118m.stl

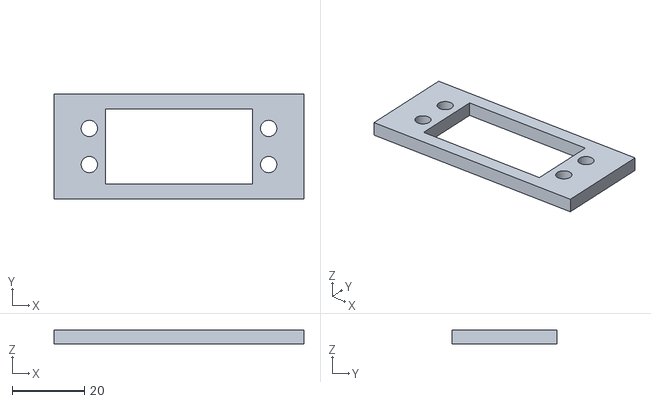
[picture p99: CAD file, 2026-10-12]
arm/test_coupon_fb5118m.stl
69.0 x 29.1 x 4.00
