BZKDP/robot-arm/pan-tilt-tracker/twin/static/models/base_link.stl

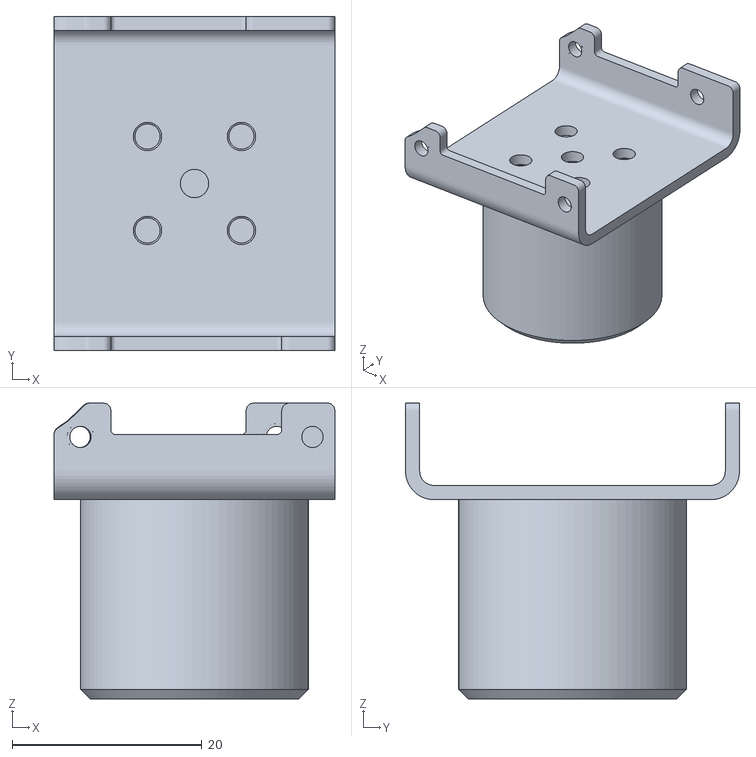
[picture p100: CAD file, 2026-10-12]
pan-tilt-tracker/twin/static/models/base_link.stl
29.6 x 35.2 x 31.2
