BZKDP/robot-arm/stl_original/EBAmk2_019_drive_cover_new.STL

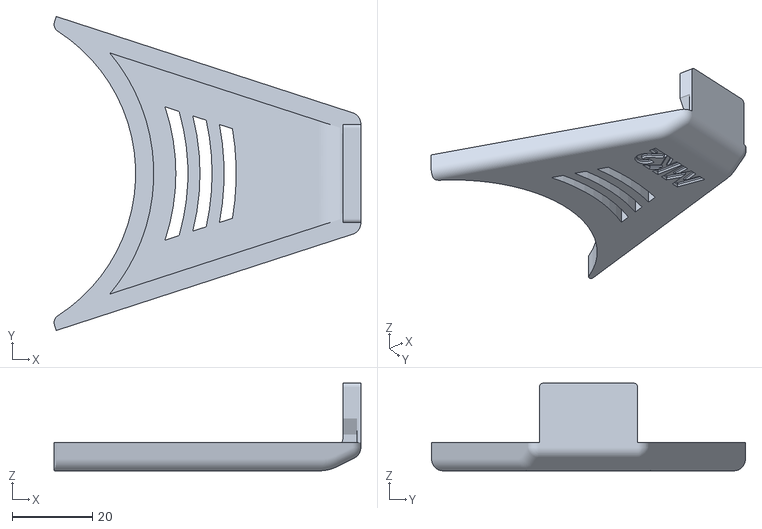
[picture p101: CAD file, 2026-10-12]
stl_original/EBAmk2_019_drive_cover_new.STL
76.3 x 78.1 x 21.8
