BZKDP/robot-arm/arm/joint_module_v1/joint_module_open_frame_v1.stl

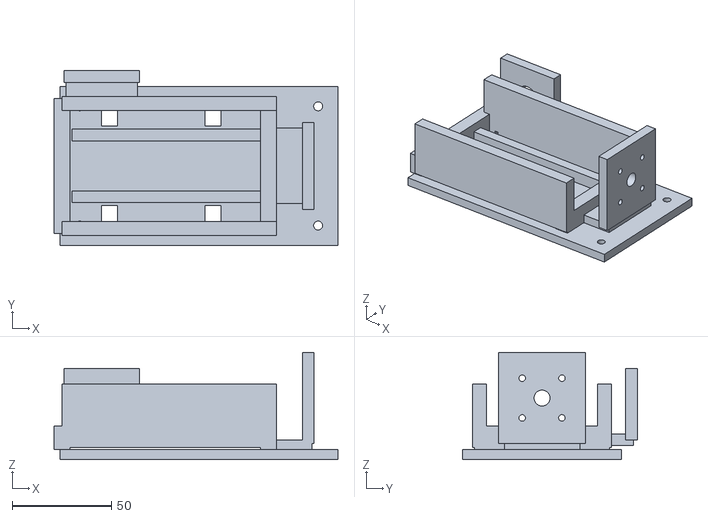
[picture p103: CAD file, 2026-10-12]
arm/joint_module_v1/joint_module_open_frame_v1.stl
143.0 x 88.0 x 54.0
