BZKDP/robot-arm/arm/printed/base_motor_vise_cage_v1/PLATE_BASE_VISE_CAGE_V1_PRINT_ALL.stl

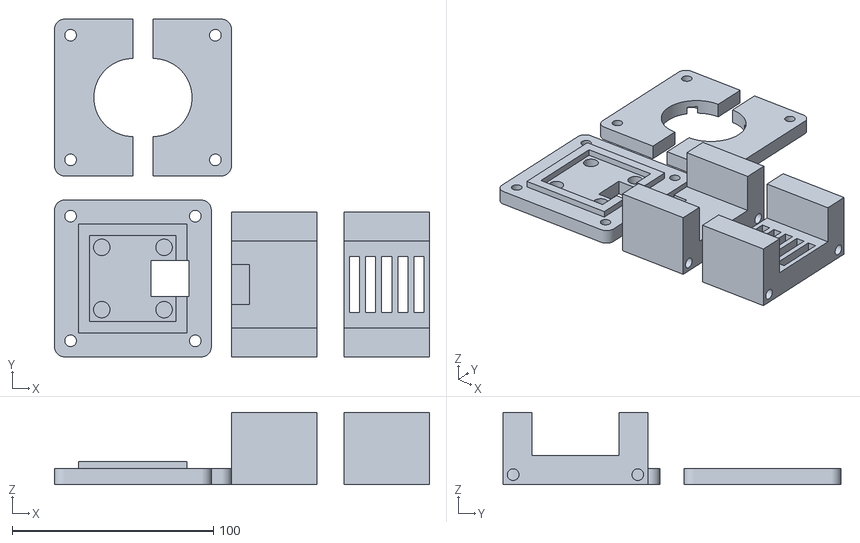
[picture p104: CAD file, 2026-10-12]
arm/printed/base_motor_vise_cage_v1/PLATE_BASE_VISE_CAGE_V1_PRINT_ALL.stl
186.5 x 168.0 x 36.0
