BZKDP/robot-arm/arm/printed/hall_j1_index_v1/hall_j1_cm36_face_mount_SS49E_PETG.stl

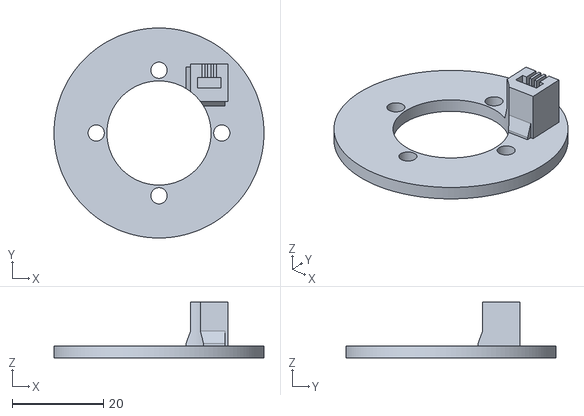
[picture p105: CAD file, 2026-10-12]
arm/printed/hall_j1_index_v1/hall_j1_cm36_face_mount_SS49E_PETG.stl
46.0 x 46.0 x 12.2
