BZKDP/robot-arm/arm/printed/j4_roll_quad_hall_v6/j4_roll_v6_hall_cartridge_4xSS49E_PETG.stl

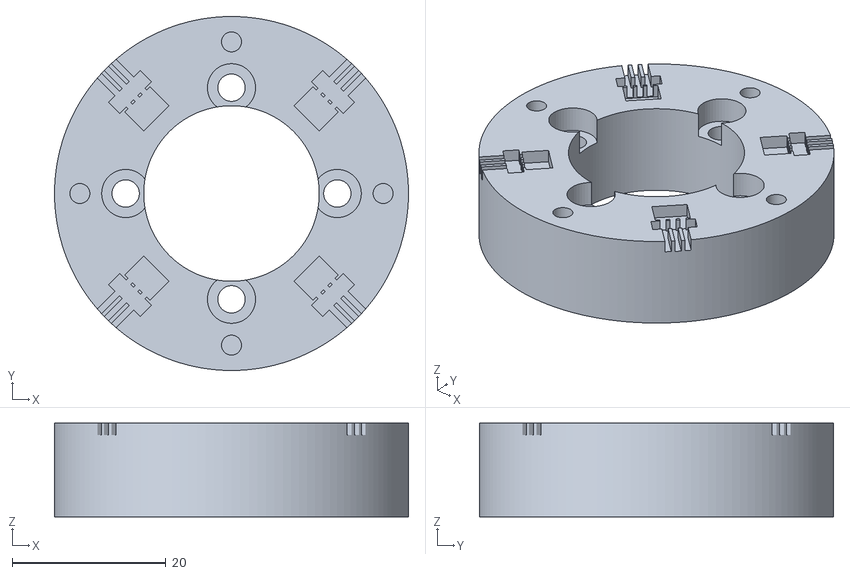
[picture p107: CAD file, 2026-10-12]
arm/printed/j4_roll_quad_hall_v6/j4_roll_v6_hall_cartridge_4xSS49E_PETG.stl
46.0 x 46.0 x 12.2
