BZKDP/robot-arm/arm/printed/tube_spacers_x2_PETG.stl

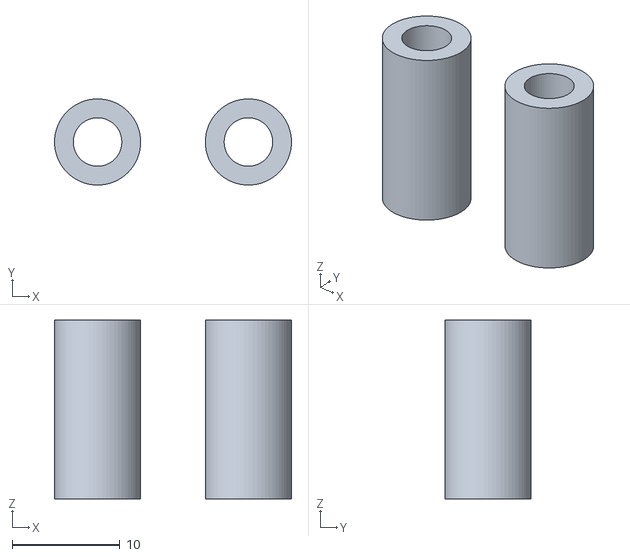
[picture p108: CAD file, 2026-10-12]
arm/printed/tube_spacers_x2_PETG.stl
22.0 x 8.00 x 16.6
