BZKDP/robot-arm/pan-tilt-tracker/twin/static/models/camera-back-v2-print.stl

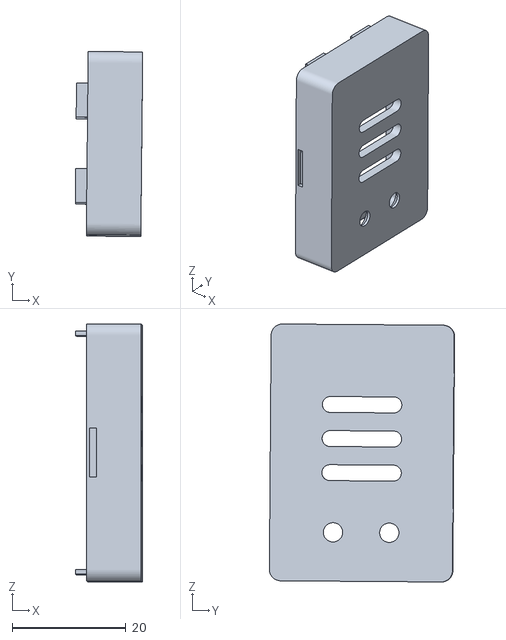
[picture p109: CAD file, 2026-10-12]
pan-tilt-tracker/twin/static/models/camera-back-v2-print.stl
11.9 x 32.6 x 45.4
