BZKDP/robot-arm/arm/printed/base_motor_vise_cage_v1/base_vise_cage_v1_upper_cover_PETG.stl

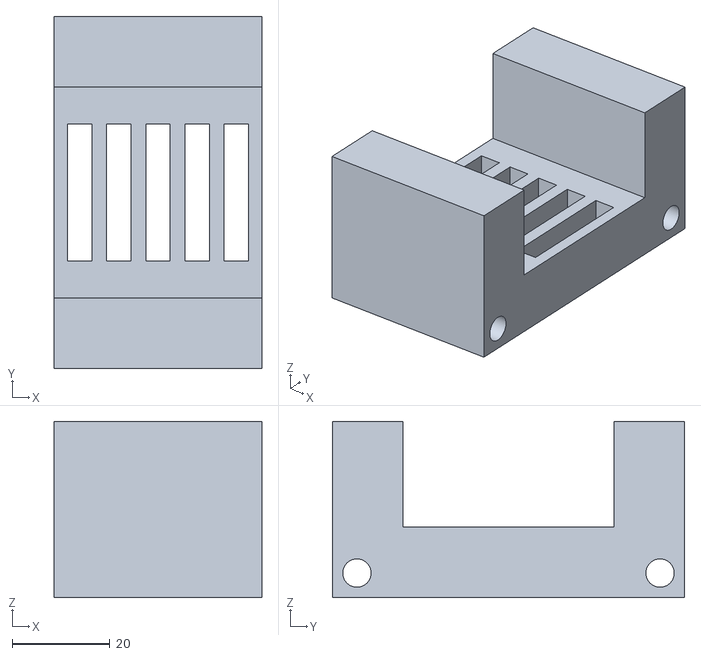
[picture p111: CAD file, 2026-10-12]
arm/printed/base_motor_vise_cage_v1/base_vise_cage_v1_upper_cover_PETG.stl
42.5 x 72.0 x 36.0
