BZKDP/robot-arm/arm/printed/hall_j1_dual_index_v2/hall_j1_magnet_bushing_fit_set_OD4p00_4p15_4p30_PETG.stl

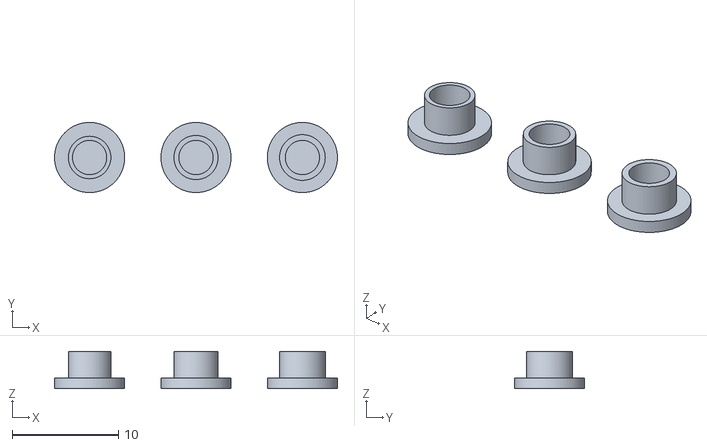
[picture p112: CAD file, 2026-10-12]
arm/printed/hall_j1_dual_index_v2/hall_j1_magnet_bushing_fit_set_OD4p00_4p15_4p30_PETG.stl
26.6 x 6.60 x 3.50
