BZKDP/robot-arm/arm/printed/j4_roll_quad_hall_v6/PLATE_J4_ROLL_V6_M5X80_PLUS_QUAD_HALL_PRINT_ALL.stl

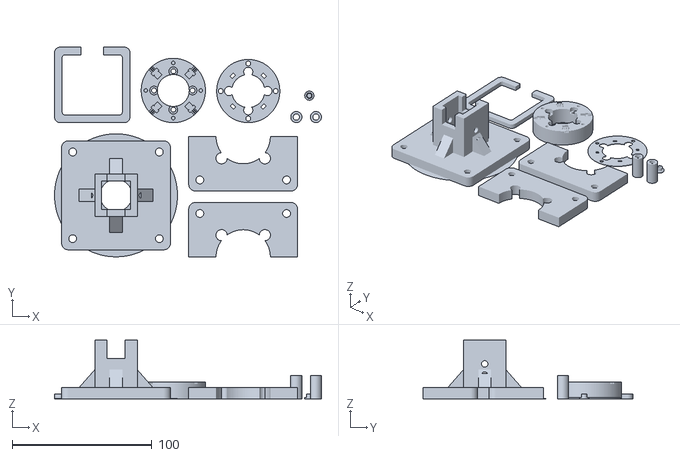
[picture p113: CAD file, 2026-10-12]
arm/printed/j4_roll_quad_hall_v6/PLATE_J4_ROLL_V6_M5X80_PLUS_QUAD_HALL_PRINT_ALL.stl
191.0 x 150.0 x 42.0
