BZKDP/robot-arm/arm/printed/roll_mount_v2_PETG.stl

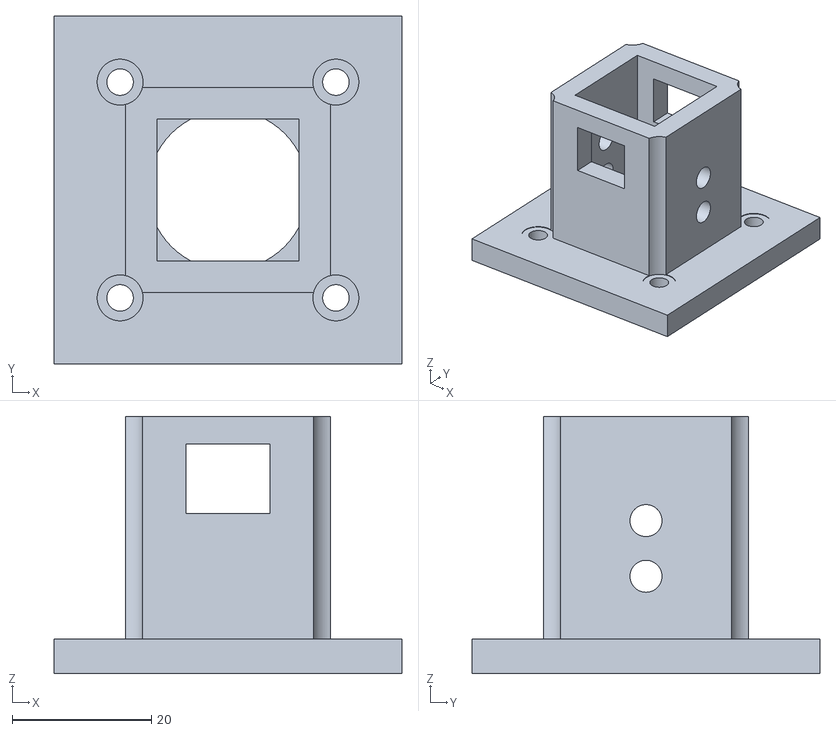
[picture p114: CAD file, 2026-10-12]
arm/printed/roll_mount_v2_PETG.stl
50.0 x 50.0 x 37.0
