BZKDP/robot-arm/pan-tilt-tracker/twin/static/models/payload_link_end_mount-flat.stl

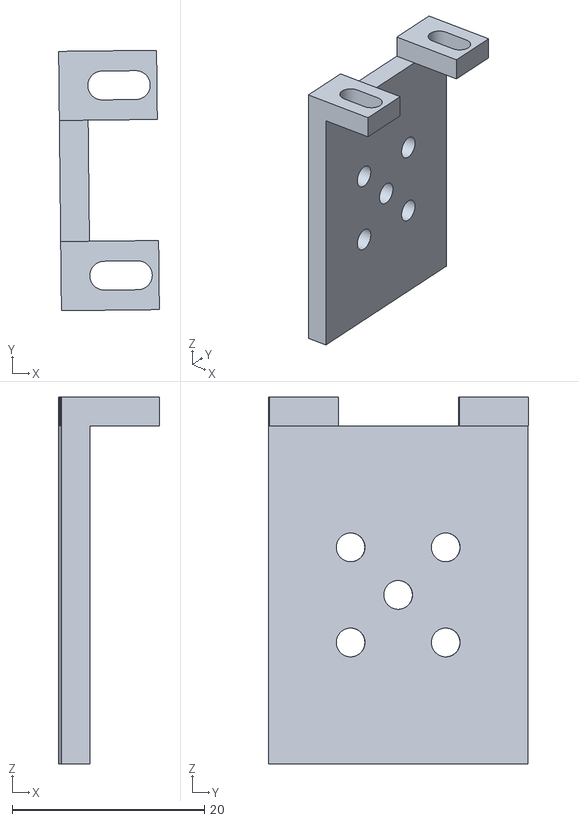
[picture p115: CAD file, 2026-10-12]
pan-tilt-tracker/twin/static/models/payload_link_end_mount-flat.stl
10.5 x 27.1 x 38.2
