BZKDP/robot-arm/arm/printed/flange_bridge_v4_PETG.stl

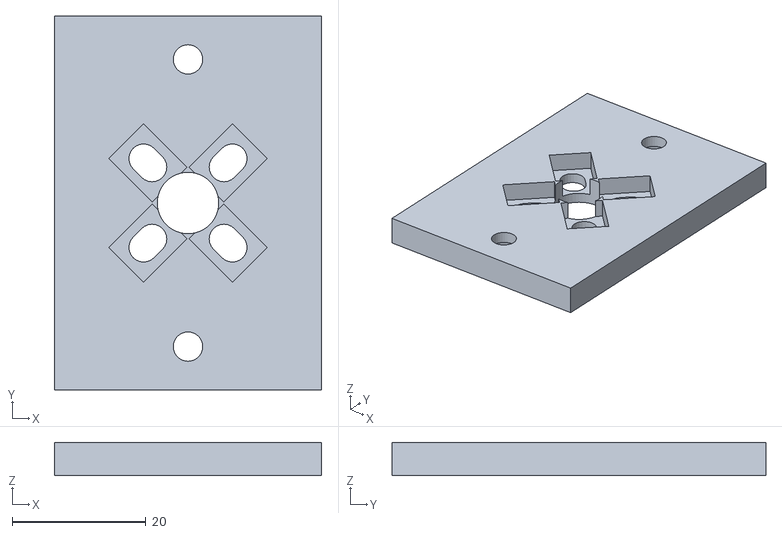
[picture p117: CAD file, 2026-10-12]
arm/printed/flange_bridge_v4_PETG.stl
40.0 x 56.0 x 5.00
