BZKDP/robot-arm/arm/printed/hall_j1_dual_index_v2/PLATE_HALL_J1_DUAL_INDEX_V2_PRINT_ALL.stl

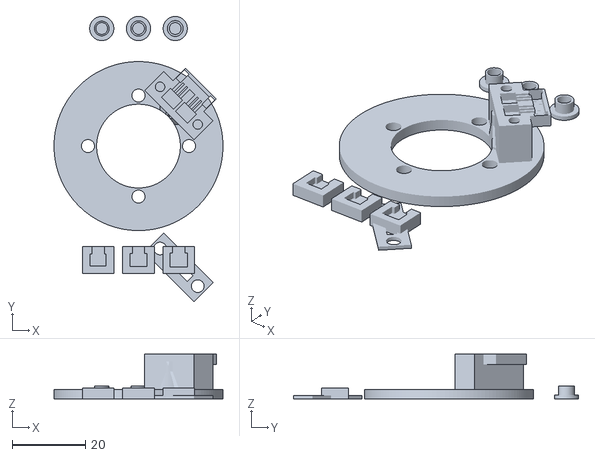
[picture p118: CAD file, 2026-10-12]
arm/printed/hall_j1_dual_index_v2/PLATE_HALL_J1_DUAL_INDEX_V2_PRINT_ALL.stl
46.0 x 77.6 x 12.2
