BZKDP/robot-arm/pan-tilt-tracker/twin/static/models/pan_tilt_bracket.stl

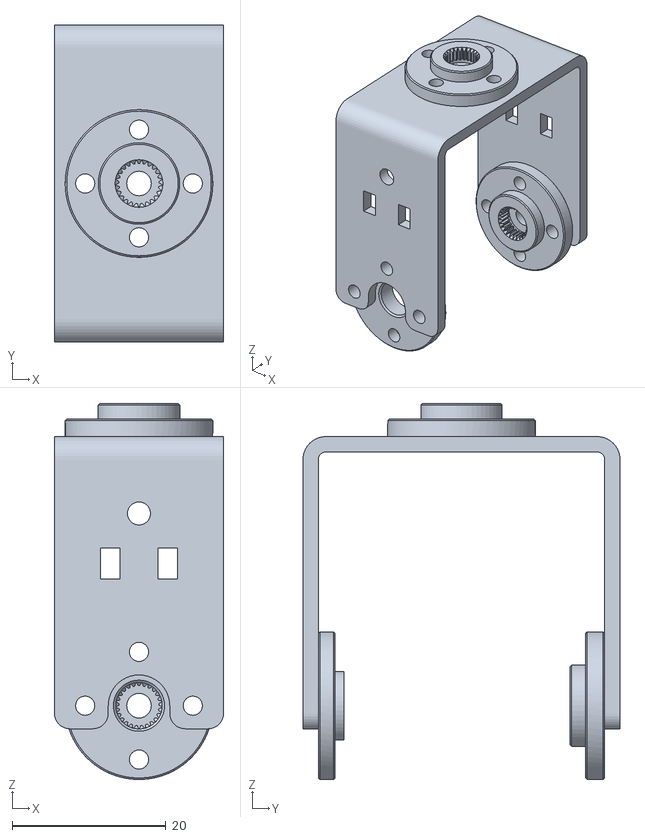
[picture p119: CAD file, 2026-10-12]
pan-tilt-tracker/twin/static/models/pan_tilt_bracket.stl
22.0 x 41.2 x 48.9
