BZKDP/robot-arm/arm/printed/base_motor_vise_cage_v1/base_vise_cage_v1_rear_plate_PETG.stl

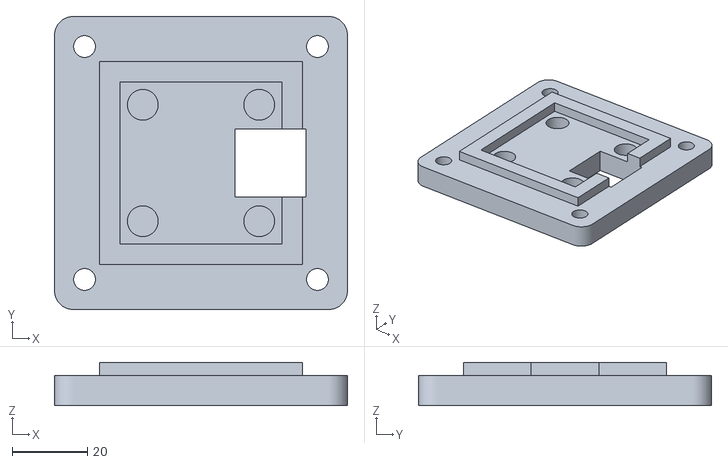
[picture p120: CAD file, 2026-10-12]
arm/printed/base_motor_vise_cage_v1/base_vise_cage_v1_rear_plate_PETG.stl
78.0 x 78.0 x 11.5
