BZKDP/robot-arm/arm/printed/PLATE_1_J2_SET.stl

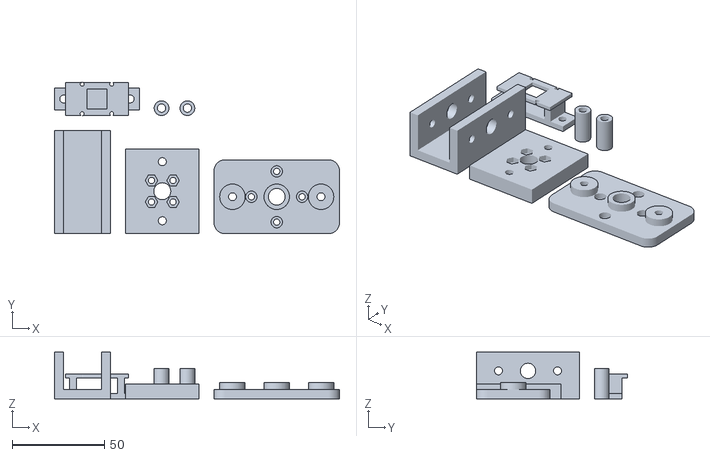
[picture p122: CAD file, 2026-10-12]
arm/printed/PLATE_1_J2_SET.stl
154.4 x 82.0 x 25.4
