BZKDP/robot-arm/pan-tilt-tracker/twin/static/models/camera-front-v2-print.stl

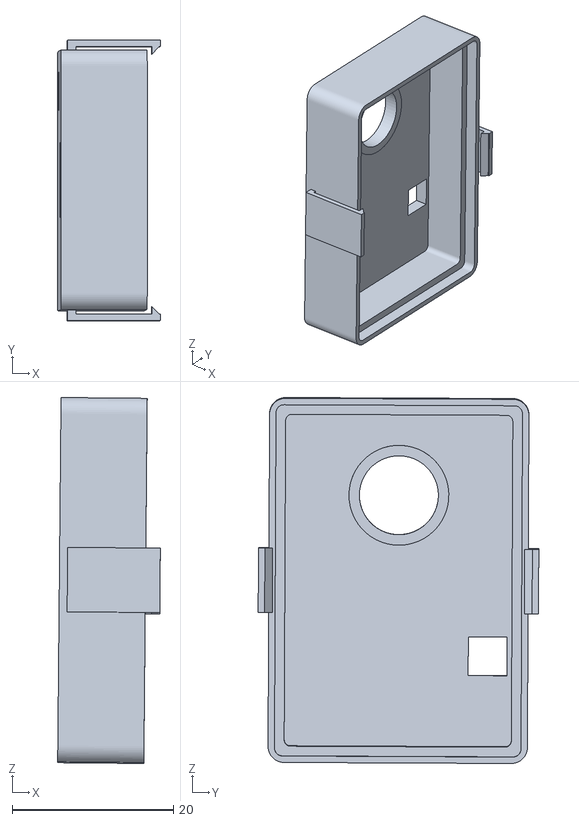
[picture p123: CAD file, 2026-10-12]
pan-tilt-tracker/twin/static/models/camera-front-v2-print.stl
12.7 x 34.8 x 45.4
