BZKDP/robot-arm/arm/printed/drill_jig_v4_PETG.stl

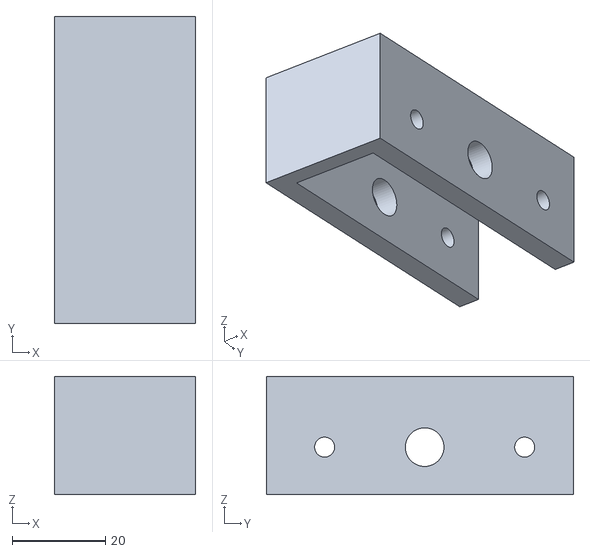
[picture p124: CAD file, 2026-10-12]
arm/printed/drill_jig_v4_PETG.stl
30.4 x 66.0 x 25.4
