BZKDP/robot-arm/arm/printed/hall_j1_dual_index_v2/hall_j1_DUAL_SS49E_retainer_frame_M3_PETG.stl

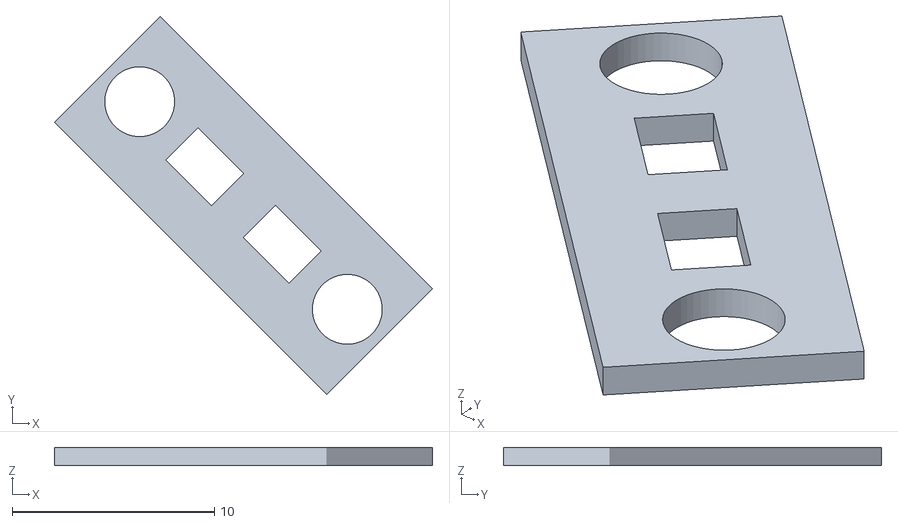
[picture p125: CAD file, 2026-10-12]
arm/printed/hall_j1_dual_index_v2/hall_j1_DUAL_SS49E_retainer_frame_M3_PETG.stl
18.7 x 18.7 x 0.9
