BZKDP/robot-arm/arm/electronics_carrier_v1/electronics_carrier_V2_SWITCH_FIT_TEST.stl

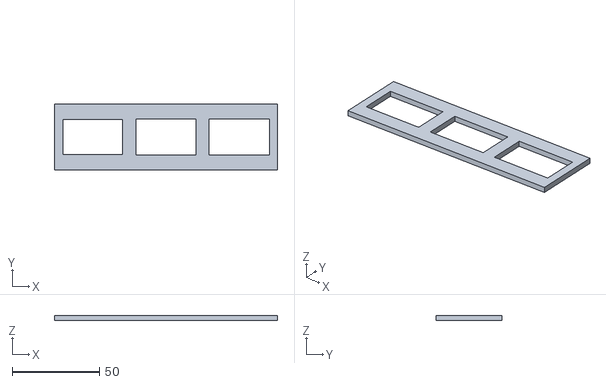
[picture p126: CAD file, 2026-10-12]
arm/electronics_carrier_v1/electronics_carrier_V2_SWITCH_FIT_TEST.stl
128.0 x 38.0 x 3.00
