BZKDP/robot-arm/arm/electronics_carrier_v1/electronics_carrier_V2_PREVIEW_TOP_Ender3V3SE.stl

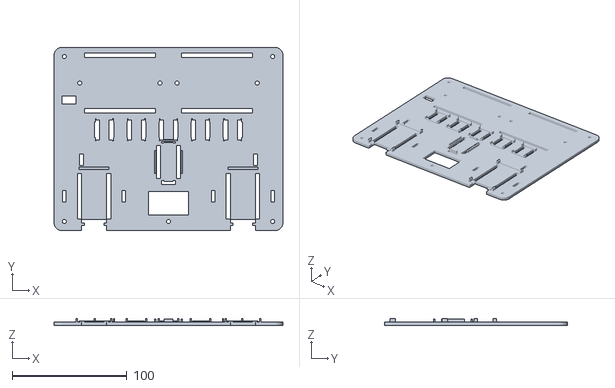
[picture p127: CAD file, 2026-10-12]
arm/electronics_carrier_v1/electronics_carrier_V2_PREVIEW_TOP_Ender3V3SE.stl
200.0 x 160.0 x 6.18
