BZKDP/robot-arm/arm/printed/PRINT_J3_TUBE_TO_U_CUP.stl

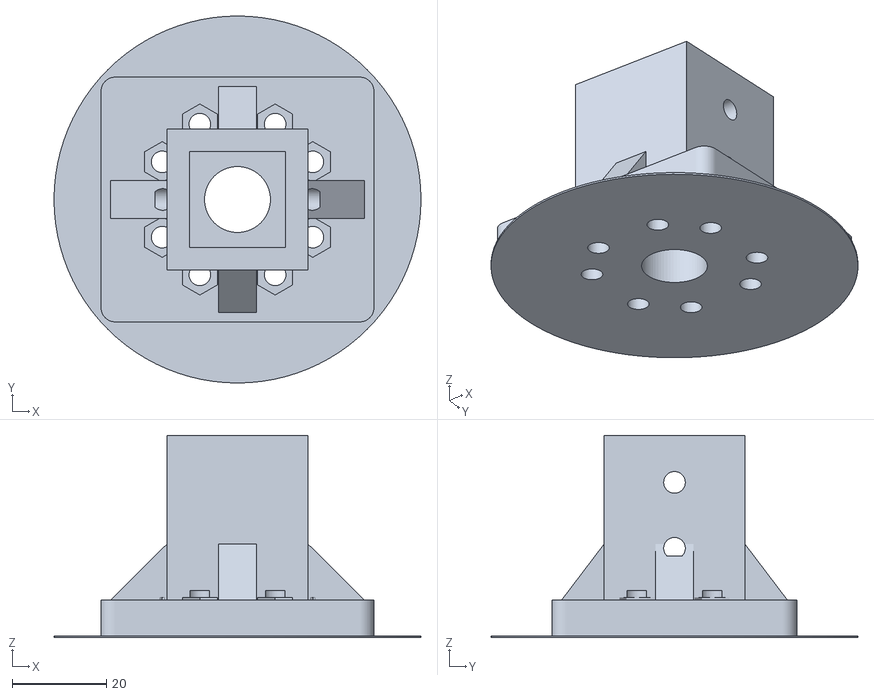
[picture p128: CAD file, 2026-10-12]
arm/printed/PRINT_J3_TUBE_TO_U_CUP.stl
78.0 x 78.0 x 43.0
