BZKDP/robot-arm/arm/printed/coupling_v3_PETG.stl

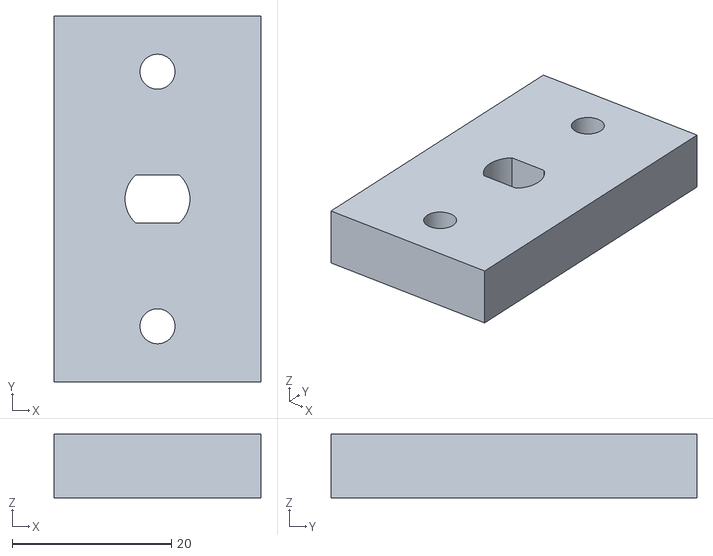
[picture p129: CAD file, 2026-10-12]
arm/printed/coupling_v3_PETG.stl
26.0 x 46.0 x 8.00
