BZKDP/robot-arm/arm/printed/TEST_FLANGE_PATTERN_V5.stl

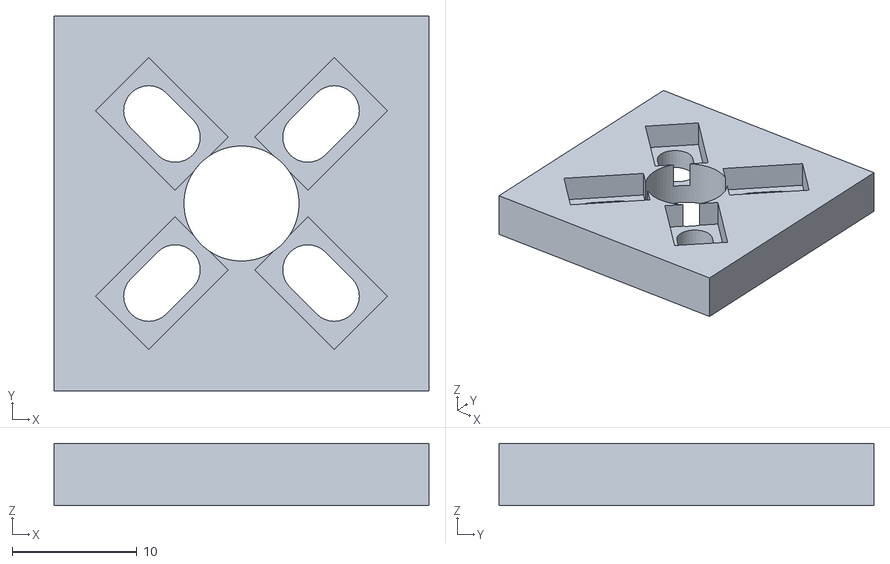
[picture p130: CAD file, 2026-10-12]
arm/printed/TEST_FLANGE_PATTERN_V5.stl
30.0 x 30.0 x 5.00
