BZKDP/robot-arm/arm/printed/PLATE_BRIDGE_V5.stl

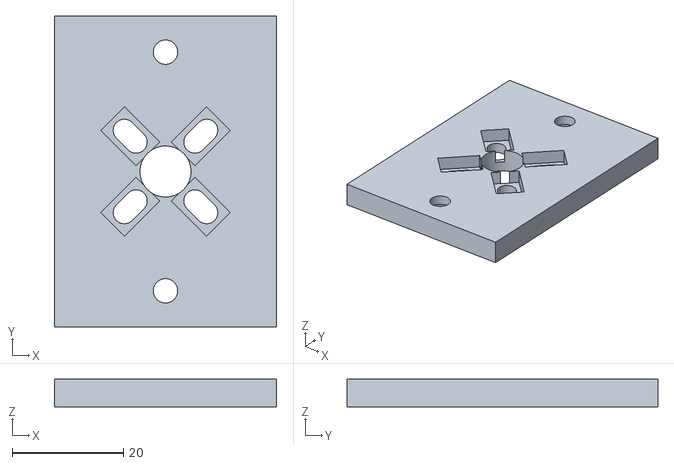
[picture p131: CAD file, 2026-10-12]
arm/printed/PLATE_BRIDGE_V5.stl
40.0 x 56.0 x 5.00
