BZKDP/robot-arm/arm/printed/j3_cup_internal_spacer_v1_PETG.stl

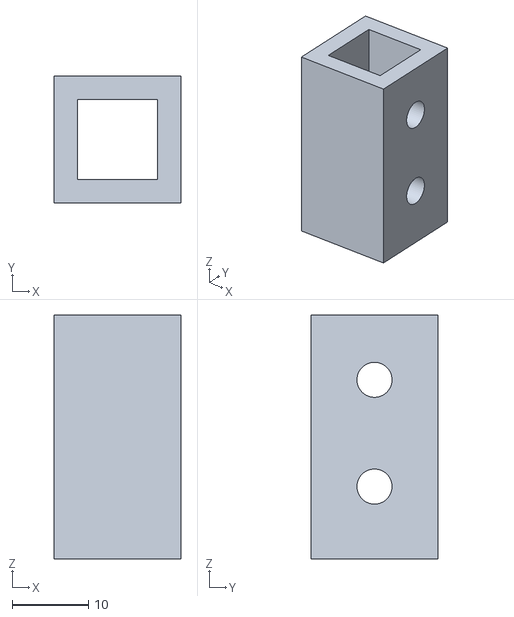
[picture p132: CAD file, 2026-10-12]
arm/printed/j3_cup_internal_spacer_v1_PETG.stl
16.6 x 16.6 x 32.0
