BZKDP/robot-arm/arm/printed/gearbox_adapter_J2.stl

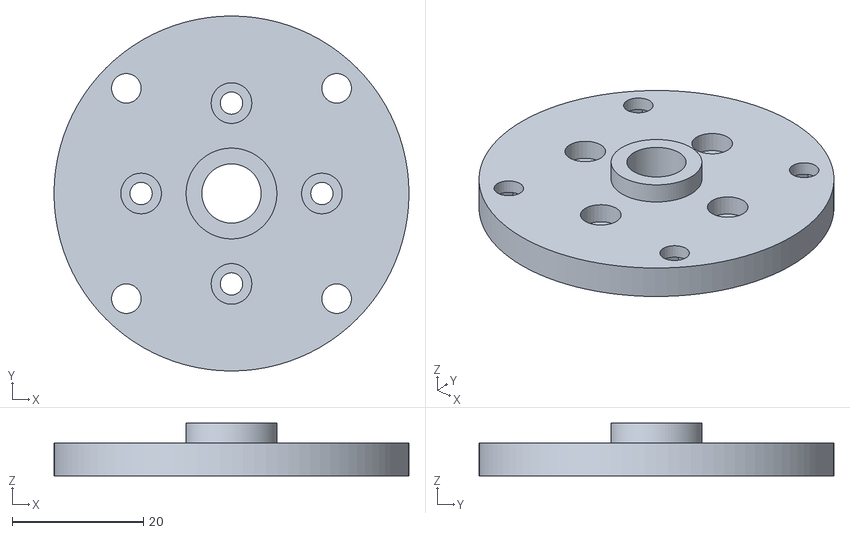
[picture p133: CAD file, 2026-10-12]
arm/printed/gearbox_adapter_J2.stl
54.0 x 54.0 x 8.00
