BZKDP/robot-arm/arm/printed/kfl_adapter_v2_PETG.stl

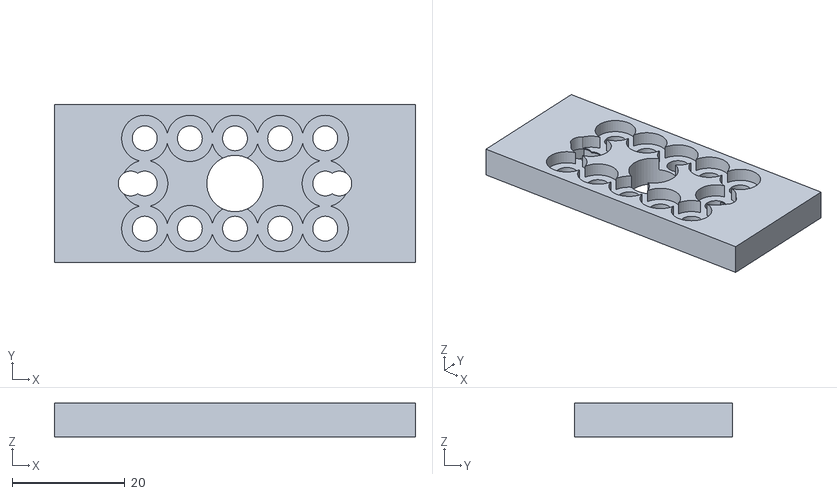
[picture p134: CAD file, 2026-10-12]
arm/printed/kfl_adapter_v2_PETG.stl
64.0 x 28.0 x 6.00
