BZKDP/robot-arm/arm/printed/flange_coupling_8mm_VERT_PETG.stl

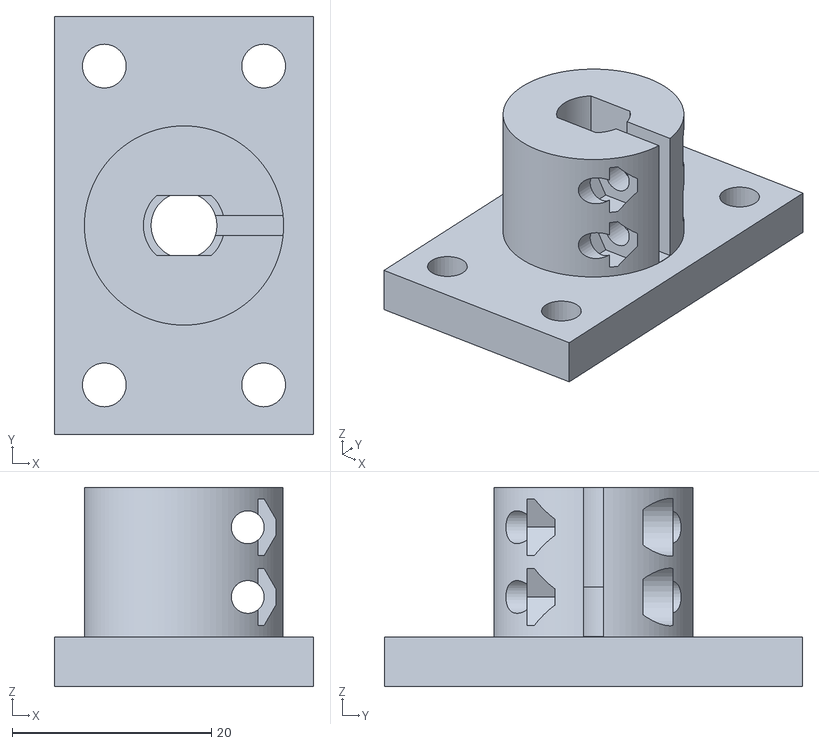
[picture p135: CAD file, 2026-10-12]
arm/printed/flange_coupling_8mm_VERT_PETG.stl
26.0 x 42.0 x 20.0
