BZKDP/robot-arm/arm/printed/as5600_bracket_PETG.stl

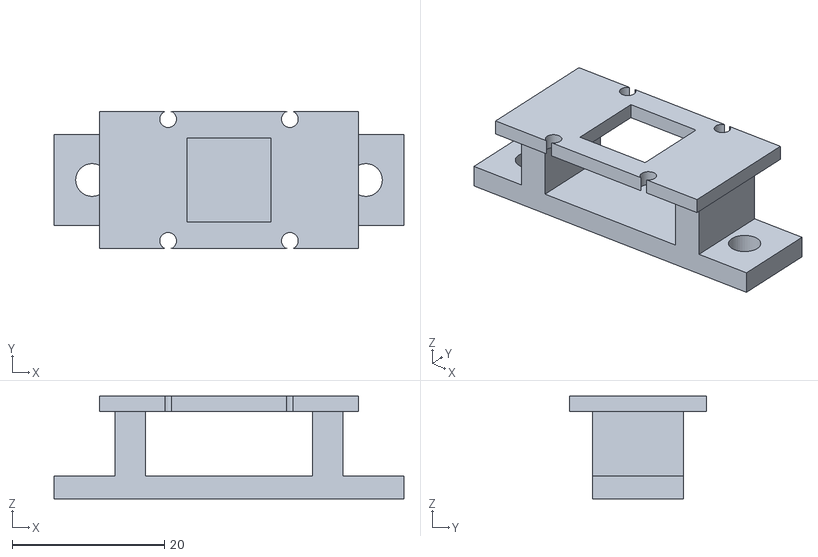
[picture p136: CAD file, 2026-10-12]
arm/printed/as5600_bracket_PETG.stl
46.0 x 18.0 x 13.5
