BZKDP/robot-arm/arm/printed/flange_bridge_PETG.stl

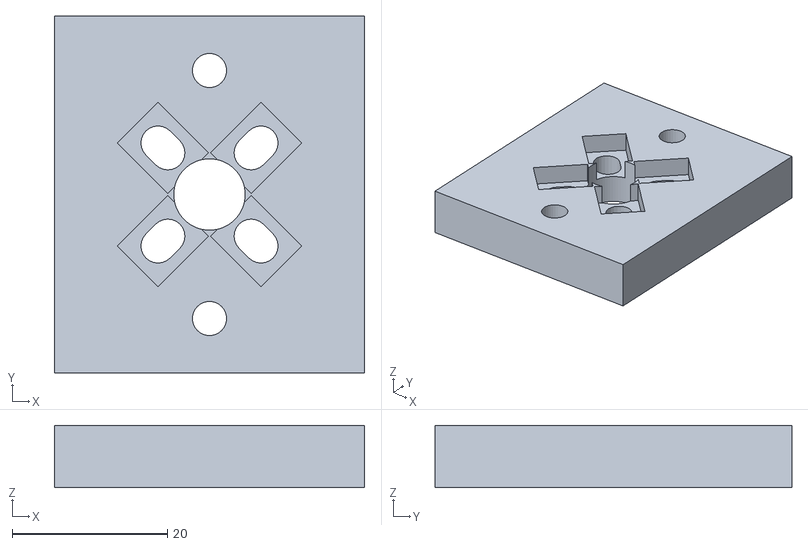
[picture p137: CAD file, 2026-10-12]
arm/printed/flange_bridge_PETG.stl
40.0 x 46.0 x 8.00
