BZKDP/robot-arm/arm/printed/axle_clamp_v2_PETG.stl

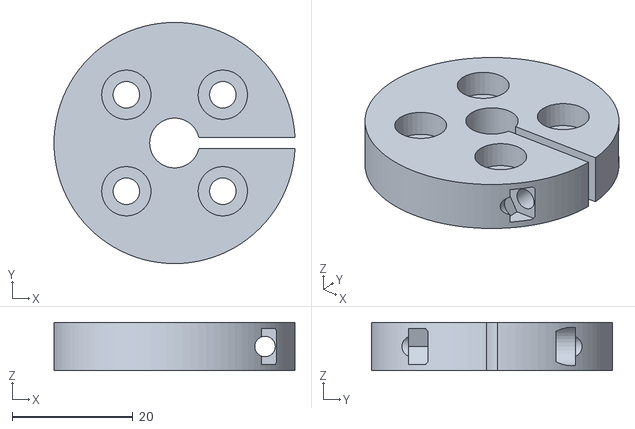
[picture p138: CAD file, 2026-10-12]
arm/printed/axle_clamp_v2_PETG.stl
40.0 x 40.0 x 8.00
