BZKDP/robot-arm/arm/printed/PLATE_ROLL_CUP_V3_FINAL.stl

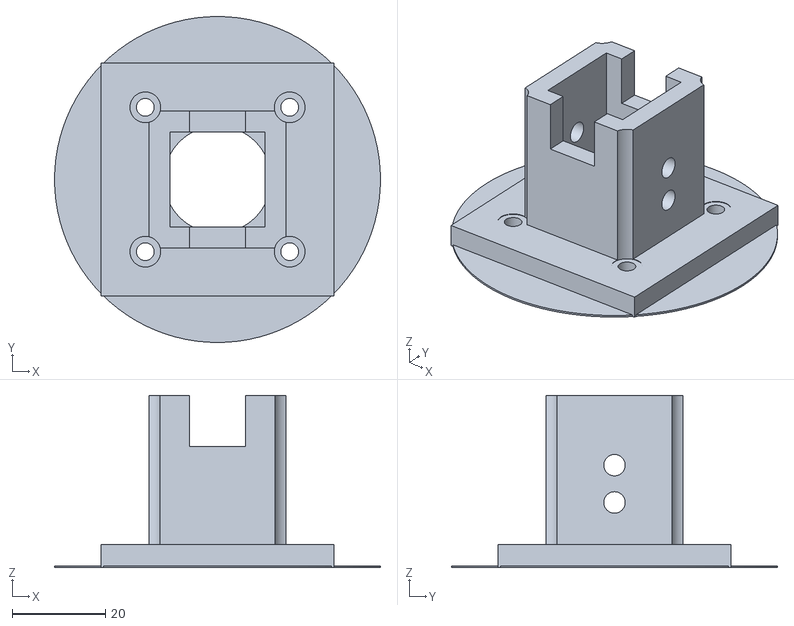
[picture p139: CAD file, 2026-10-12]
arm/printed/PLATE_ROLL_CUP_V3_FINAL.stl
70.0 x 70.0 x 37.0
