BZKDP/robot-arm/arm/printed/PLATE_J3_ADDON_NO_SENSORS_FINAL.stl

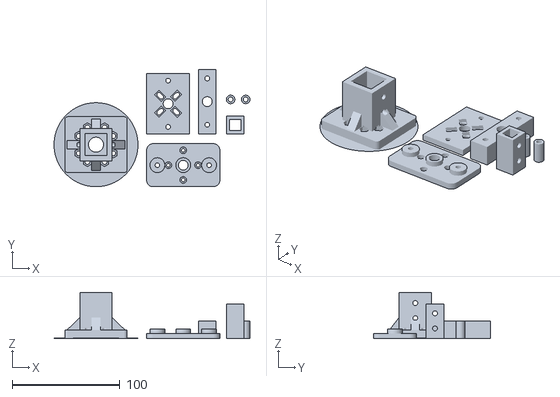
[picture p140: CAD file, 2026-10-12]
arm/printed/PLATE_J3_ADDON_NO_SENSORS_FINAL.stl
182.0 x 109.0 x 43.0
