BZKDP/robot-arm/arm/printed/gearbox_adapter_J2_v2.stl

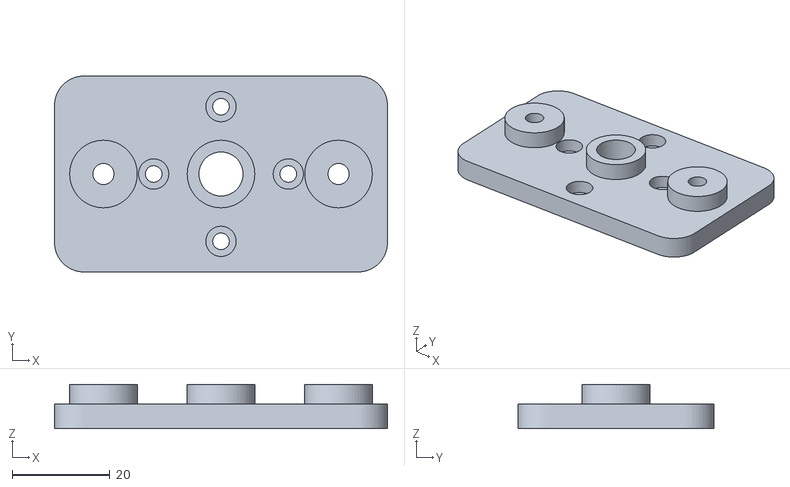
[picture p141: CAD file, 2026-10-12]
arm/printed/gearbox_adapter_J2_v2.stl
68.0 x 40.0 x 8.99
