BZKDP/robot-arm/arm/printed/wrist_mount_N14_PETG.stl

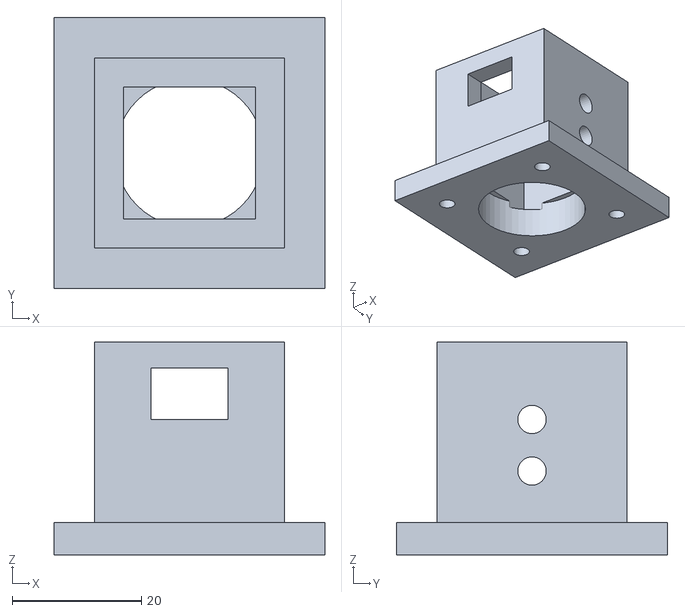
[picture p142: CAD file, 2026-10-12]
arm/printed/wrist_mount_N14_PETG.stl
42.0 x 42.0 x 33.0
