BZKDP/robot-arm/arm/printed/PLATE_ROBOARM_ALL.stl

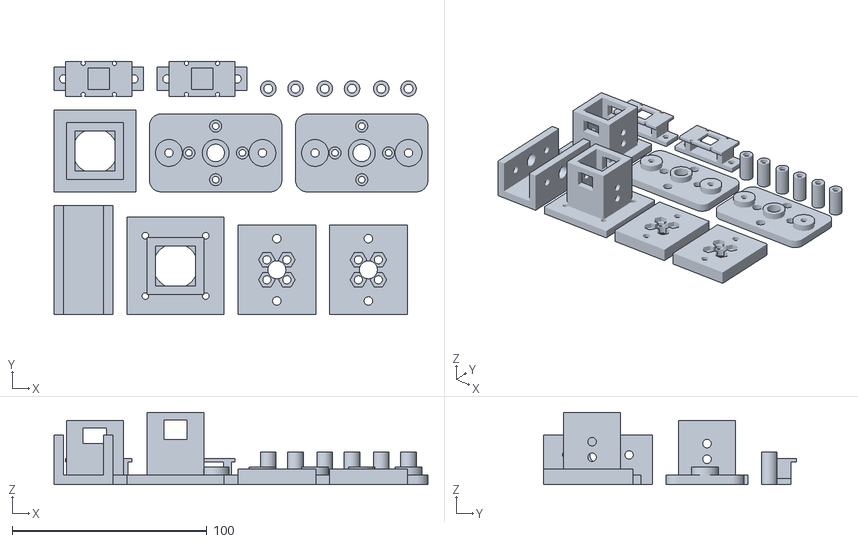
[picture p143: CAD file, 2026-10-12]
arm/printed/PLATE_ROBOARM_ALL.stl
192.0 x 130.0 x 37.0
