BZKDP/robot-arm/arm/printed/roll_cage_v5_M5X80_front_frame_TOP_PETG.stl

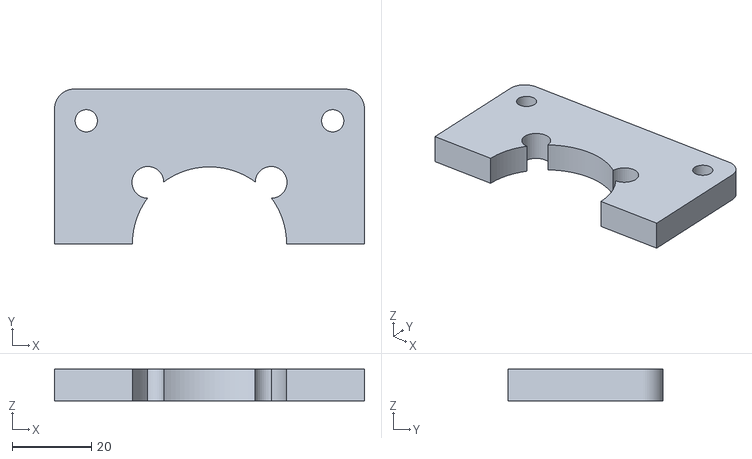
[picture p144: CAD file, 2026-10-12]
arm/printed/roll_cage_v5_M5X80_front_frame_TOP_PETG.stl
78.0 x 39.0 x 8.00
