BZKDP/robot-arm/arm/printed/gearbox_spacer_5mm_PETG.stl

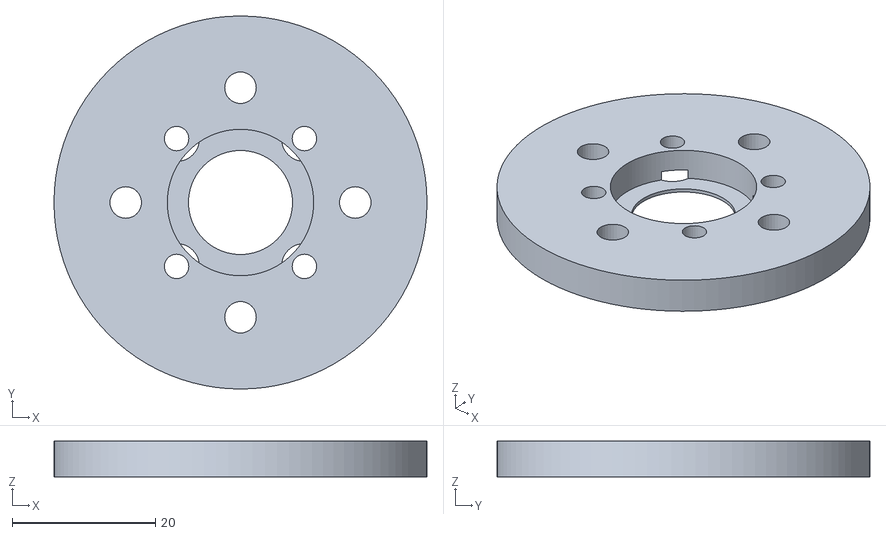
[picture p145: CAD file, 2026-10-12]
arm/printed/gearbox_spacer_5mm_PETG.stl
52.0 x 52.0 x 5.00
