BZKDP/robot-arm/arm/printed/PLATE_JOINT_V4.stl

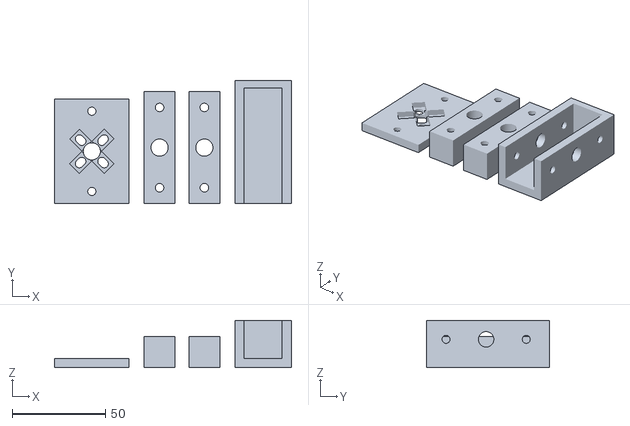
[picture p146: CAD file, 2026-10-12]
arm/printed/PLATE_JOINT_V4.stl
127.0 x 66.0 x 25.4
