BZKDP/robot-arm/arm/printed/flange_bridge_T5_PETG.stl

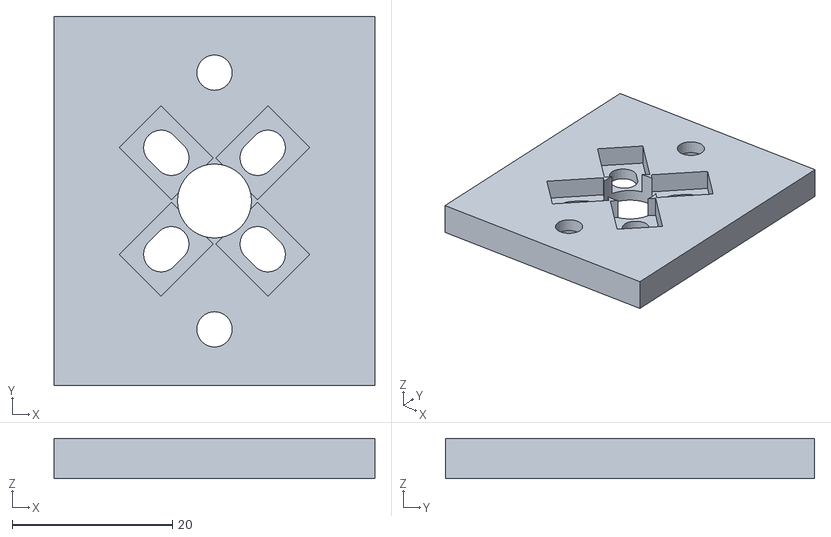
[picture p148: CAD file, 2026-10-12]
arm/printed/flange_bridge_T5_PETG.stl
40.0 x 46.0 x 5.00
