BZKDP/robot-arm/(list of files, cad)

Other CAD files:
arm/electronics_carrier_v1/electronics_carrier_FINAL_ASSEMBLY_REVIEW_ONLY.stl
arm/electronics_carrier_v1/electronics_carrier_FINAL_TRAY_Ender3V3SE.stl
arm/printed/base_motor_vise_cage_v1/base_vise_cage_v1_motor_fit_test_43mm.stl
pan-tilt-tracker/twin/static/models/pan_motor.stl
arm/printed/base_motor_vise_cage_v1/base_vise_cage_v1_front_frame_TOP_PETG.stl
arm/printed/roll_cage_v5_M5X80_rear_square_key_PETG.stl
arm/electronics_carrier_v1/electronics_carrier_v1_TOP_PREVIEW_DO_NOT_PRINT.stl
arm/printed/PLATE_BRIDGE_V7_FINAL.stl
arm/printed/TEST_FLANGE_PATTERN_V6_PLUS10.stl
arm/printed/PLATE_2_ROLL_CUP.stl
arm/printed/flange_bridge_v6_T5_PETG.stl
arm/printed/roll_cage_v4_front_frame_TOP_PETG.stl
arm/printed/roll_mount_PETG.stl
arm/printed/roll_cage_v5_M5X80_front_frame_BOTTOM_PETG.stl
arm/base_j1/base_arm_v1.scad
arm/base_j1/base_arm_v2.scad
arm/base_j1/base_arm_v3.scad
arm/printed/PLATE_ROLL_CAGE_V4_NO_MOTOR_SCREWS_FINAL.stl
arm/printed/PLATE_ROLL_CAGE_V5_M5X80_NO_MOTOR_SCREWS_FINAL.stl
arm/printed/coupling_v2_PETG.stl
arm/printed/drill_jig_v3_PETG.stl
arm/printed/j3_nut_cassette_v4_single_PETG.stl
arm/printed/nut_cassette_v4_x2_PETG.stl
arm/printed/nut_cassette_x2_PETG.stl
arm/printed/roll_cage_v4_rear_cup_NO_MOTOR_SCREWS_PETG.stl
arm/printed/roll_cage_v5_M5X80_rear_cup_NO_MOTOR_SCREWS_PETG.stl
