BZKDP/robot-arm/arm/electronics_carrier_v1/FINAL_PRINT_AND_ASSEMBLY_RU.md

# Финальная кассета электроники роборуки

## Что печатать

Печатать отдельно только два файла:

1. `electronics_carrier_FINAL_TOP_Ender3V3SE.stl` — верхняя монтажная пластина.
2. `electronics_carrier_FINAL_TRAY_Ender3V3SE.stl` — нижний короб для проводки.

`electronics_carrier_FINAL_ASSEMBLY_REVIEW_ONLY.stl` печатать нельзя: это сборка из пересекающихся деталей только для визуального просмотра.

## Ориентация и настройки Ender-3 V3 SE

- Верхняя пластина: большой плоской стороной на стол, направляющими и посадочными зонами вверх.
- Нижний короб: дном на стол, открытой стороной вверх.
- Сопло: 0,4 мм.
- Слой: 0,20 мм.
- Стенки: 4 линии.
- Верх/низ: 5 слоёв.
- Заполнение: 25–30%, Gyroid или Cubic.
- Поддержки: выключить.
- Brim: 5 мм.
- Материал: PETG предпочтительнее для окончательной детали; PLA подходит для пробной сборки.
- Температуры и обдув: использовать уже проверенный профиль конкретной катушки, а не случайные универсальные значения.

Обе детали имеют основание 200×140 мм. На столе 220×220 мм остаётся по 10 мм с коротких сторон; с brim 5 мм — по 5 мм. Печатать детали по одной.

## Крепёж

- Соединение верхней пластины с коробом: 6 винтов M3×20 DIN 912. В коробе сделаны пилотные отверстия 2,8 мм под аккуратное самонарезание винтом M3 в пластик. Затягивать без большого усилия.
- Две клеммные колодки CH-22: 4 винта M3×10–12, четыре шайбы M3 и четыре самоконтрящиеся гайки M3. Точная длина зависит от фактической толщины ушка колодки; сначала сделать сухую примерку.
- ESP32 и драйверы удерживаются направляющими и рядами выводов. При необходимости добавить тонкие нейлоновые стяжки через предусмотренные прорези.
- Конденсатор 470 мкФ / 50 В лежит горизонтально в нижнем отсеке и фиксируется стяжкой через две прорези.

## Что означают все отверстия

- Спереди: окно USB-C ESP32, 22×10 мм в стенке и увеличенный проход 22×14 мм в верхней пластине.
- Слева: ввод низковольтного питания 12 В, 10×16 мм.
- Сзади: пять отдельных вырезов 12×10 мм для кабелей пяти двигателей.
- Справа: шесть небольших вырезов 10×8 мм — пять кабелей будущих датчиков положения локтей и один запасной AUX.
- Рядом с внешними вводами находятся парные прорези под стяжки: кабель фиксируется к корпусу, и рывок не передаётся на пайку.
- Пустая зона снизу справа на верхней пластине — это не отдельная деталь и не обязательная плата. Там только универсальные прорези под стяжки на случай, если позже понадобится закрепить хаб или разветвитель датчиков.

## Питание и клеммные колодки

Левая CH-22 используется для +12 В, правая — для GND. Важный момент: соседние каналы CH-22 электрически не объединены. Каждая пара вход–выход является отдельным каналом.

Поэтому внутри нижнего отсека нужны две изолированные точки распределения:

- общая защищённая шина/спайка +12 В;
- общая защищённая шина/спайка GND.

От каждой шины идут шесть отдельных коротких хвостов к шести каналам соответствующей CH-22: пять драйверов и один резерв. Все силовые соединения необходимо изолировать термоусадкой или закрытым клеммным распределителем; открытые скрутки недопустимы.

Ориентир по проводам для коротких внутренних соединений:

- STEP, DIR, UART и прочие сигналы: 0,20–0,35 мм²;
- питание одного драйвера: 0,50–0,75 мм²;
- четыре жилы двигателя: 0,35–0,50 мм²;
- общий вход и общие шины: 1,5–2,5 мм², но окончательное сечение и предохранитель выбираются по реальному току блока питания и всей системы.

В корпус заводится только низковольтная сторона 12 В DC. Сетевые 220 В внутрь этого печатного корпуса не заводить.

## Конденсатор 470 мкФ / 50 В

Это тот цилиндрический электролитический конденсатор, который уже использовался в схеме. Он подключается параллельно питанию как можно ближе к силовому распределению:

- ножка `+` — к +12 В;
- ножка `−`, отмеченная полосой на корпусе, — к GND.

Он сглаживает короткие провалы и выбросы питания от драйверов. Перед включением дважды проверить полярность.

## Порядок сборки

1. Напечатать обе детали и убрать brim.
2. Без пайки примерить ESP32, все пять драйверов и обе CH-22.
3. Проверить доступ к USB-C, кнопкам ESP32, радиаторам и каждому рычагу клемм.
4. Установить клеммные колодки и проверить, что крепёж не касается проводников.
5. Проложить и закрепить стяжками моторные кабели, питание и будущие кабели датчиков.
6. Собрать две изолированные силовые шины, затем сигнальные соединения.
7. Зафиксировать конденсатор и проверить его полярность.
8. Мультиметром проверить отсутствие короткого замыкания между +12 В и GND.
9. Первый запуск выполнить без механической нагрузки и с возможностью сразу отключить 12 В.

Нельзя подключать или отключать моторы при включённом питании драйверов.
