BZKDP/robot-arm/arm/electronics_carrier_v1/V2_PREVIEW_LAYOUT_AND_WIRING_RU.md

# Монтажная кассета V2 PREVIEW

## Что находится в корпусе

- ESP32 №1 — управление пятью драйверами моторов.
- ESP32 №2 — опрос пяти датчиков угла AS5600.
- 5 драйверов LERDGE TMC2209.
- 2 клеммные колодки CH-22/12P-1/1 для силового питания.
- 3 распределителя F15 размером 39,8 × 29 × 14,5 мм.
- CJMCU-9548 / TCA9548A размером примерно 31,5 × 21,4–22 мм.
- Выключатель REXANT ASW-17D 12 В / 35 А.
- Конденсатор 470 мкФ / 50 В между +12 V и GND возле питания драйверов.

Сами пять AS5600 находятся на суставах роборуки. В корпус заходят пять отдельных четырёхжильных кабелей S1–S5. Шестой прежний ввод `AUX` теперь назначен четырёхжильному кабелю `HALL-J1`: 3V3, GND, OUT_A, OUT_B.

## Почему ESP32 две и как они работают с компьютером

Обе платы — обычные ESP32 DevKit, без экрана и без сенсорного дисплея.

- ESP32 №1 подключается к компьютеру своим USB-C и появляется как первый COM-порт.
- ESP32 №2 подключается вторым USB-C и появляется как второй COM-порт.
- Компьютерная программа может одновременно открыть оба COM-порта.
- На первом этапе прямой информационный провод между ESP32 не нужен.
- Земля обеих частей системы должна быть общей.
- Пины 3V3 двух ESP32 соединять между собой нельзя.

Позже для автономной работы без двух USB можно добавить отдельную связь между ESP32, но это не требуется для текущей механической сборки.

## Назначение трёх F15

1. `F1 / 3V3-MOT`: вход от 3V3 моторной ESP32, пять выходов на VIO пяти TMC2209.
2. `F2 / 3V3-SENS`: вход от 3V3 датчиковой ESP32, пять выходов на VCC пяти AS5600.
3. `F3 / GND-SENS`: вход от GND датчиковой ESP32, пять выходов на GND пяти AS5600.

CJMCU-9548 подключается короткими проводами прямо к 3V3 и GND датчиковой ESP32. Если на одном пине ESP32 неудобно размещать два провода, его питание можно взять с соответствующих входных проводов F2/F3, но 3V3 моторной и датчиковой ESP32 всё равно должны оставаться раздельными.

## Подключение CJMCU-9548 и пяти AS5600

Главная сторона мультиплексора:

- `VIN` → `3V3` ESP32 №2.
- `GND` → `GND` ESP32 №2.
- `SDA` → `GPIO21` ESP32 №2.
- `SCL` → `GPIO22` ESP32 №2.
- `RST` обычно не подключать; на плате он подтянут.
- `A0`, `A1`, `A2` оставить в состоянии по умолчанию, если адрес мультиплексора не требуется менять.

Датчики:

- AS5600 №1: `SDA → SD0`, `SCL → SC0`.
- AS5600 №2: `SDA → SD1`, `SCL → SC1`.
- AS5600 №3: `SDA → SD2`, `SCL → SC2`.
- AS5600 №4: `SDA → SD3`, `SCL → SC3`.
- AS5600 №5: `SDA → SD4`, `SCL → SC4`.
- Все пять `VCC` идут на F2.
- Все пять `GND` идут на F3.

Каждый датчик использует свой четырёхжильный кабель. Линии SDA/SCL разных датчиков нельзя скручивать в одну общую пару до CJMCU-9548: именно мультиплексор разделяет одинаковые адреса AS5600 `0x36`.

## Выключатель ASW-17D

В модель заложены размеры с присланного чертежа:

- номинальное окно панели: 34,2 × 20,2 мм;
- окно в основной V2-модели: 34,5 × 20,5 мм;
- наружная рамка: 38,5 × 22,5 мм;
- ориентировочная необходимая глубина под корпус и клеммы: 33 мм;
- полезная высота нового нижнего отсека: 37 мм.

Отдельный `electronics_carrier_V2_SWITCH_FIT_TEST.stl` содержит три окна. Слева направо:

1. 34,2 × 20,2 мм;
2. 34,5 × 20,5 мм — этот размер сейчас стоит в корпусе;
3. 34,8 × 20,8 мм.

После получения выключателя сначала напечатать тест. Точный номер силовых и светодиодных контактов определить по маркировке на корпусе и прозвоном; по одной фотографии передней стороны назначать четыре клеммы нельзя. Две контактные группы не следует соединять параллельно для увеличения тока.

Планируемая функция выключателя: разрывать положительную линию +12 V, питающую VM всех пяти драйверов. ESP32 при этом могут оставаться подключёнными к USB для логирования. Это удобное штатное отключение моторов, но не сертифицированная аварийная остановка.

## Силовые CH-22

Соседние каналы CH-22 электрически изолированы. Одна колодка не становится общей шиной автоматически. Для колодки +12 V и колодки GND нужен рассчитанный на общий ток внутренний распределитель/перемычки. Нельзя считать, что все 12 отверстий уже соединены между собой.

## Кабельные вводы

- Спереди: два отдельных широких выхода USB-C.
- Сзади: пять отдельных выходов кабелей двигателей J1–J5.
- Справа: пять отдельных выходов S1–S5 для AS5600 и один выход `HALL-J1` через прежнее отверстие AUX.
- Слева: ввод основного кабеля 12 V.
- Возле внешних вводов есть пары прорезей под стяжки для разгрузки пайки.

## Печать

- Верх: 200 × 160 мм, толщиной 3 мм; печатать большой плоской стороной на стол, направляющими вверх.
- Короб: 200 × 160 × 40 мм; печатать дном на стол, открытой стороной вверх.
- Тест выключателя: 128 × 38 × 3 мм; печатать плоско.
- Сетки TOP, TRAY и SWITCH TEST замкнуты и состоят из одного тела.
- Детали помещаются на стол Ender-3 V3 SE 220 × 220 мм, включая brim 5 мм.

До получения и измерения ESP32, F15, CJMCU-9548 и выключателя основные STL остаются `V2_PREVIEW`. После контрольных замеров нужно заменить их финальной ревизией, а не печатать весь корпус вслепую.
