BZKDP/robot-arm/arm/joint_module_v1/README_PRINT_THIS_FIRST.md

# Joint module V1 print pack

Printer target: Creality Ender 3 V3 SE / 220x220x250 mm.

Files:
- joint_module_open_frame_v1.stl: open frame for NEMA17 + CM36 gearbox + AS5600 + GX12-8.
- shaft_magnet_cap_8mm_v1.stl: small 8 mm shaft cap with magnet pocket; print this first for AS5600 testing.
- output_hub_8mm_flange_as5600_v1.stl: optional rotating output hub with 4x M4 link holes and magnet pocket.

Recommended first print:
- Material: PLA+ or PETG.
- Layer height: 0.20 mm.
- Walls: 4.
- Infill: 35-45%.
- Supports: off for the open frame; the small horizontal holes can bridge.
- Brim: on for the open frame if bed adhesion is weak.

Important:
- This is V1 for fitting and bench tests, not the final heavy-load joint.
- AS5600 board mounts on the inner side of the vertical sensor plate.
- Magnet goes into the 6.2 mm pocket; the magnet face must be centered on the shaft axis.
- The 8.3 mm shaft hole is intentionally loose. Use the M3 pilot hole as a set screw/tap point.

Generated files:
- joint_module_open_frame_v1.stl
- shaft_magnet_cap_8mm_v1.stl
- output_hub_8mm_flange_as5600_v1.stl
