BZKDP/robot-arm/arm/printed/BRIDGE_V6_PRINT_AND_FIT.md

# Мост V6/T5 — ещё +10% после физического пробника V5

- Предыдущая цель V5: BC 18,15 мм.
- Новая цель: 18,15 × 1,10 = **19,965 мм**, номинально **20,0 мм**.
- Радиальные пазы V6 принимают BC **17,0…23,0 мм**.
- Интерфейс трубы не изменён: M4 на ±21,5 мм, мост 40 × 56 × 5 мм.
- Крепёж муфты остаётся M3.

Сначала печатать `TEST_FLANGE_PATTERN_V6_PLUS10.stl`. После успешной примерки — `flange_bridge_v6_T5_PETG.stl`.
