BZKDP/robot-arm/arm/printed/CURRENT_PRINT_FILES.md

# Актуальные печатные файлы роборуки — 2026-08-28

## Добавление нового J3 — 2026-08-30

Для добавления локтя J3 без магнитных датчиков печатать один файл:

- `PLATE_J3_ADDON_NO_SENSORS_FINAL.stl` — стакан J2→J3, полый внутренний вкладыш, адаптер редуктора v2, мост V7, одна кассета v4 и две распорные втулки уже напечатанного roll-стакана.

Отдельный файл нового стакана для просмотра/повторной печати:

- `j3_tube_to_u_cup_v1_FINAL_PETG.stl`.

Подробные настройки, крепёж и порядок сборки: `J3_ADDON_PRINT_AND_ASSEMBLY_RU.md`.

AS5600, магнит и их крепления в этот комплект намеренно не входят.

## Печатать сейчас

1. `flange_bridge_v7_FINAL_T5_PETG.stl` — готовый мост J2/J5, ещё +5% после V6; без отдельного пробника.
2. `roll_mount_v3_FINAL_PRINTSAFE_PETG.stl` — стакан roll NEMA17 со встроенным удерживающим кантом и без закрытого мостика окна.

Копии с короткими именами:

- `PLATE_BRIDGE_V7_FINAL.stl` = тот же мост V7/T5.
- `PLATE_ROLL_CUP_V3_FINAL.stl` = тот же стакан roll V3.

## Не перепечатывать, если уже есть нормальные детали

- `gearbox_adapter_J2_v2.stl` — адаптер редуктора v2.
- `nut_cassette_v4_x2_PETG.stl` — две половины кассеты гаек для трубы.
- `drill_jig_v4_PETG.stl` — кондуктор текущей сверловки.
- `as5600_bracket_PETG.stl` — козырёк AS5600.

## Не использовать как источник текущей печати

- `PLATE_ROBOARM_ALL.stl` — общая старая плита с устаревшим мостом, втулками и старым стаканом.
- `PLATE_1_J2_SET.stl` — старая сборка J2.
- `PLATE_JOINT_V4.stl` — содержит мост V4 с ошибочным возвратом интерфейса муфты к M4.
- `flange_bridge_PETG.stl`, `flange_bridge_T5_PETG.stl`, `flange_bridge_v4_PETG.stl`, `PLATE_JOINT_V4.stl` — архивные мосты.
- `flange_bridge_v5_T5_PETG.stl`, `PLATE_BRIDGE_V5.stl`, `TEST_FLANGE_PATTERN_V5.stl` — предыдущая V5; физический пробник потребовал ещё +10%.
- `flange_bridge_v6_T5_PETG.stl`, `PLATE_BRIDGE_V6.stl`, `TEST_FLANGE_PATTERN_V6_PLUS10.stl` — предыдущая V6; финальная V7 вынесена ещё на 5%.
- `roll_mount_PETG.stl`, `PLATE_2_ROLL_CUP.stl` — старый стакан без нормального доступа к головкам M3.
- `roll_mount_v2_PETG.stl`, `PLATE_2_ROLL_CUP_V2.stl` — промежуточный стакан V2 без встроенного удерживающего канта.
- `wrist_mount_N14_PETG.stl` — прототип маленького стакана кисти. Перед будущей печатью ему нужна отдельная V2 по реальному NEMA14.
- `tube_spacers_x2_PETG.stl` — старые отдельные распорки; для текущего J2 используется полная кассета v4.

## Крепёж двух деталей текущей очереди

- Мост → металлическая муфта: 4 × M3×7 и 4 × гайка M3.
- Мост → труба: 2 × M4×16 в кассету v4.
- Стакан roll → труба: 2 × M4×35 минимум; лучше M4×40 с шайбами/нейлоками и внутренними распорками.
- Стакан roll → NEMA17: штатные стяжные M3 заменить по одному на винты той же резьбы, но на 5 мм длиннее. Сначала измерить реальный штатный винт.
