BZKDP/robot-arm/arm/printed/FINAL_V7_V3_PRINT.md

# Финальная отдельная печать: мост V7 и стакан V3

## 1. Мост

Файл: `flange_bridge_v7_FINAL_T5_PETG.stl`.

- Ещё +5% после V6: целевой BC 20,963 мм, номинально 21,0 мм.
- Пазы принимают BC 18,0…24,0 мм.
- Трубная часть не менялась.
- Печатать как раньше, 100% масштаб.

## 2. Стакан roll NEMA17

Файл: `roll_mount_v3_FINAL_PRINTSAFE_PETG.stl`.

- В STL уже встроен круглый одноразовый кант Ø70 × 0,4 мм.
- Кант увеличивает сцепление со столом примерно с 2500 до 3848 мм².
- После остывания внешний тонкий круг срезать/отломить по границе фланца 50 × 50 мм.
- Старое закрытое окно провода заменено открытой сверху прорезью: позднего мостика, способного загнуться и поймать сопло, больше нет.
- Печатать фланцем и встроенным кантом на стол, без поддержек, масштаб 100%.
- В слайсере отдельный brim можно выключить: он уже является частью STL. Клей и чистый стол оставить.
