BZKDP/robot-arm/arm/printed/hall_j1_dual_index_v2/HALL_J1_DUAL_INDEX_V2_PRINT_WIRING_AND_ASSEMBLY_RU.md

# J1 Dual Hall Index V2 — печать, проводка и сборка

Узел задаёт одну повторяемую точку механического нуля нижней оси J1. Один
вращающийся магнит проходит между двумя неподвижными линейными датчиками SS49E.
Ноль ищется не по одному жёсткому порогу, а по калиброванному пересечению двух
аналоговых сигналов. Это уменьшает влияние высоты магнита, температуры и его
реальной силы. Это всё ещё индекс, а не непрерывный абсолютный энкодер.

## Реальные размеры, под которые построена модель

- редуктор CM36: Ø36×35 мм, выступ торца Ø22×1,6 мм;
- четыре резьбы M3 по окружности Ø27,5 мм;
- металлическая муфта: хаб Ø14,1, фланец Ø21,8×2 мм;
- дно U-скобы 48×43×2,5 мм;
- готовое отверстие Ø4,2 в точке (11;11), радиус 15,56 мм;
- два голых SS49E: номинальный корпус 4,1×3,0×1,6 мм;
- один аксиально намагниченный неодимовый магнит D3×2 мм.

## Что печатать сначала

1. `hall_j1_SS49E_body_pocket_fit_test_3_sizes_PETG.stl` — три кармана
   4,40×3,30 / 4,60×3,50 / 4,80×3,70 мм. Производственный кронштейн использует
   средний. Датчик должен входить пальцами без изгиба корпуса.
2. `hall_j1_magnet_bushing_fit_set_OD4p00_4p15_4p30_PETG.stl` — выбрать втулку,
   которая плотно входит в настоящее отверстие Ø4,2 без молотка.
3. После примерок можно печатать общий
   `PLATE_HALL_J1_DUAL_INDEX_V2_PRINT_ALL.stl` или отдельные выбранные детали.
   В общей пластине теперь есть основной кронштейн, прижимная рамка, три теста
   втулки магнита и три теста кармана датчика.

## Настройки печати

- PETG, сопло 0,4 мм, слой 0,20 мм;
- 4 стенки, заполнение 35–45%;
- поддержки не нужны;
- шов лучше отвернуть от карманов датчиков;
- для втулок минимальное время слоя 8–10 секунд.

## Что предусмотрено в кронштейне

- два раздельных верхних кармана под плоско уложенные SS49E;
- между карманами 0,8 мм пластика;
- отдельная оранжевая прижимная рамка толщиной 0,9 мм;
- два отверстия рамки Ø3,45 и два пилотных отверстия Ø2,60 в кронштейне под
  два винта M3×6, которые самонарезают резьбу в PETG;
- два закрытых окна рамки над чувствительными поверхностями датчиков;
- наружная перемычка рамки закрывает и защищает утопленные каналы ножек;
- шесть раздельных пазов под три вывода каждого датчика;
- наружный углублённый сервисный карман для пайки ответвлений;
- две сквозные прорези под стяжку 2,5 мм для разгрузки кабеля;
- все провода выходят наружу по неподвижной части и не проходят под кольцом,
  поэтому их не зажимает торцом редуктора.

## Как собрать датчики и кабель

Оба датчика ставить одинаковой стороной: плоская маркированная поверхность
смотрит вверх, к магниту. Сначала положить A и B в два отдельных кармана и
развести все шесть ножек по своим пазам. Затем наложить оранжевую рамку так,
чтобы два окна оказались над корпусами, и равномерно притянуть двумя M3×6.
Затягивать только до исчезновения люфта: тонкая рамка должна прижать корпуса, а
не раздавить их. Клей для удержания датчиков не требуется.

Для оригинального SS49E, если держать маркировкой к себе и выводами вниз: левый
вывод VCC, средний GND, правый OUT. У дешёвого клона распиновку всё равно
подтвердить его описанием или короткой проверкой до пайки.

В сервисном кармане сделать один четырёхжильный кабель:

- красный: VCC обоих SS49E вместе;
- чёрный: GND обоих SS49E вместе;
- жёлтый: OUT датчика A отдельно;
- белый: OUT датчика B отдельно.

Каждое соединение изолировать тонкой термоусадкой. После проверки уложить пайку
в карман, закрепить кабель маленькой стяжкой и только затем добавить немного
нейтрального силикона только в наружном сервисном кармане. Сами корпуса под
прижимной рамкой не заливать.

## Куда подключать в панели

Кабель входит через уже предусмотренный правый ввод `AUX` и подключается только
к ESP32 №2, которая занимается датчиками:

- красный → шина `F2 / 3V3-SENS` (3,3 В датчиковой ESP32);
- чёрный → шина `F3 / GND-SENS`;
- жёлтый OUT_A → `GPIO34` ESP32 №2;
- белый OUT_B → `GPIO35` ESP32 №2.

GPIO34 и GPIO35 — входы ADC1. Они не конфликтуют с TCA9548A: мультиплексор и
пять AS5600 остаются на GPIO21=SDA и GPIO22=SCL. Через TCA9548A SS49E не идут.
Питать их от 5 В нельзя: используем 3,3 В, чтобы аналоговый выход гарантированно
оставался в диапазоне входа ESP32. Земля датчиков и всей системы общая, но 3V3
двух разных ESP32 между собой не соединять.

### Как уложиться в три уже купленных F15

F15 имеет один вход и пять выходов. Если подключены все пять AS5600, свободного
выхода для TCA9548A и Hall-кабеля не остаётся. Два провода в один пружинный зажим
не заталкивать. Для текущей панели сделать два коротких изолированных жгута:

- выход №5 `F2 / 3V3-SENS` → один красный провод 0,5 мм² → под общей термоусадкой
  три ветви: VCC AS5600 №5, VIN TCA9548A и красный Hall J1;
- выход №5 `F3 / GND-SENS` → один чёрный провод 0,5 мм² → три ветви: GND AS5600
  №5, GND TCA9548A и чёрный Hall J1.

Токи здесь малы; смысл утолщённого короткого входного провода — механическая
прочность. Место каждой пайки закрыть отдельно, затем общей термоусадкой и
закрепить стяжкой в нижней части панели. Это оставляет на ESP32 по одному проводу
3V3 и GND. Если позже понадобится полностью разъёмный монтаж без двух спаек,
понадобятся ещё два распределителя 1→5 и новая раскладка панели.

## Механическая сборка

1. Снять муфту/U-скобу с выходного вала.
2. Установить кольцевой кронштейн на неподвижный торец CM36 вокруг Ø22.
3. Закрепить двумя или четырьмя M3, начиная с M3×6; вручную убедиться, что винт
   не упирается в дно резьбы редуктора.
4. Уложить два SS49E лицом вверх, вывести шесть ножек по своим пазам, поставить
   прижимную рамку и равномерно закрепить её двумя M3×6. После этого собрать
   четырёхжильный кабель по схеме выше.
5. Вернуть муфту и U-скобу. Вставить выбранную втулку в отверстие (11;11)
   изнутри U-скобы; карман магнита смотрит вниз.
6. Вклеить один D3×2 заподлицо небольшим количеством эпоксидки.
7. До подачи питания рукой медленно провернуть J1 и проверить отсутствие касания.
   Расчётный вертикальный зазор магнит–корпус датчиков 1,8 мм.

## Как прошивка должна искать ноль

Вдали от магнита запомнить фоновые уровни A0 и B0. При медленном подходе всегда
с одной стороны вычислять `DA=A-A0`, `DB=B-B0`, `D=DA-DB`. Пересечение D через
калиброванный ноль считать индексом только тогда, когда
`abs(DA)+abs(DB)` уже достаточно велико. Эта проверка обязательна: вдали от
магнита A и B тоже почти равны. Добавить усреднение, гистерезис и подтверждение
несколькими последовательными измерениями. После нахождения индекса установить
счётчик J1 в известный ноль; между индексами положение считается по STEP.
