BZKDP/robot-arm/arm/printed/hall_j1_index_v1/HALL_J1_INDEX_V1_PRINT_AND_ASSEMBLY_RU.md

# J1 Hall Index V1 — печать и сборка

Этот узел даёт **одну точку механического нуля** нижней оси J1. Он не измеряет
непрерывный абсолютный угол: между прохождениями магнита положение считается по
шагам двигателя.

## На какие реальные детали рассчитано

- планетарный редуктор CM36: корпус Ø36×35 мм;
- неподвижный выступ торца Ø22×1,6 мм;
- четыре резьбы M3 по окружности Ø27,5 мм;
- металлическая муфта: хаб Ø14,1, фланец Ø21,8×2;
- дно U-скобы 48×43×2,5 мм;
- готовое отверстие U-скобы Ø4,2 в координате (11;11), радиус 15,56 мм;
- голый линейный Hall-датчик **SS49E, flat TO-92-style**;
- обычный аксиально намагниченный неодимовый магнит **D3×2 мм**.

## Что печатать

Для первой примерки печатать `PLATE_HALL_J1_INDEX_V1_PRINT_ALL.stl`. В ней:

1. неподвижный зелёный кронштейн датчика;
2. три втулки магнита со стержнем Ø4,00 / Ø4,15 / Ø4,30 мм.

Выбрать втулку, которая входит в реальное отверстие Ø4,2 плотно от руки. Не
забивать молотком. Основной отдельный файл сделан с Ø4,15 мм.

## Настройки печати

- PETG;
- сопло 0,4 мм;
- слой 0,20 мм;
- 4 стенки;
- заполнение 35–45%;
- поддержки не нужны;
- для маленьких втулок включить минимальное время слоя 8–10 секунд.

## Сборка

1. Снять муфту/U-скобу с выходного вала.
2. Положить кольцевой кронштейн на неподвижный торец CM36 вокруг выступа Ø22.
3. Закрепить двумя или четырьмя винтами M3. Начать с **M3×6**; проверить, что
   винт вошёл в резьбу, но не упёрся в дно. Длина резьбы конкретного редуктора
   должна быть проверена вручную.
4. Уложить SS49E плашмя в верхний карман, чувствительной плоскостью к U-скобе.
   Три вывода вывести по открытым пазам. Зафиксировать каплей нейтрального
   силикона или термоклея, не цианоакрилатом у самого корпуса.
5. Собрать муфту и U-скобу обратно.
6. В отверстие (11;11) U-скобы вставить выбранную втулку **изнутри скобы**.
   Карман магнита должен смотреть вниз, к SS49E.
7. Вклеить D3×2 в карман заподлицо. Начать с небольшого количества эпоксидки.
8. Медленно провернуть J1 рукой на 360° и убедиться, что минимальный механический
   зазор нигде не исчезает. Расчётный зазор магнит–корпус SS49E: 1,8 мм.

## Электрика

SS49E — аналоговый датчик. Проверить распиновку именно своего экземпляра по
маркировке/даташиту, не ориентироваться только по форме корпуса. Для оригинального
Honeywell SS49E питание допустимо 2,7–6,5 В; с ESP32 используем 3,3 В и читаем
аналоговый выход через ADC. Ноль определяется порогом и калибруется программно.

## Важное ограничение

Магнит D3×2 здесь является только индексом. После включения рука должна медленно
найти этот индекс, остановиться и установить счётчик J1 в известное нулевое
положение. Пропущенные шаги между индексами Hall-датчик сам не обнаруживает.
