BZKDP/robot-arm/arm/printed/j4_roll_quad_hall_v6/J4_ROLL_V6_QUAD_HALL_PRINT_AND_ASSEMBLY_RU.md

# J4 ROLL V6 + QUAD HALL — что печатать

Главный единый файл: `PLATE_J4_ROLL_V6_M5X80_PLUS_QUAD_HALL_PRINT_ALL.stl`.

В нём 9 тел: задний стакан, квадратный ключ, две половины передней рамки, два трубных спейсера, Hall-кассета, прижимное кольцо и магнитная втулка.

Габарит пластины: 191.0 × 150.0 мм. На столе 220×220 остаётся нормальный запас; brim у заднего стакана уже встроен в модель.

Клетка: 4× M5×80 + увеличенные шайбы M5 + стопорные гайки M5. Hall: 4× M3×12, 4× M3×6, 4× SS49E, 1× магнит D3×2.

Датчики и магнит устанавливать по инструкции `J4_QUAD_HALL_WIRING_AND_CALIBRATION_RU.md` из этой же папки.
