BZKDP/robot-arm/arm/wiring_v2/wiring_3d_exact.html

# 3D-монтажная плоскость J1 + J2

Две существующие WAGO, два драйвера и ESP32. Дополнительных WAGO нет: разветвления выполняются пайкой и закрываются термоусадкой.

## Основная логика

- Красный выход WAGO «+» → одна пайка → два красных провода в VM драйверов.
- Чёрный выход WAGO «GND» → одна пайка → три чёрных провода: GND драйвера 1, GND драйвера 2, GND ESP32.
- В каждый драйвер идёт только один GND — контакт рядом с VM. Нижний GND рядом с VIO остаётся пустым.
- ESP32 получает питание только через USB. 12 V в ESP32 не идёт.

## Точная векторная 3D-схема

Точная 3D-схема подключения

Нажми на изображение для открытия SVG во весь экран и увеличения.

## Что именно соединить пайкой

1. Соедини вместе один красный входящий и два красных выходящих провода. Выходы идут в два VM.
2. Соедини вместе один чёрный входящий и три чёрных выходящих провода. Выходы идут в GND1, GND2 и GND ESP32.
3. К контакту 3V3 ESP32 можно припаять два синих провода: один в VIO1, второй в VIO2.
4. D25→STEP1, D26→DIR1, D32→STEP2, D33→DIR2.
5. EN/ENN, MS1, MS2, PDN/UART, CLK пока оставить пустыми.

## 3D-концепт расположения компонентов

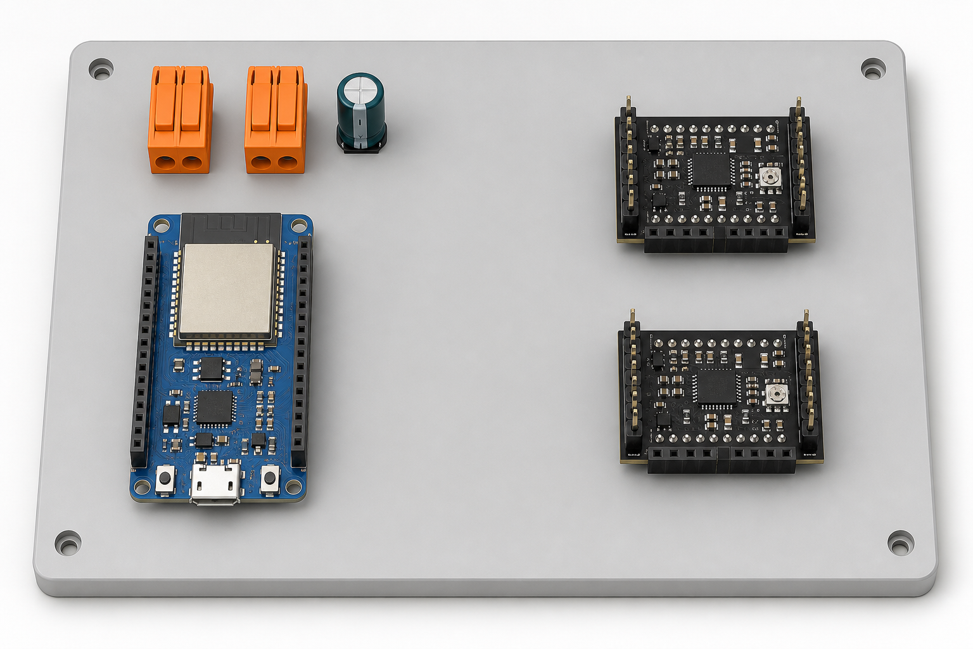
[picture p149: arm/wiring_v2/3d_layout_concept.png]
3D-концепт монтажной плоскости


Это только визуальная основа расположения. Электрически точной является верхняя SVG-схема с подписанными проводами.

## До первого запуска

USB и БП отключены во время пайки. До тестовой прошивки моторный БП 12 V не включать. После сборки сначала прозвоним отсутствие короткого замыкания, затем запустим каждый двигатель отдельно.
