BZKDP/robot-arm/arm/printed/hall_quad_index_v3/HALL_QUAD_INDEX_V3_INTERACTIVE_3D.html

J1 / J4 · QUAD HALL INDEX V3

Четыре неподвижных SS49E через 90° и один вращающийся магнит D3×2. Одинаковая кассета для обоих CM36.

Поворот сустава 0°

Разнести детали 0 мм

▶ АвтовращениеВид сверхуИзометрия

Это 4 абсолютные контрольные позиции на оборот. Между ними угол ведётся по STEP, а индекс исправляет накопленную ошибку.

Что где находится

Зелёное кольцо — неподвижная PETG-кассета на 4×M3 торца CM36.

Оранжевое кольцо — один прижим 4 датчиков, 4×M3×6.

Голубые элементы — четыре SS49E, центры R15,56 мм.

Красное — один магнит D3×2 во вращающейся втулке.

Каждый датчик имеет 3 отдельные канавки. На сустав выходит 6 линий: 3V3, GND и OUT0…OUT3.
