BZKDP/robot-arm/arm/printed/J3_ADDON_PRINT_AND_ASSEMBLY_RU.md

# Новый локоть J3: что печатать и как собрать (без AS5600)

Дата комплекта: 2026-08-30.

## Главный файл для печати

Печатать один файл:

`PLATE_J3_ADDON_NO_SENSORS_FINAL.stl`

- габарит раскладки: **182 × 109 × 42,99 мм**;
- масштаб: **100% по X/Y/Z**;
- все детали уже стоят правильной стороной на столе;
- сетка проверена: замкнутая, без перевёрнутых поверхностей;
- на пластине **7 отдельных тел**.

## Что находится на общей пластине

1. `j3_tube_to_u_cup_v1_FINAL_PETG.stl` — новый силовой стакан **труба J2 → дно U-скобы J3**.
2. `j3_cup_internal_spacer_v1_PETG.stl` — полый внутренний вкладыш стакана: защищает трубу от смятия и оставляет канал для проводов.
3. `gearbox_adapter_J2_v2.stl` — один адаптер редуктора для нового J3.
4. `flange_bridge_v7_FINAL_T5_PETG.stl` — один финальный мост V7 под реальную металлическую муфту.
5. `j3_nut_cassette_v4_single_PETG.stl` — одна кассета гайка+шайба для новой выходной трубы J3.
6. Две маленькие втулки Ø8 × 16,6 из `tube_spacers_x2_PETG.stl` — для крепления уже напечатанного roll-стакана к новой трубе.

Сам roll-стакан в общую пластину **не добавлен**, потому что он уже напечатан.

Кронштейн AS5600, держатель магнита и любые детали датчика в комплект **не добавлены**.

## Размеры нового стакана J2 → J3

- фланец: **58 × 52 × 8 мм**, скруглённые углы;
- наружная гильза: **30 × 30 мм**;
- карман профиля: **20,4 × 20,4 мм**;
- глубина посадки профиля до упора: **33,5 мм**;
- стенка гильзы: **4,8 мм**;
- четыре силовые косынки между гильзой и фланцем;
- центральный проход проводов: **Ø14 мм**;
- крепление к дну U-скобы: **8 × Ø4,6 мм** по штатной сетке `(±16,±8)` и `(±8,±16)`;
- карманы восьми гаек M4: под ключ примерно **7 мм**;
- два поперечных отверстия трубы: **Ø4,6 мм**, расстояние между центрами **14 мм**;
- от торца вставленной трубы центры поперечных отверстий находятся на **9,5 и 23,5 мм**;
- внутренний вкладыш: **16,6 × 16,6 × 32 мм**;
- канал проводов во вкладыше: **10,5 × 10,5 мм**;
- встроенный одноразовый кант для прилипания: **Ø78 × 0,4 мм**.

## Настройки печати PETG

- сопло: **0,4 мм**;
- слой: **0,20 мм**;
- первый слой: **0,24 мм**, скорость 15–20 мм/с;
- периметры: **6**;
- верх/низ: **6 слоёв**;
- заполнение: **100%** для первого рабочего прототипа;
- температура: проверенный профиль конкретного PETG; ориентир **240 °C сопло / 80 °C стол**;
- обдув: 0% первые три слоя, затем не более 30–40%;
- обычная скорость: желательно не выше 50–60 мм/с;
- поддержки: **выключить**;
- компенсация отверстий: **0**;
- отдельный brim слайсера: можно включить **8 мм**, особенно для высокого внутреннего вкладыша;
- клей и чистый обезжиренный стол оставить.

Стакан уже имеет собственный сплошной кант Ø78. Дополнительный brim вокруг него не мешает; он просто увеличит удаляемую кромку.

## После печати

1. Дождаться полного остывания стола.
2. Срезать тонкий внешний круг вокруг фланца стакана.
3. Удалить мембрану первых двух слоёв из центрального Ø14 и из восьми M4-отверстий.
4. Не срезать четыре толстые косынки: это силовая часть.
5. Проверить трубу-калибр: профиль 20×20 должен войти от руки с лёгким сопротивлением, без молотка.
6. Снять только слоновью ногу и отдельные наплывы. Не растачивать карман целиком заранее.
7. Восемь гаек M4 должны входить в карманы с плотной посадкой и не проворачиваться.

## Металл, который нужен для добавления J3

- 1 × U-скоба **96 × 48 мм**, дно примерно 48 × 43 × 2,5 мм;
- 1 × большой NEMA17 для J3;
- 1 × CM36 1:71;
- 1 × металлическая фланцевая муфта на вал Ø8;
- 1 × KFL08;
- 1 × профиль **20 × 20 × 1,5 мм**, отрезок **110 мм** — новое звено J3 → roll;
- 1 × пруток Ø8, отрезок **36 мм** — противоположная опорная ось J3.

Существующая труба J2 длиной 140 мм остаётся; новый стакан надевается на её свободный конец.

## Крепёж по соединениям

### Стакан → дно U-скобы J3

- 8 × M4×16;
- 8 × гайка M4 в карманы стакана;
- 8 × шайба M4 под головки внутри скобы.

Винты идут **изнутри U-скобы наружу**, через штатные восемь отверстий. Скобу сверлить не нужно. Предпочтительны низкие полукруглые головки M4 (ISO 7380), чтобы оставить больше свободного места внутри скобы.

### Стакан → существующая труба J2

- 2 × M4×40;
- 2 × гайка M4 nyloc;
- 4 × шайба M4;
- печатный полый вкладыш 16,6 × 16,6 × 32.

### Редуктор → адаптер v2 → стенка A скобы J3

- 4 × M3×10 в резьбы редуктора;
- 2 × M4×12 в крайние бобышки адаптера;
- 2 × гайка M4 и шайбы.

### Металлическая муфта → мост V7 → новая труба 110 мм

- муфта → мост: 4 × M3×7 и 4 × гайка M3;
- мост → труба: 2 × M4×16;
- внутри трубы: 2 × гайка M4 и 2 × шайба в печатной кассете v4.

### KFL08 → стенка B скобы J3

- 2 × M4×16;
- 2 × гайка M4 nyloc;
- шайбы;
- пруток Ø8 × 36 мм.

### Новая труба 110 мм → уже напечатанный roll-стакан

- 2 × M4×40;
- 2 × гайка M4 nyloc;
- 4 × шайба M4;
- две печатные втулки Ø8 × 16,6 мм из общей пластины.

## Сборка стакана J2 → J3

0. Снять уже напечатанный roll-стакан со свободного конца существующей трубы J2. Он не выбрасывается: после сборки J3 переедет на дальний конец новой трубы 110 мм.
1. Вставить восемь обычных гаек M4 в шестигранные карманы стакана со стороны гильзы.
2. Приложить плоскую сторону фланца к **наружной** поверхности дна U-скобы; гильза смотрит в сторону трубы J2.
3. Изнутри скобы поставить восемь M4×16 с шайбами.
4. Наживить все восемь винтов, затем затягивать крест-накрест в несколько проходов. PETG не перетягивать.
5. Проложить моторные провода через центральный Ø14 и через канал вкладыша. В местах будущих поперечных болтов отвести жгут выше или ниже оси отверстия, чтобы винт не пережал изоляцию.
6. Вставить полый вкладыш в трубу **заподлицо с её торцом**, совместив его отверстия с будущими отверстиями трубы.
7. Вставить трубу в стакан до жёсткого упора — глубина 33,5 мм.
8. Зажать сборку. Через отверстия стакана сначала просверлить трубу малым сверлом, затем довести до Ø4,5–4,6 на низкой скорости. Не перегревать PETG.
9. Установить два M4×40 с шайбами и nyloc. Затянуть до исчезновения люфта, но не сминать стакан.

## Подготовка новой трубы J3 → roll, 110 мм

1. Отрезать профиль ровно **110 ±0,5 мм**, торцы сделать перпендикулярными и убрать заусенцы.
2. Со стороны шарнира J3 надеть уже существующий `drill_jig_v4_PETG.stl` до упора.
3. Просверлить насквозь:
   - Ø4,3 мм на 8,5 мм от торца;
   - Ø8,2 мм на 30 мм от торца;
   - Ø4,3 мм на 51,5 мм от торца.
4. Вставить кассету v4 с двумя шайбами и гайками M4 и прикрутить мост двумя M4×16.
5. Установить пруток Ø8 × 36 через центральное отверстие трубы и KFL08. До проверки геометрии не клеить.
6. С другого торца вставить трубу в уже напечатанный roll-стакан до упора.
7. По отверстиям roll-стакана просверлить два Ø4,5–4,6. Внутрь поставить две втулки Ø8 × 16,6 и стянуть двумя M4×40.

## Контроль до подачи питания

1. Рукой провести J3 по всему допустимому диапазону.
2. Убедиться, что мост, труба и головки KFL08 нигде не касаются стенок скобы.
3. Проверить, что пруток Ø8 жёстко вращается вместе с трубой и не плавает осево.
4. Проверить, что ни один поперечный M4 не пережал проводку.
5. Проверить все гайки повторно после первых медленных циклов.
6. Первые испытания делать без нагрузки, с ограниченным током и малой скоростью.

## Важное ограничение

Новый J3 заметно увеличивает массу и изгибающий момент на J2. PETG-стакан рассчитан как усиленный прототип с глубоким заходом и восемью точками крепления, но после проверки кинематики нагруженные печатные фланцы лучше со временем перенести в алюминий 4–5 мм. Датчики положения добавляются отдельной следующей итерацией и не нужны для сухой механической сборки.
