BZKDP/robot-arm/arm/printed/ROLL_CAGE_V4_NO_MOTOR_SCREWS_PRINT_RU.md

# Roll V4: крепление NEMA17 без откручивания заводских винтов

Эта версия предназначена для случая, когда четыре длинных винта задней крышки NEMA17 невозможно выкрутить или их головки уже повреждены.

## Принцип

Заводские винты остаются в моторе и не несут нагрузку. Мотор зажимается целиком между задним стаканом и разъёмной передней рамкой четырьмя внешними M4.

Передача момента:

`труба 20×20 → задний стакан → квадратный ключ 43 мм → корпус NEMA17 → передняя рамка → четыре внешние стяжки`

## Что сначала посмотреть

- `ROLL_CAGE_V4_NO_MOTOR_SCREWS_3D_REVIEW.html` — интерактивная разборная модель;
- `ROLL_CAGE_V4_NO_MOTOR_SCREWS_REVIEW.png` — наглядный лист;
- `roll_cage_v4_rear_cup_NO_MOTOR_SCREWS_PETG.stl` — отдельный новый стакан.

## Файл полной печати

`PLATE_ROLL_CAGE_V4_NO_MOTOR_SCREWS_FINAL.stl`

- габарит: **172 × 152 × 41,99 мм**;
- шесть отдельных печатных тел;
- помещается на стол 220×220 мм;
- все детали уже ориентированы для печати.

На пластине:

1. Новый задний стакан с глубокой посадкой трубы.
2. Голубой квадратный ключ против проворота мотора.
3. Верхняя половина передней рамки.
4. Нижняя половина передней рамки.
5. Две распорные втулки для поперечных M4 трубы.

## Рекомендуемый пробник

Перед полной печатью можно напечатать только:

`roll_cage_v4_rear_square_key_PETG.stl`

Его внутренний размер **43,0 × 43,0 мм** под известный корпус мотора примерно 42,3 мм. Ключ должен надеваться на первые 3,5 мм задней части корпуса от руки, без молотка, и не должен заметно болтаться.

Если он не садится, полную клетку пока не печатать — сообщить фактический размер корпуса и требуемую поправку.

## Основные размеры

### Задний стакан

- силовая плита: **76 × 76 × 8 мм**;
- печатный одноразовый кант: Ø88 × 0,4 мм;
- карман профиля: **20,4 × 20,4 мм**;
- заход трубы: **32,5 мм**;
- наружная гильза: 30,4 × 30,4 мм;
- два отверстия M4 трубы: Ø4,6;
- центральный проход проводов: Ø23;
- четыре кармана под нетронутые заводские головки: **Ø8,2 × 5 мм**;
- отверстия внешних стяжек: Ø4,6 на сетке **62 × 62 мм**.

### Клетка мотора

- известный корпус NEMA17: примерно 42,3 × 42,3 мм;
- квадратный ключ: 43,0 × 43,0 × 3,5 мм;
- наружный размер передней рамки: 76 × 76 мм;
- проход вокруг CM36: Ø38,8 мм под редуктор Ø36;
- передняя рамка разделена горизонтально на две части, поэтому редуктор снимать не нужно.

## Принятые допущения

Модель основана на размерах проекта:

- NEMA17: 42,3 × 42,3 мм;
- короткий NEMA 17 оси roll: корпус 42,3 × 42,3 мм, длина около 47 мм;
- длинный 17HS8401: длина около 48 мм (в этой сборке не используется);
- CM36: Ø36 мм;
- металлическая пластина между мотором и редуктором: приблизительно до 56 × 56 мм.

Оси внешних стяжек находятся на ±31 мм. Расчётный зазор от угла пластины 56×56 до тела винта M4 — около 1,9 мм. Если реальная пластина шире 56 мм, имеет выступающие углы или разъёмы, перед полной печатью потребуется поправить сетку стяжек.

## Крепёж

- 4 × полностью резьбовой M4×75;
- 8 × широкая шайба M4;
- 4 × гайка M4 nyloc;
- 2 × M4×40 для стакана и трубы;
- 4 × шайба M4 для трубы;
- 2 × гайка M4 nyloc для трубы;
- две печатные распорные втулки из общей STL.

M4×75 выбран с запасом под плиту 8 мм, короткий мотор около 47 мм, металлическую пластину, переднюю рамку 8 мм и гайку. Длина мотора не зашита в пластиковую деталь: она влияет только на требуемую длину внешних стяжек. Если M4×75 нет в продаже, без изменения модели используется M4×80: лишние 5 мм останутся перед гайкой и при желании срезаются после сборки. M4×70 без контрольного измерения не брать — с двумя шайбами и гайкой он может оказаться коротким.

### Что заказать

Для одной клетки требуется:

- 4 винта M4×75, DIN 912 / ISO 4762, с цилиндрической головкой и внутренним шестигранником;
- 2 винта M4×40 того же типа;
- 12 увеличенных шайб M4, DIN 9021 / ISO 7093-1, наружный диаметр 12 мм;
- 6 самоконтрящихся гаек M4, DIN 985, с нейлоновым кольцом.

Практичная фасовка с запасом: 10 винтов M4×75, 10 винтов M4×40, 20 шайб и 10 гаек. Стандартный шаг резьбы M4 — 0,7 мм. Подходит оцинкованная сталь класса не ниже 8.8 либо нержавеющая A2-70.

Точные поисковые фразы:

- `винт M4x75 DIN 912 внутренний шестигранник` либо доступная замена `винт M4x80 DIN 912 внутренний шестигранник`;
- `винт M4x40 DIN 912 внутренний шестигранник`;
- `шайба увеличенная M4 DIN 9021 12 мм`;
- `гайка самоконтрящаяся M4 DIN 985 с нейлоновым кольцом`.

Если M4×75 не находится, запасной вариант: `шпилька резьбовая M4 DIN 975` и отрезать четыре участка по 78–82 мм. В этом варианте нужны дополнительные четыре обычные гайки M4 DIN 934 со стороны, где у винта обычно была бы головка.

## Настройки PETG

- масштаб 100%;
- сопло 0,4 мм;
- слой 0,20 мм;
- первый слой 0,24 мм и 15–20 мм/с;
- 6 периметров;
- 6 верхних/нижних слоёв;
- заполнение 100%;
- поддержки выключены;
- ориентир температуры: 240 °C сопло / 80 °C стол либо проверенный профиль PETG;
- обдув 0% первые три слоя, далее 30–40%;
- обычная скорость не выше 50–60 мм/с;
- отдельный brim слайсера 6–8 мм допустим.

Задний стакан уже имеет встроенный кант Ø88.

## Обработка после печати

1. После полного остывания убрать внешний тонкий круг заднего стакана.
2. Открыть мембраны первого слоя в центральном отверстии, отверстиях четырёх внешних M4 и четырёх карманах заводских головок.
3. Не срезать четыре силовые косынки.
4. Проверить профиль 20×20 в кармане.
5. Проверить квадратный ключ на моторе.
6. Сложить две передние половины вокруг редуктора и убедиться, что между CM36 и Ø38,8 остаётся равномерный зазор.

## Порядок сборки

1. Вставить две распорные втулки в профиль 20×20.
2. Вставить профиль в задний стакан до упора и просверлить по двум отверстиям стакана.
3. Стянуть профиль двумя M4×40 с шайбами и nyloc.
4. Надеть квадратный ключ на первые 3,5 мм задней части корпуса мотора. Прорезь ключа совместить с выходом провода.
5. Приложить задний стакан к задней крышке. Четыре старые головки должны свободно войти в карманы Ø8,2 и нигде не упираться.
6. Верхнюю и нижнюю зелёные половины завести сбоку вокруг корпуса CM36 и прижать к металлической пластине/передней части мотора.
7. Установить четыре внешние M4×75 с широкими шайбами. Гайки nyloc находятся на передней стороне.
8. Наживить все четыре, выровнять мотор по квадратному ключу и затягивать крест-накрест в несколько проходов.
9. Затяжку остановить сразу после исчезновения люфта. Не пытаться сдавить металлический корпус мотора.

Для увеличения трения можно положить между задней крышкой и стаканом тонкую резиновую или TPU-прокладку 0,5–1 мм. Тогда длину внешних винтов проверить повторно.

## Контроль

- мотор не поворачивается внутри квадратного ключа;
- задняя плита и зелёная передняя рамка параллельны;
- внешние M4 не касаются корпуса мотора, металлической пластины и проводов;
- заводские головки не воспринимают давление;
- редуктор свободно проходит через Ø38,8;
- после первых циклов повторно проверить внешние гайки.

Это более тяжёлое крепление, чем старый стакан на четырёх заводских винтах, но оно ремонтопригодно и позволяет использовать моторы с повреждёнными головками без вскрытия двигателя.
