BZKDP/robot-arm/arm/printed/ROLL_CUP_V2_PRINT_AND_FIT.md

# Стакан roll NEMA17 V2 — печать и сборка

Рабочий файл: `roll_mount_v2_PETG.stl`. Файл `PLATE_2_ROLL_CUP_V2.stl` — его копия с названием печатной очереди.

## Почему появилась V2

У старого `roll_mount_PETG.stl` квадрат отверстий NEMA17 был правильным — 31 × 31 мм, — но головки M3 DIN912 частично пересекались с углами вертикальной стенки стакана. В V2 добавлены четыре вертикальных выреза Ø6,6 мм: головка и шестигранник теперь доступны по всей высоте. Отверстия M3 увеличены с 3,4 до 3,8 мм с учётом PETG, поперечные M4 — с 4,4 до 4,6 мм.

## Проверить до печати/сборки

- Реальная труба должна быть около 20,0 × 20,0 мм; карман модели — 20,4 × 20,4 мм.
- У задних стяжных винтов реального NEMA17 должен быть квадрат центров 31 × 31 мм.
- Не угадывать длину длинных M3. Выкрутить **один** штатный стяжной винт мотора, измерить длину под головкой и купить такой же M3, но примерно на 5 мм длиннее из-за толщины фланца. На моторе длиной около 47–48 мм это часто окажется M3×50 или M3×55, но решает измерение конкретного винта.
- Стяжные винты двигателя заменять строго по одному, чтобы не сместить крышки и ротор.

## Крепёж стакана к трубе

- Наружная ширина стакана — 29,4 мм.
- M4×30 слишком короток для нормальной гайки.
- Минимально: 2 × M4×35 с обычными гайками.
- Удобнее с шайбами/нейлоками: 2 × M4×40.
- Внутри трубы на каждом болте должна стоять распорная втулка длиной около 16,6 мм, иначе M4 сомнёт стенки трубы 1,5 мм.

## Печать

- Фланцем 50 × 50 мм на стол.
- PETG, слой 0,20 мм, первый слой 0,24 мм.
- 5–6 периметров, 5–6 верхних/нижних слоёв, заполнение 60–100%.
- Стол около 80 °C, сопло по проверенному профилю PETG.
- Масштаб 100%; поддержки не нужны.

## Порядок сборки

1. До установки трубы приложить стакан к задней крышке NEMA17.
2. Меняя штатные стяжные винты по одному на удлинённые, притянуть фланец стакана к мотору. Не перетягивать: резьба M3 в крышке небольшая.
3. Вставить трубу в карман до упора и перенести центры двух поперечных отверстий.
4. Просверлить трубу, убрать стружку и заусенцы, вставить внутренние распорки.
5. Стянуть стакан с трубой двумя M4×35/40.
6. До установки редуктора проверить соосность и отсутствие качания мотора относительно трубы.
