BZKDP/robot-arm/arm/printed/base_motor_vise_cage_v1/BASE_VISE_CAGE_V1_PRINT_AND_ASSEMBLY_RU.md

# Корпус нижнего NEMA17 для зажима в тисках — V1

## Назначение

Корпус закрывает самый нижний NEMA17 и позволяет зажимать в тисках широкие печатные стенки, а не алюминиевый корпус двигателя. Заводские четыре винта двигателя не откручиваются и не несут нагрузку.

Передача момента:

`тиски → нижняя печатная обойма → квадратный корпус NEMA17 → редуктор → основание роборуки`

От осевого смещения двигатель удерживают задняя плита и передняя разъёмная рамка. Весь пакет стягивают четыре внешних M5×80.

## Принятые размеры

- корпус NEMA17: 42,3 × 42,3 мм;
- длина нижнего двигателя: примерно 47–48 мм;
- редуктор CM36: Ø36 × 35 мм;
- карман двух обойм: 43,2 мм;
- задний ключ против вращения: 43,0 мм;
- проход передней рамки: Ø38,8 мм;
- наружная ширина обоймы: 72 мм;
- задняя и передняя рамки: 78 × 78 × 8 мм;
- отверстия M5: Ø5,8 мм на сетке 62 × 62 мм, как у roll-клетки V5.

## Что сначала напечатать

Сначала напечатать только:

`base_vise_cage_v1_motor_fit_test_43mm.stl`

Это пробный квадрат 43,0 мм. Он должен надеваться на первые 3,5 мм задней части корпуса NEMA17 рукой, без молотка, и не должен заметно болтаться.

Если пробник не надевается, не печатать полную клетку. Нужно измерить фактическую сторону корпуса мотора и изменить посадку.

## Полный файл для печати

`PLATE_BASE_VISE_CAGE_V1_PRINT_ALL.stl`

- габарит: 186,5 × 168 × 33 мм;
- пять отдельных печатных тел;
- помещается на стол Ender-3 V3 SE 220 × 220 мм;
- все детали уже ориентированы для печати.

На пластине:

1. Задняя силовая плита со встроенным квадратным ключом.
2. Нижняя силовая обойма с широкими плоскими поверхностями для тисков.
3. Верхняя крышка с пятью вентиляционными прорезями.
4. Верхняя половина передней рамки.
5. Нижняя половина передней рамки.

Отдельные STL находятся в той же папке, если детали удобнее печатать по одной.

## Крепёж на одну клетку

- 4 × M5×80 DIN 912;
- 8 × увеличенная шайба M5 DIN 9021;
- 4 × самоконтрящаяся гайка M5 DIN 985.

M4×40 для этого корпуса не требуется. Он остаётся для соединения roll-стакана с профильной трубой 20×20.

Для двух клеток — уже существующей roll V5 и новой нижней:

- 8 × M5×80;
- 16 × шайба M5;
- 8 × гайка M5 nyloc.

Заказанных 20 винтов M5×80, 20 шайб и 50 гаек достаточно с запасом. Для roll-клетки дополнительно нужны 2 × M4×40, шайбы M4 и гайки M4.

## Настройки печати PETG

- масштаб: 100%;
- сопло: 0,4 мм;
- слой: 0,20 мм;
- первый слой: 0,24 мм и 15–20 мм/с;
- 6 периметров;
- 6 верхних и нижних слоёв;
- заполнение: 70–100%; для тисков рекомендовано 100%;
- поддержки: выключены;
- brim: 6–8 мм для двух крупных обойм;
- температура: проверенный профиль PETG, ориентировочно 240 °C / 80 °C;
- обычная скорость: не выше 50–60 мм/с.

Не использовать PLA: мотор нагревается, а тиски создают длительную нагрузку.

## Порядок сборки

1. Проверить пробник 43,0 мм на моторе.
2. Положить двигатель в нижнюю оранжевую обойму. Вал и редуктор смотрят в сторону передней зелёной рамки.
3. Вывести провод через нижнее заднее окно. Провод не должен проходить возле M5.
4. Установить верхнюю обойму вентиляционными пазами вверх.
5. Приложить заднюю плиту. Встроенный квадрат должен охватить край задней крышки, а четыре штатные головки — свободно войти в карманы Ø8,2.
6. Две половины передней рамки завести сбоку вокруг редуктора CM36.
7. Вставить четыре M5×80 через заднюю плиту, продольные каналы обойм и переднюю рамку.
8. С обеих сторон использовать увеличенные шайбы. Гайки nyloc удобнее оставить на передней стороне.
9. Наживить все четыре гайки и затягивать крест-накрест небольшими шагами.
10. Остановить затяжку сразу после исчезновения люфта. Нельзя пытаться сдавить металлический корпус мотора или деформировать PETG.

## Установка в тиски

- зажимать только широкие плоские боковые стенки нижней обоймы;
- редуктор, передняя рамка, M5 и провод должны находиться выше губок;
- предпочтительны гладкие или мягкие накладки губок;
- не зажимать за верхнюю вентилируемую крышку;
- не использовать длинную трубу как рычаг во время затяжки;
- усилие тисков увеличивать только до исчезновения перемещения корпуса.

Тиски остаются временным стендом, а не частью сертифицированного промышленного основания. Перед быстрыми движениями роборуки проверить устойчивость самого стола и крепление тисков.

## Контроль после сборки

- мотор не вращается внутри квадратной посадки;
- задняя и передняя рамки параллельны;
- четыре M5 не касаются двигателя, редуктора и проводов;
- заводские головки не воспринимают давление;
- CM36 свободно проходит через Ø38,8;
- вентиляционные прорези сверху не перекрыты;
- после первых циклов повторно проверить затяжку M5 и тисков.
