BZKDP/robot-arm/arm/printed/J3_CONNECTION_3D_REVIEW.html

# J2 → J3: разбор соединения

Это отдельная увеличенная модель только проблемного места. ЛКМ — вращать, колесо — масштаб, ПКМ — двигать камеру.

Разнести детали 0%

СобраноРазобрано

Показать печатный кант

Открыть STL стакана

Оранжевый стакан в модели показан без удаляемого канта. В STL кант уже встроен и появляется при включении флажка.

Серое — существующая труба 20×20×1,5
Она входит в стакан на 33,5 мм. Карман сделан 20,4×20,4 мм.

Оранжевое — новый печатный стакан
Фланец 58×52×8 мм; глубокая гильза 30×30 мм; четыре силовые косынки.

Жёлтые — восемь M4×16
Головки внутри U-скобы. Винты проходят через восемь штатных Ø4,2 и затягиваются в гайки стакана. Скобу сверлить не надо.

Красные — два M4×40
Проходят насквозь: стакан → обе стенки трубы → голубой вкладыш. Между ними 14 мм.

Голубой — внутренний вкладыш
Не даёт смять профиль. Канал 10,5×10,5 оставляет путь для проводов.

Порядок
1) Гайки M4 в карманы стакана. 2) Стакан к скобе восемью M4×16. 3) Провода через центр. 4) Вкладыш внутрь трубы. 5) Трубу до упора. 6) Просверлить по отверстиям стакана и поставить два M4×40.

✓ Сетка скобы: (±16,±8) и (±8,±16). ✓ Центральный проход Ø14. ✓ Датчиков/магнитов в печатном комплекте нет.

ТРУБА J2 → СТАКАН → 8×M4 → ДНО U-СКОБЫ J3
