BZKDP/robot-arm/arm/printed/ROLL_CAGE_V5_M5X80_NO_MOTOR_SCREWS_3D_REVIEW.html

# Roll V5 M5×80 — NEMA17 без разборки

Модель специально для случая, когда четыре винта задней крышки не откручиваются. ЛКМ — вращать, колесо — масштаб, ПКМ — двигать камеру.

Разнести детали 0%

СобраноРазобрано

Скрыть редуктор

Открыть общую STLТест 43 мм

Сначала можно напечатать только голубой квадрат и проверить посадку на корпус 42,3 мм. Полную пластину пока печатать необязательно.

Красные — четыре заводских винта
Они остаются закрученными. В оранжевой плите под их головки сделаны свободные карманы Ø8,2.

Оранжевый — новый задний стакан
Он принимает профиль 20×20 и упирается плоской стороной в заднюю крышку мотора.

Голубой — квадрат 43,0 мм
Охватывает первые 3,5 мм корпуса NEMA17 и не позволяет мотору провернуться. Для провода сделана открытая прорезь.

Зелёные — две передние половины
Ставятся сбоку вокруг уже собранного CM36. Проход Ø38,8 рассчитан на корпус редуктора Ø36.

Жёлтые — четыре внешние M5×80
Отверстия Ø5,6 расположены на сетке 62×62 мм снаружи корпуса мотора и приблизительно 56-мм металлической пластины. Опорные рамки расширены до 78 мм под шайбы M5 Ø15.

Сборка
1) Труба в оранжевый стакан. 2) Голубой квадрат на задний торец мотора. 3) Стакан к задней крышке. 4) Зелёные половины вокруг редуктора. 5) Четыре внешние M5×80, шайбы и nyloc затянуть крест-накрест.

✓ Заводские винты не выкручиваются. ✓ Редуктор снимать не требуется. ✓ На общую пластину добавлены две распорные втулки трубы.

ТРУБА → ЗАДНИЙ СТАКАН → МОТОР → 4 ВНЕШНИЕ СТЯЖКИ → ПЕРЕДНЯЯ РАМКА
