BZKDP/robot-arm/arm/printed/base_motor_vise_cage_v1/BASE_VISE_CAGE_V1_INTERACTIVE_3D.html

# Нижний NEMA17 — корпус для тисков

Разборная клетка без откручивания заводских винтов. ЛКМ — вращать, колесо — масштаб, ПКМ — двигать камеру.

Разнести детали 0%

СобраноРазобраноОбъёмСбоку

Показать губки тисков

Скрыть мотор и редуктор

Вся клетка STLПробник 43 ммОбзор PNG

Порядок: сначала пробник 43 мм, затем полная пластина. Тиски зажимают только широкие плоские стенки нижней оранжевой обоймы.

Оранжевые детали — корпус
Нижняя обойма принимает давление тисков. Верхняя закрывает мотор и имеет пять вентиляционных пазов. Внутренний карман 43,2 мм под корпус 42,3 мм.

Задняя плита и ключ 43,0 мм
Квадрат охватывает задний край двигателя и не даёт ему проворачиваться. Под четыре нетронутые заводские головки сделаны карманы Ø8,2. Снизу открыто окно провода.

Зелёная передняя рамка
Разделена на две половины и ставится вокруг уже установленного CM36. Центральный проход Ø38,8 рассчитан на редуктор Ø36.

Четыре M5×80
Проходят вдоль клетки на той же сетке 62×62 мм, что и в roll-клетке V5, и стягивают заднюю плиту, обоймы и переднюю рамку. На каждый винт нужны две шайбы M5 и одна гайка nyloc.

Серые детали — губки тисков
Они показаны только для объяснения и не входят в STL. Губки касаются нижней печатной обоймы. Мотор, редуктор, провод и крепёж не зажимаются.

Ограничение
Не затягивать тиски и M5 «со всей силы». PETG должен только убрать люфт. Перед быстрыми движениями проверить крепление тисков к столу.

✓ Заводские винты не трогаются. ✓ Редуктор не снимается. ✓ Общая печатная пластина 186,5×168 мм помещается на Ender‑3 V3 SE.

ТИСКИ → НИЖНЯЯ ОБОЙМА → КОРПУС NEMA17 → CM36 → ОСНОВАНИЕ РОБОРУКИ
