BZKDP/robot-arm/arm/printed/hall_j1_dual_index_v2/HALL_J1_DUAL_INDEX_V2_INTERACTIVE_3D.html

# J1 · Дифференциальный Hall-индекс

Поворот U-скобы: 0°

МАГНИТ МЕЖДУ A И B · НУЛЕВОЙ ИНДЕКС

Показывать прозрачную U-скобу

Показывать оранжевую прижимную рамку

Показывать оба датчика A и B

Вид карманов сверхуРазнести деталиОбщий вид

Зелёное — неподвижный кронштейн на торце CM36.
Голубое — вращающаяся U-скоба.
Красное — магнит D3×2.

Жёлтый A и фиолетовый B — два отдельных SS49E. Оранжевая рамка прижимает оба корпуса двумя M3×6.

Сборка: положить A и B маркировкой к магниту → ножки в шесть зелёных каналов → сверху рамка → равномерно затянуть 2×M3×6.
