BZKDP/robot-arm/arm/printed/BRIDGE_V5_PRINT_AND_FIT.md

# Пластина-мост V5/T5 — архив после физической проверки

Пробник V5 потребовал ещё +10%. Текущие файлы: `TEST_FLANGE_PATTERN_V6_PLUS10.stl` и `flange_bridge_v6_T5_PETG.stl`.

## Что исправлено

- Геометрия пластины сохранена: **40 × 56 × 5 мм**.
- Отверстия трубы сохранены на прежних местах: **±21,5 мм от оси**, под M4.
- Крепёж металлической муфты исправлен с ошибочного M4 на **M3**.
- Вместо одной жёсткой окружности сделаны четыре радиальных паза шириной **4,0 мм**.
- Пазы принимают расстояние между противоположными центрами крепежа (**BC**) от **15,0 до 21,0 мм**.
- Измеренное ранее BC муфты: **16,5 мм**.
- Запрошенное увеличение на 10%: **18,15 мм**. Оно находится внутри диапазона пазов с запасом.

Пазы сделаны намеренно: после нескольких несовпавших версий не требуется угадывать ещё одну единственную окружность отверстий. Муфту можно точно отцентрировать по валу и только затем равномерно затянуть четыре винта.

## Какие файлы использовать

1. `TEST_FLANGE_PATTERN_V5.stl` — маленький тестовый образец 30 × 30 × 5 мм. Сначала напечатать его и проверить реальную муфту.
2. `flange_bridge_v5_T5_PETG.stl` — окончательная рабочая пластина.
3. `PLATE_BRIDGE_V5.stl` — копия той же рабочей пластины с коротким именем.

Старые `flange_bridge_v4_PETG.stl`, `PLATE_JOINT_V4.stl` и общие печатные столы использовать для этой детали не надо: в них осталась противоречивая версия интерфейса муфты.

## Крепёж

- Муфта → пластина: **4 × M3×7** и **4 × гайка M3**.
- Если есть только M3×10, укоротить их до примерно 7 мм и убрать заусенец.
- Пластина → труба: **2 × M4×16**, шайбы и уже спроектированная кассета с гайками.
- Не заменять винты муфты на M4: физические отверстия металлической муфты около Ø3,5 мм.

## Настройки PETG

- Ориентация: плоской стороной муфты (`Z=0`) на стол; карманы гаек будут смотреть вверх.
- Слой: 0,20 мм; первый слой 0,24 мм.
- Периметры: 5–6.
- Верх/низ: 5–6 слоёв.
- Заполнение: 100%.
- Сопло: около 240 °C; стол: около 80 °C — либо проверенный профиль конкретного PETG.
- Обдув: не более 40%, первые три слоя без обдува.
- Скорость первого слоя: около 20 мм/с.
- Масштаб модели: **100% по всем осям**. Не растягивать STL в слайсере.
- Компенсацию отверстий сначала оставить нулевой: запас уже заложен в пазах.

## Проверка тестового образца

1. Удалить только наплыв первого слоя и свободные нити. Не растачивать пазы заранее.
2. Вставить четыре M3 через металлическую муфту и тестовый образец.
3. Все четыре винта должны проходить без изгиба и без принудительного перекоса муфты.
4. Центрировать муфту по центральному отверстию/валу, после чего затягивать винты крест-накрест.
5. Убедиться, что гайки M3 удерживаются в направляющих и не проворачиваются.
6. Только после успешной проверки печатать полную пластину.

Если мешает лишь слоновья нога первого слоя, снять фаску ножом или вручную пройти отверстие сверлом без изменения межцентрового расстояния. Горячим винтом отверстия не прожигать: так легко увести ось и ослабить PETG.

## Порядок сборки узла J2

1. На столе, без двигателя, прикрутить муфту к пластине четырьмя M3 и проверить её центровку.
2. Вставить в трубу кассету с гайками и совместить её с отверстиями трубы.
3. Прикрутить пластину к трубе двумя M4×16.
4. Поставить трубу в U-кронштейн и установить противоположную опорную ось с подшипником.
5. Вручную провернуть узел по всему предполагаемому диапазону. Между головками M4 опорного подшипника и трубой должен оставаться реальный зазор.
6. Только после свободной ручной проверки соединять муфту с редуктором и подавать питание.

## Важные механические замечания

- Расчётный зазор T5 возле второй стенки — около **4,7 мм**. Обычная головка M4 высотой около 4 мм помещается, но запас небольшой. Низкая полукруглая головка M4 (ISO 7380) безопаснее.
- Противоположную ось Ø8 нельзя оставлять свободно вращаться или плавать в отверстии трубы/кассеты. После пробной сборки её нужно жёстко зафиксировать либо переделать кассету под зажим/стопорный винт.
- PETG-пластина пригодна для прототипа и испытаний. После отладки геометрии нагруженный J2 разумно перенести в алюминий толщиной 4–5 мм.
- После первых циклов и прогрева проверить затяжку M3/M4: PETG со временем проминается под постоянным усилием.

## Машинная проверка модели

Скрипт `audit_bridge_v5.py` проверяет:

- замкнутость сетки STL;
- габарит 40 × 56 × 5 мм;
- положение отверстий трубы ±21,5 мм;
- прохождение точек BC=18,15 мм, то есть измеренного BC=16,5 мм, увеличенного на 10%;
- отсутствие случайного изменения остальных интерфейсов.
