BZKDP/robot-arm/arm/j1_j2_two_motor_wiring_no_sensors_preview.png

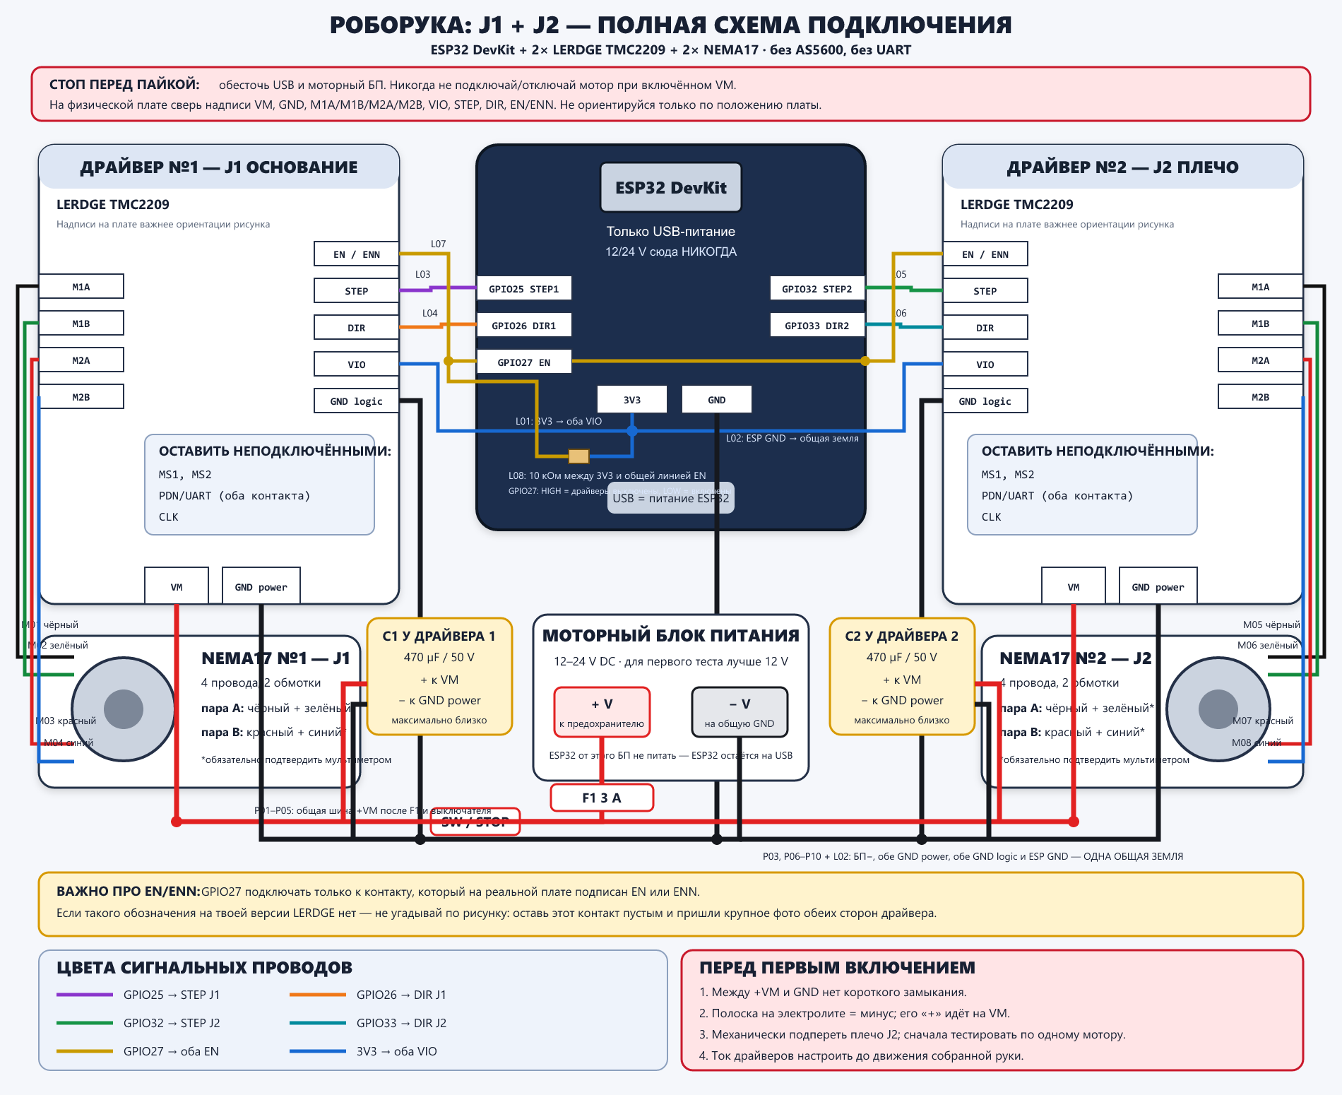
arm/j1_j2_two_motor_wiring_no_sensors_preview.png
