BZKDP/robot-arm/arm/j1_j2_wiring_simple_wago_preview.png

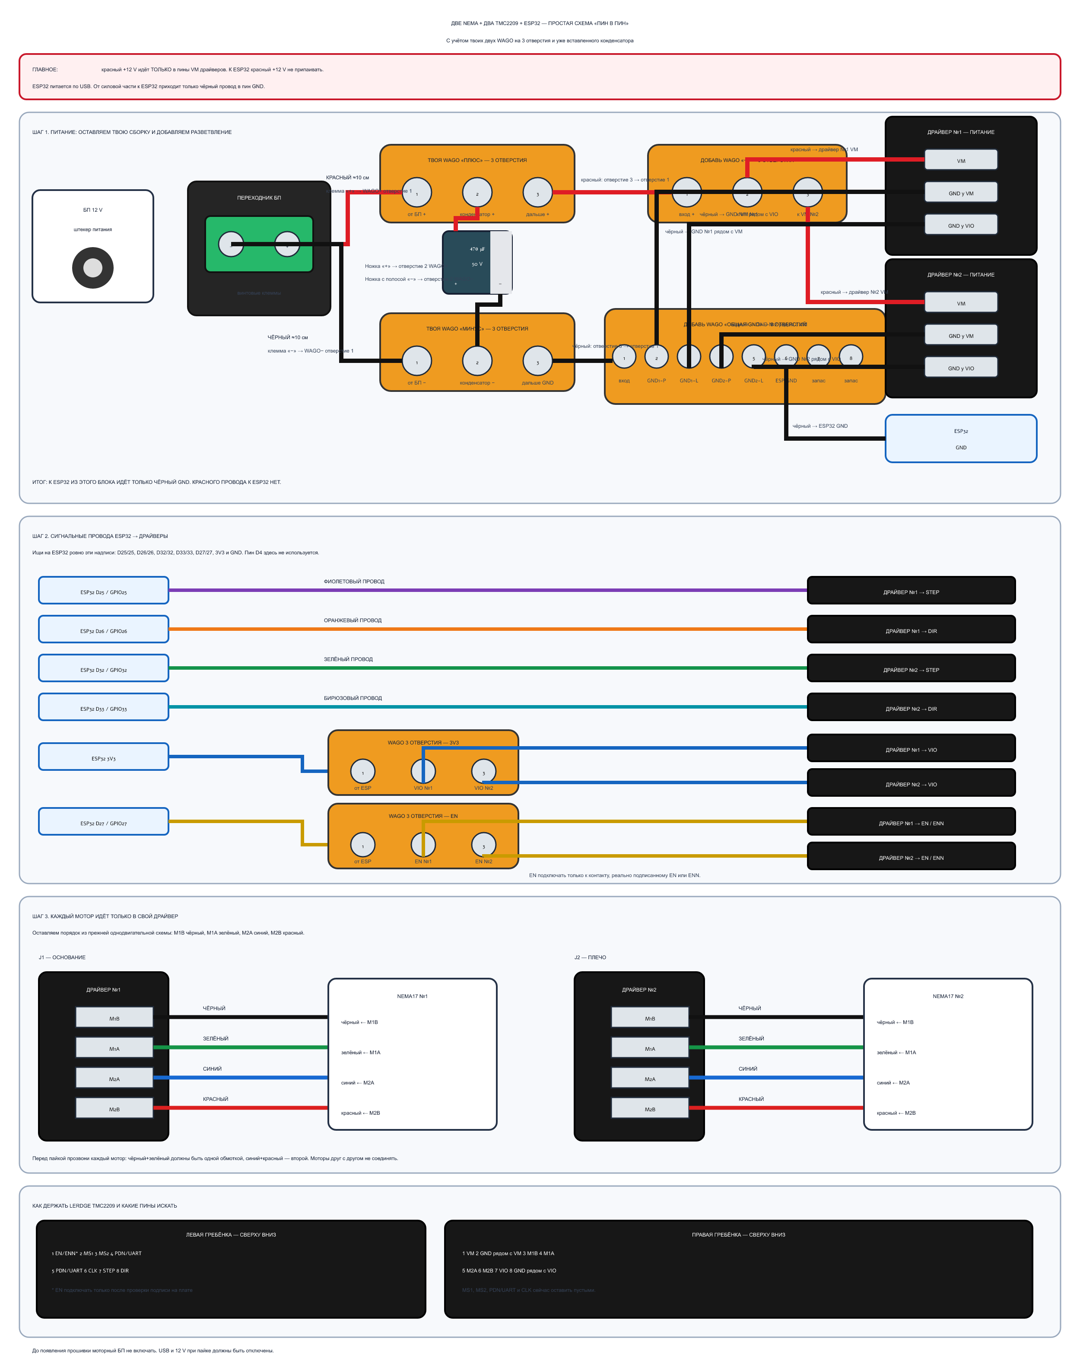
arm/j1_j2_wiring_simple_wago_preview.png
