BZKDP/robot-arm/arm/printed/_adapter_J2.png

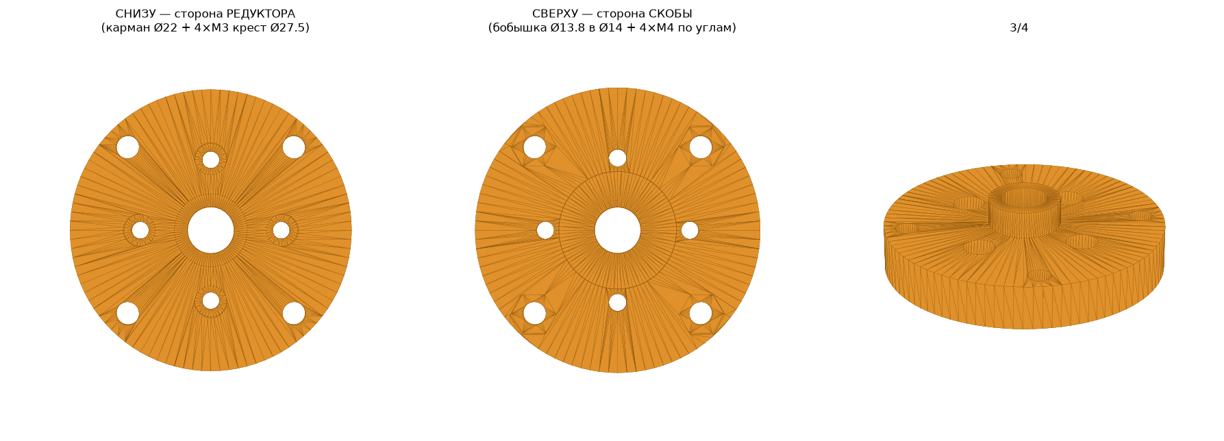
arm/printed/_adapter_J2.png
