BZKDP/robot-arm/arm/printed/_adapter_J2_dims.png

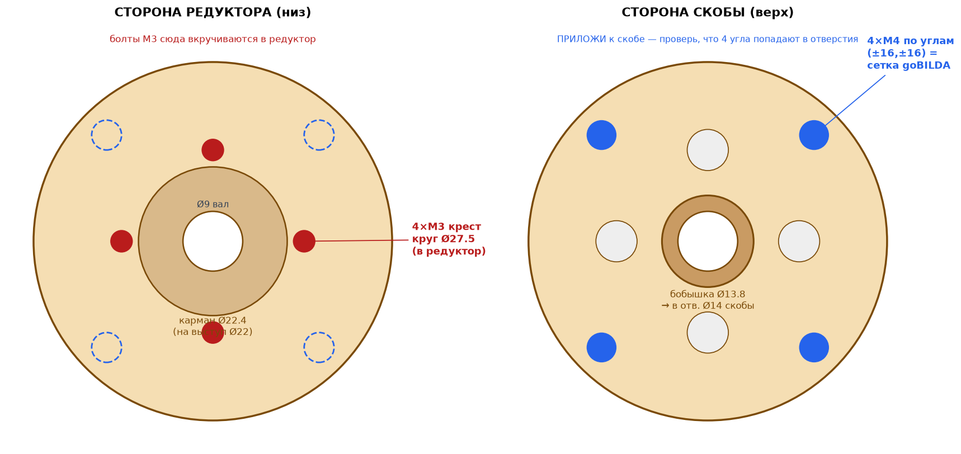
arm/printed/_adapter_J2_dims.png
