BZKDP/robot-arm/arm/printed/_adapter_v2.png

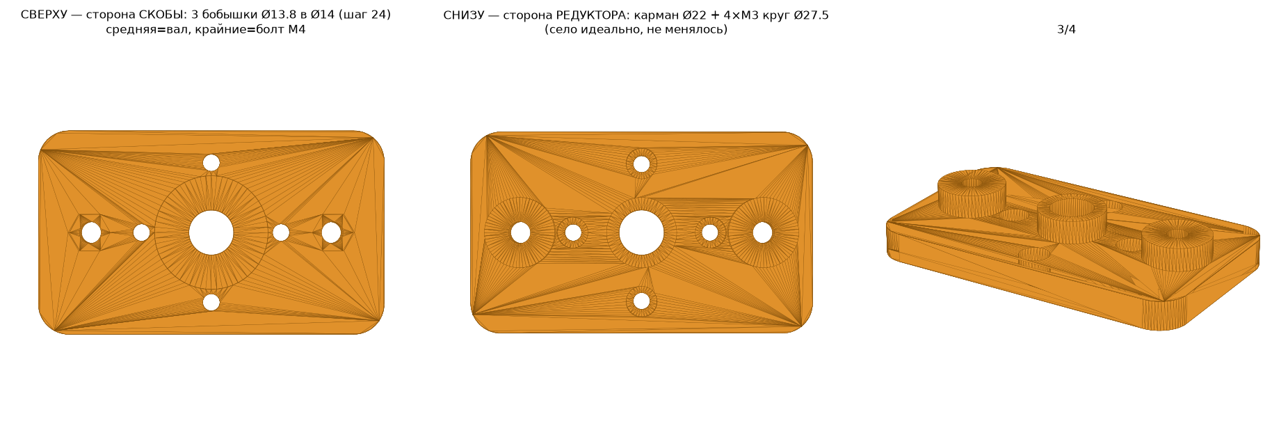
arm/printed/_adapter_v2.png
