BZKDP/robot-arm/arm/printed/_adapter_v2_plan.png

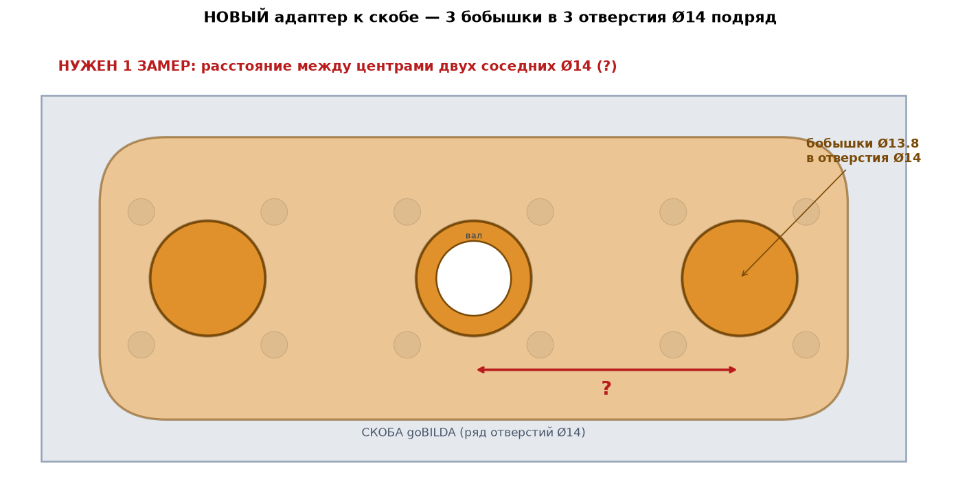
arm/printed/_adapter_v2_plan.png
