BZKDP/robot-arm/arm/printed/_bridge_final.png

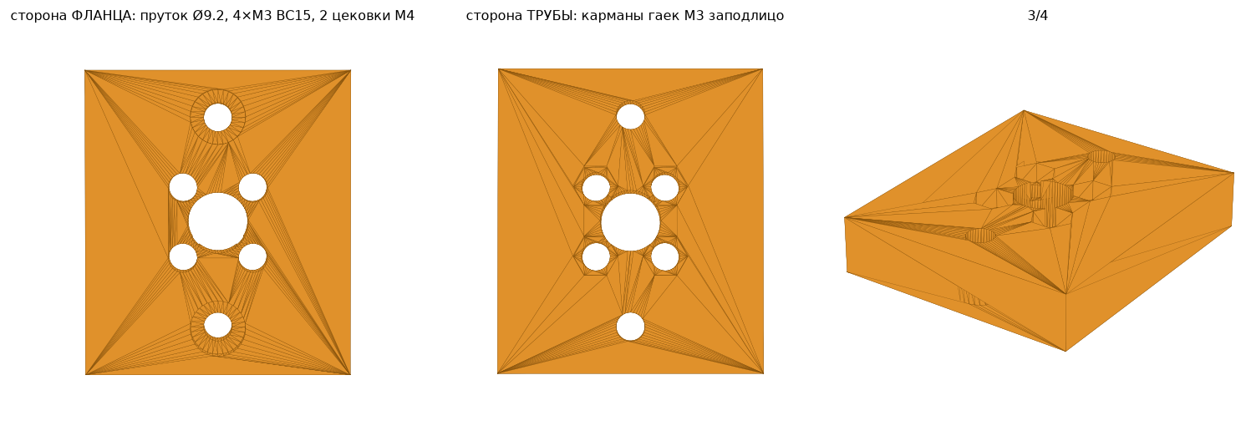
arm/printed/_bridge_final.png
