BZKDP/robot-arm/arm/printed/_bridge_logic.png

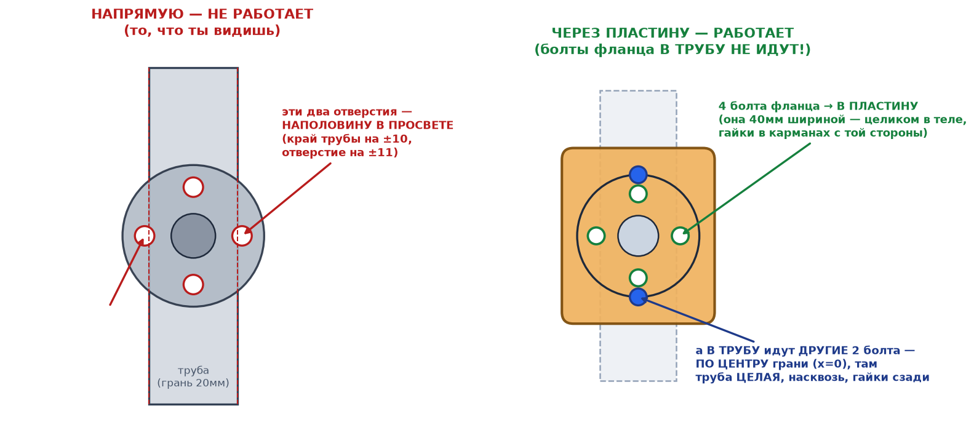
arm/printed/_bridge_logic.png
