BZKDP/robot-arm/arm/printed/_coupling_v2.png

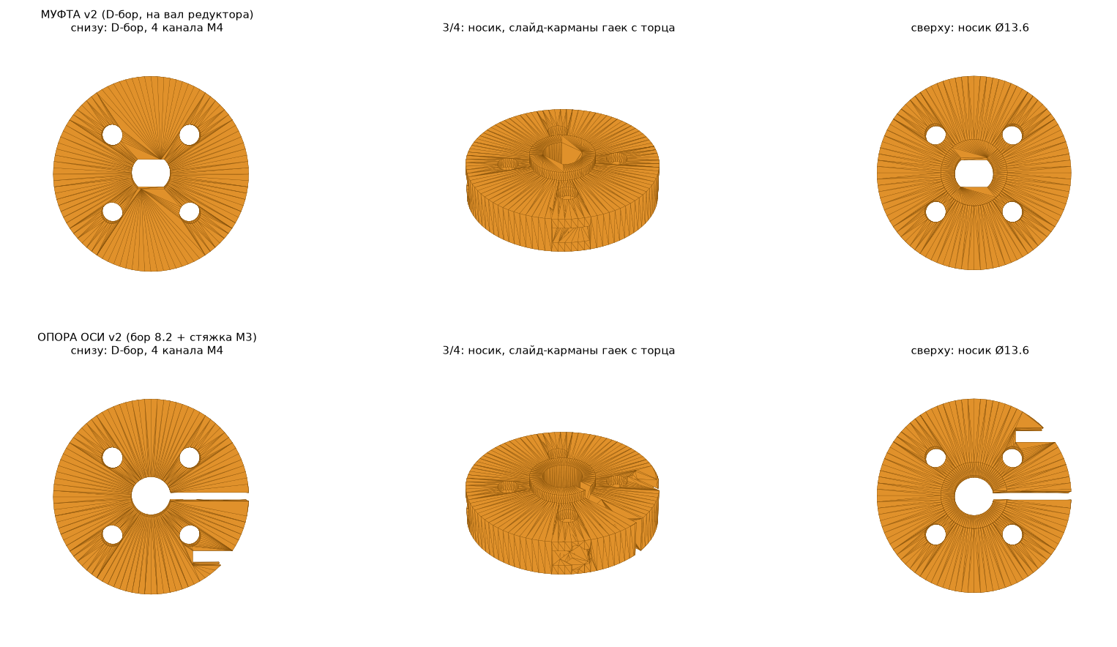
arm/printed/_coupling_v2.png
