BZKDP/robot-arm/arm/printed/_drill_tube_J2.png

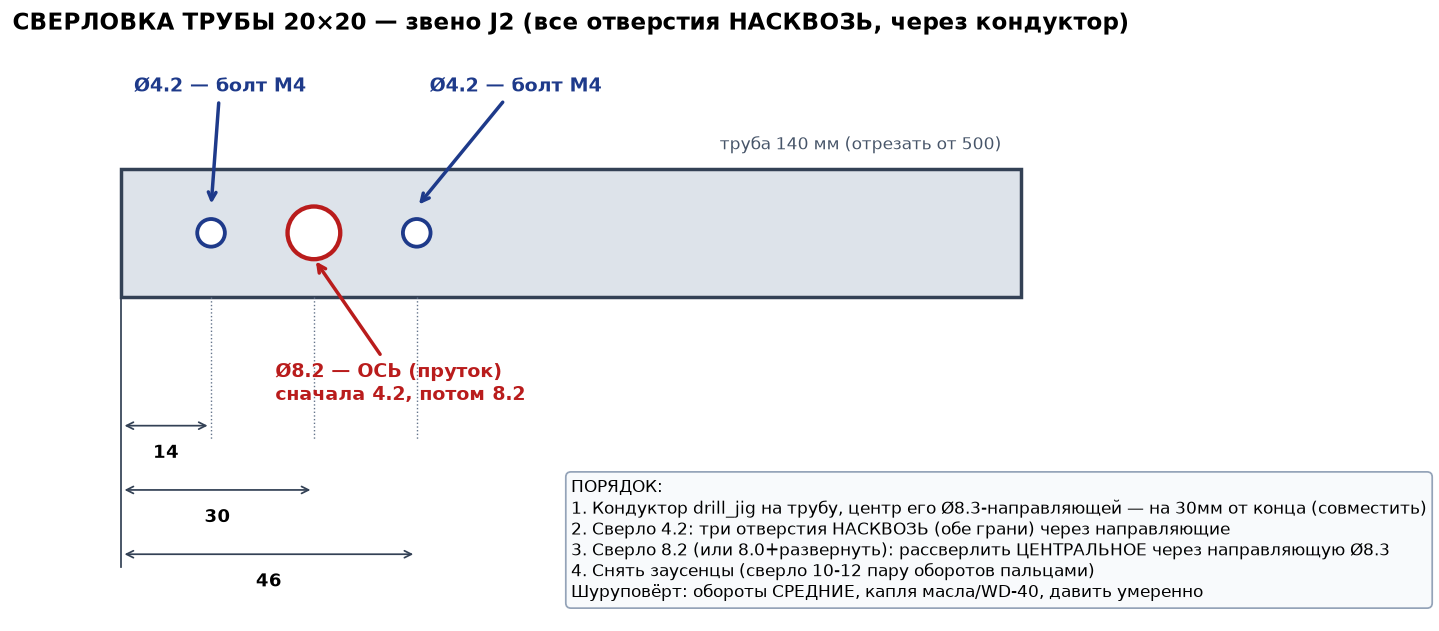
arm/printed/_drill_tube_J2.png
