BZKDP/robot-arm/arm/printed/_output_face.png

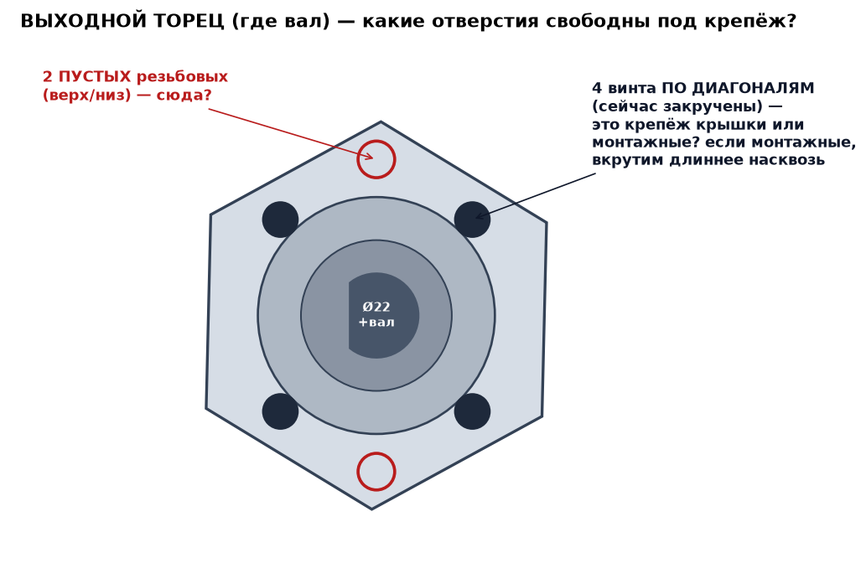
arm/printed/_output_face.png
