BZKDP/robot-arm/arm/printed/_plate_all_preview.png

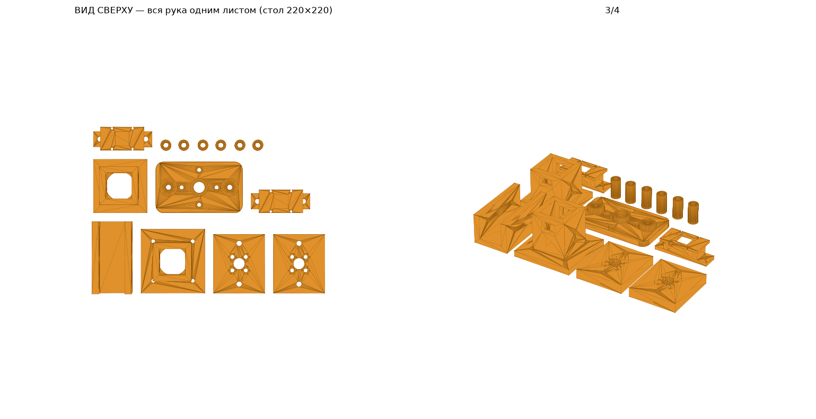
arm/printed/_plate_all_preview.png
