BZKDP/robot-arm/arm/printed/_plate_map.png

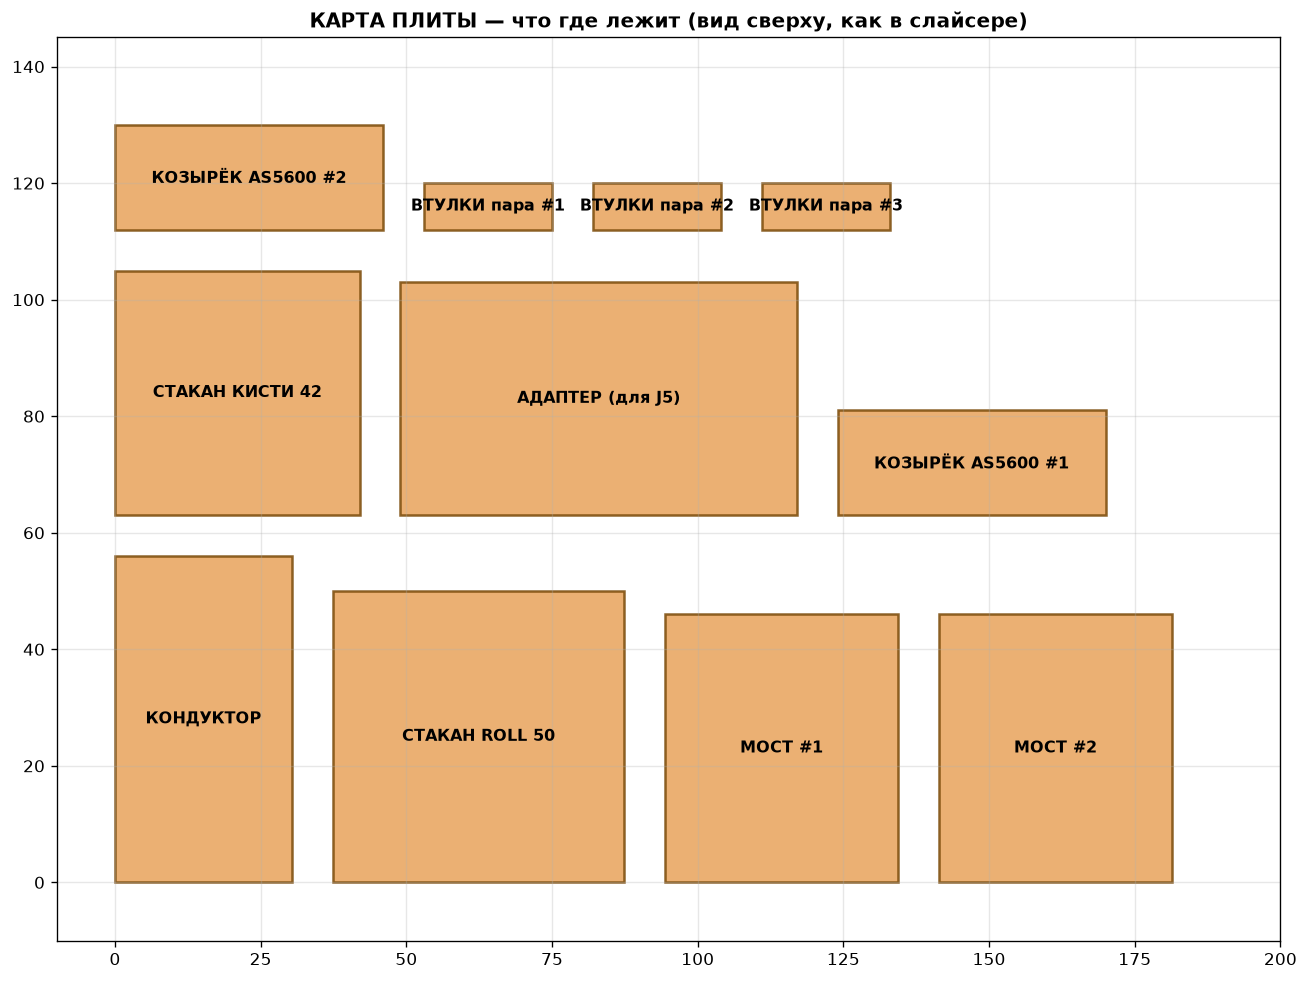
arm/printed/_plate_map.png
