BZKDP/robot-arm/arm/printed/base_motor_vise_cage_v1/BASE_VISE_CAGE_V1_REVIEW.png

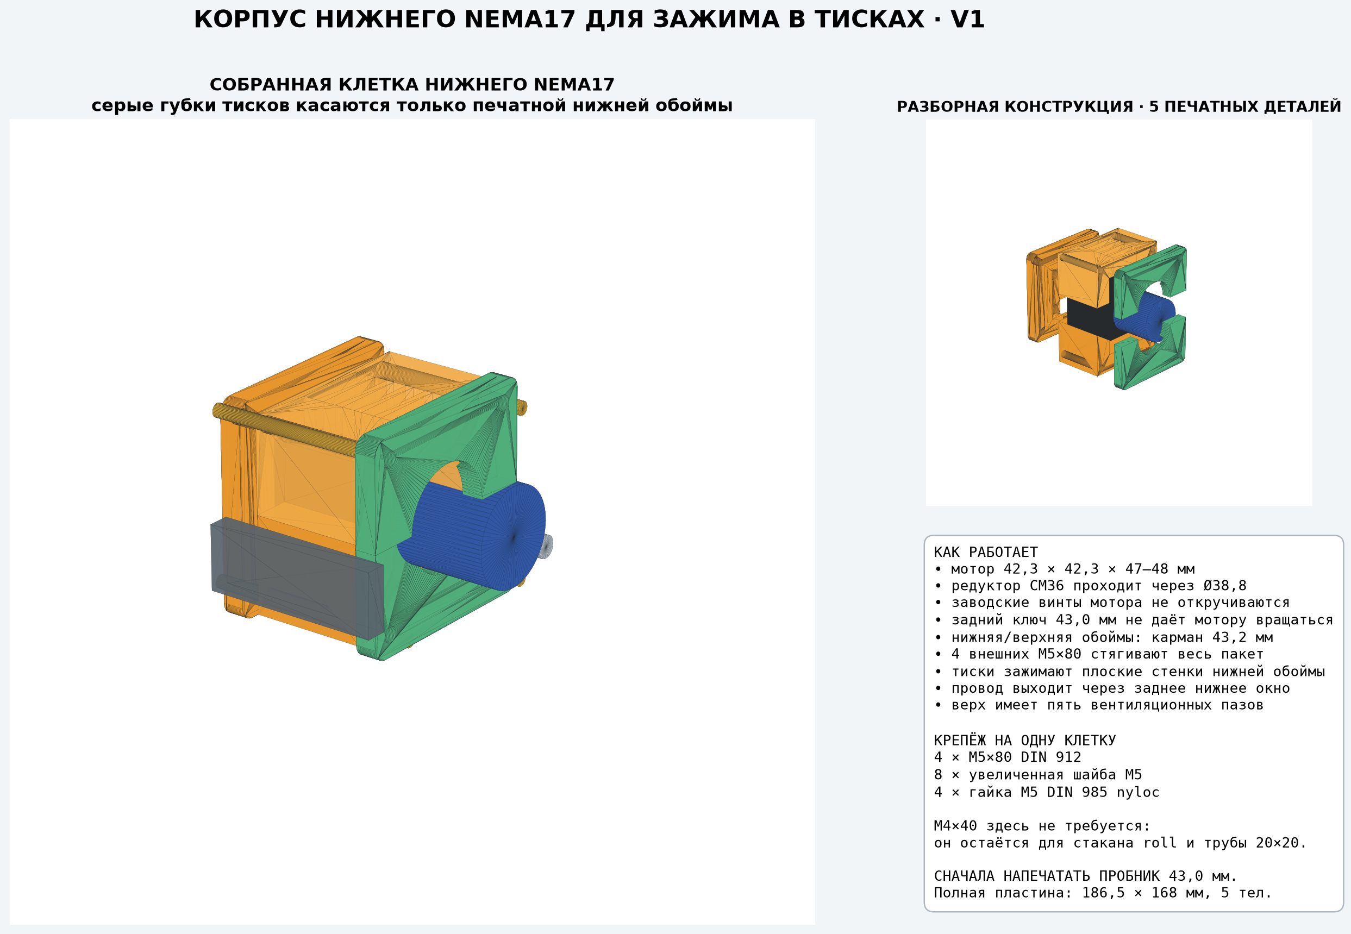
arm/printed/base_motor_vise_cage_v1/BASE_VISE_CAGE_V1_REVIEW.png
