BZKDP/robot-arm/arm/printed/flange_coupling_preview.png

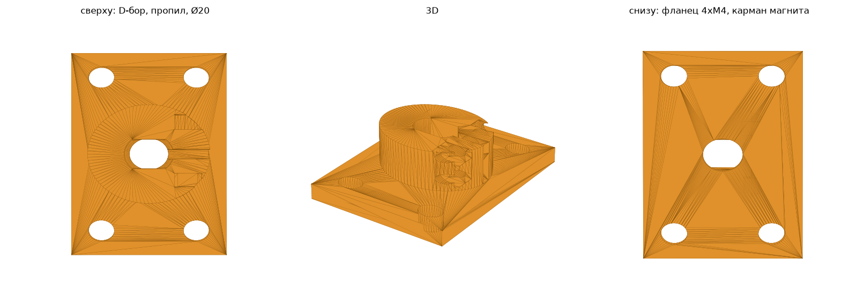
arm/printed/flange_coupling_preview.png
