BZKDP/robot-arm/arm/printed/J3_CONNECTION_3D_REVIEW_check.png

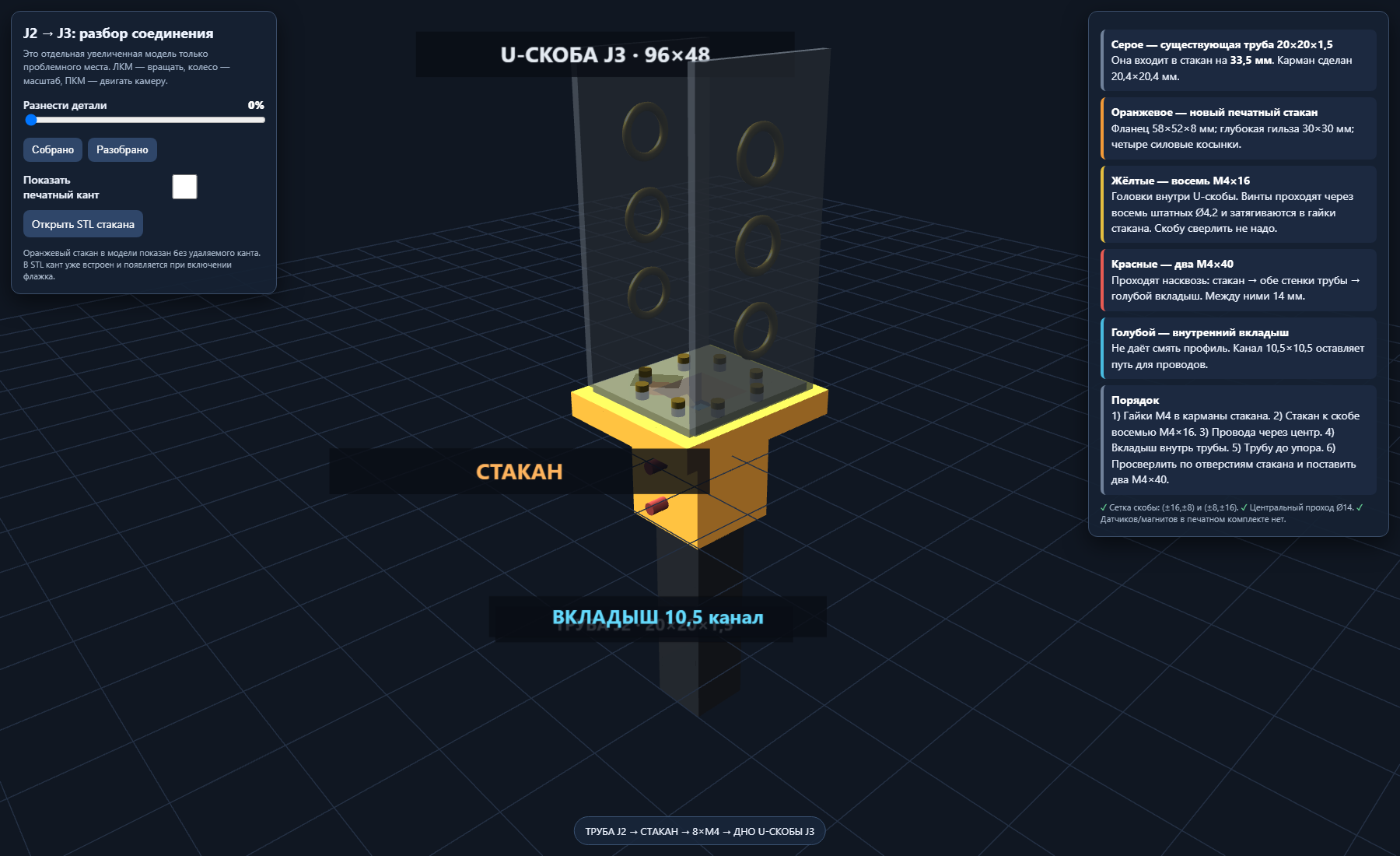
arm/printed/J3_CONNECTION_3D_REVIEW_check.png
