BZKDP/robot-arm/arm/printed/J3_CUP_CONNECTION_REVIEW.png

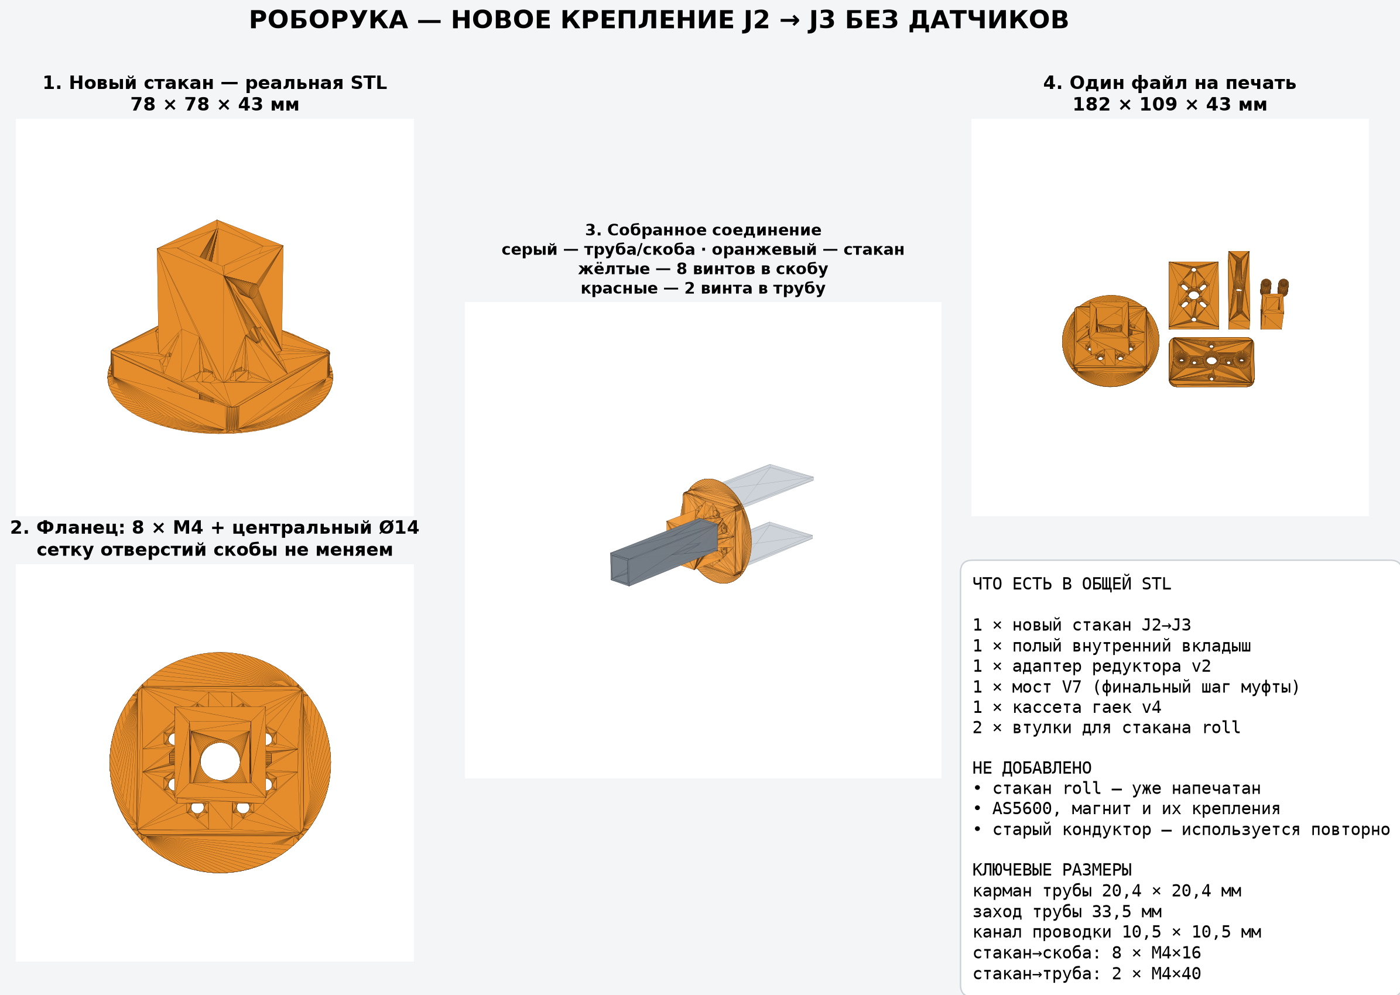
arm/printed/J3_CUP_CONNECTION_REVIEW.png
