BZKDP/robot-arm/arm/printed/PLATE_J1J2_preview.png

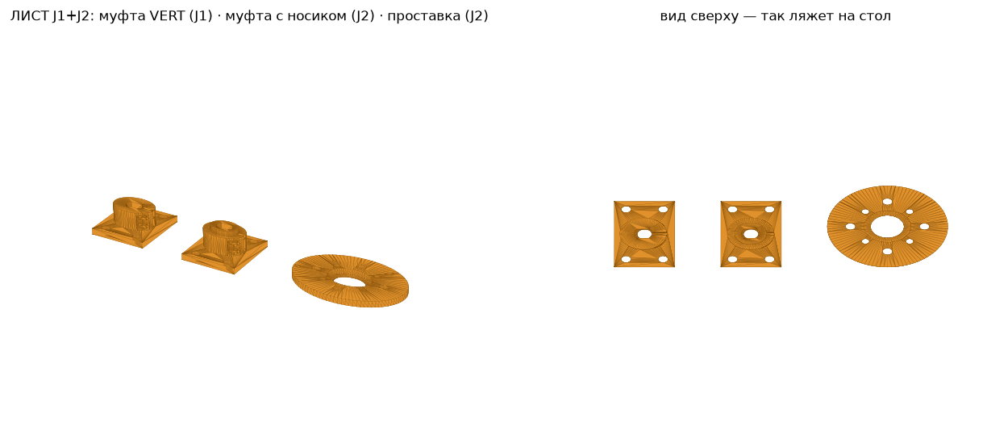
arm/printed/PLATE_J1J2_preview.png
