BZKDP/robot-arm/arm/printed/ROLL_CAGE_V4_NO_MOTOR_SCREWS_3D_REVIEW_check.png

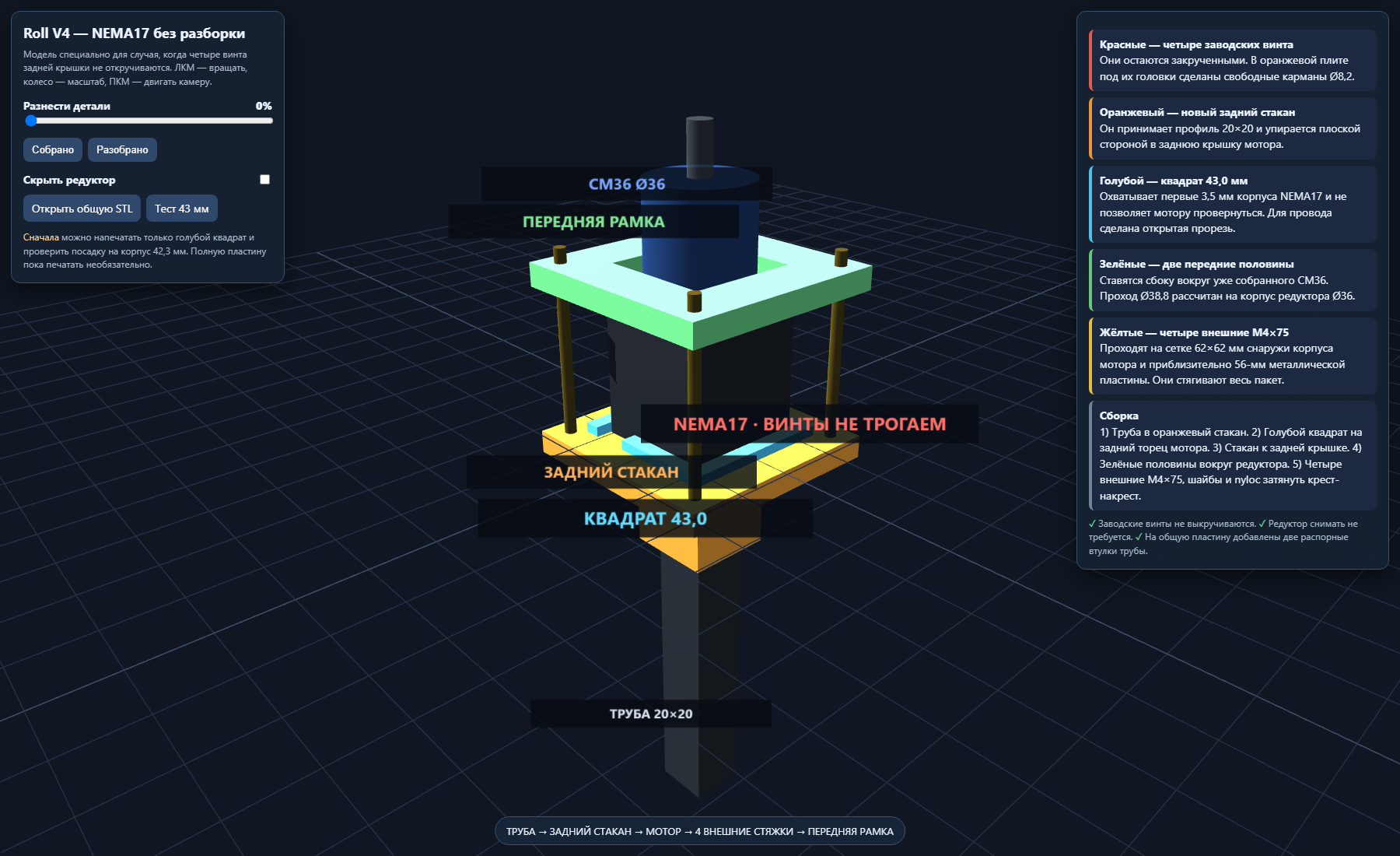
arm/printed/ROLL_CAGE_V4_NO_MOTOR_SCREWS_3D_REVIEW_check.png
