BZKDP/robot-arm/arm/printed/ROLL_CAGE_V4_NO_MOTOR_SCREWS_REVIEW.png

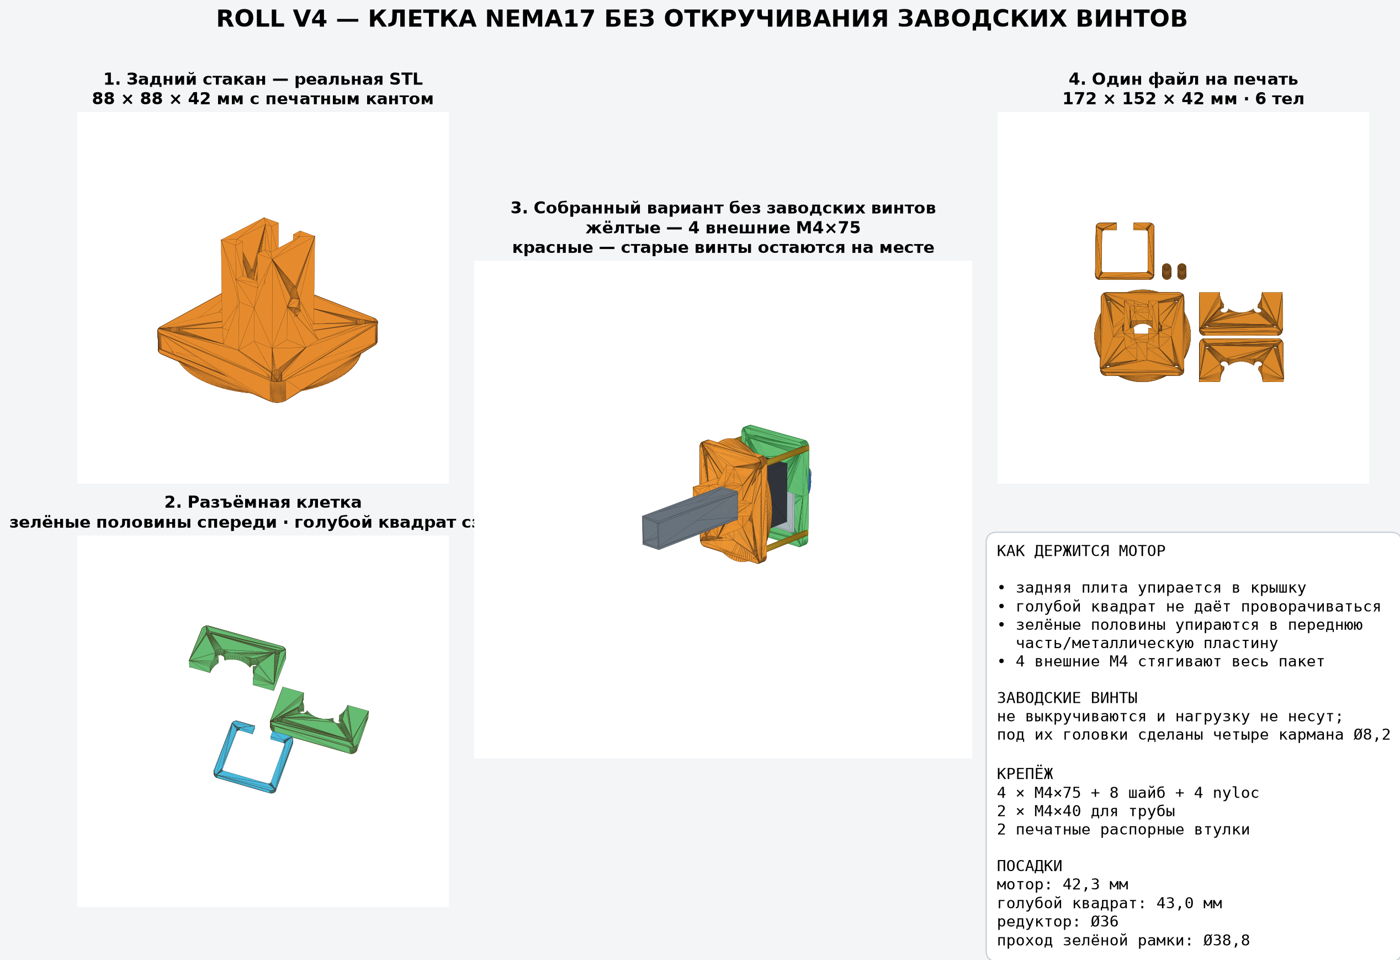
arm/printed/ROLL_CAGE_V4_NO_MOTOR_SCREWS_REVIEW.png
