BZKDP/robot-arm/arm/wiring_v2/wiring_3d_exact_preview.png

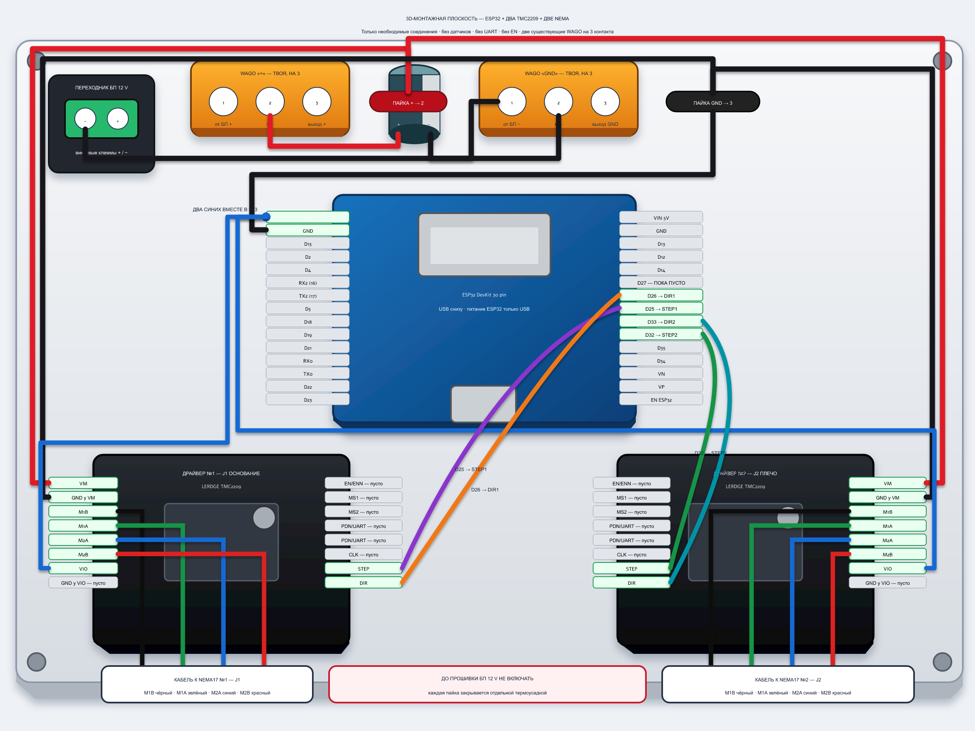
arm/wiring_v2/wiring_3d_exact_preview.png
