BZKDP/robot-arm/vacuum/assembly_look.png

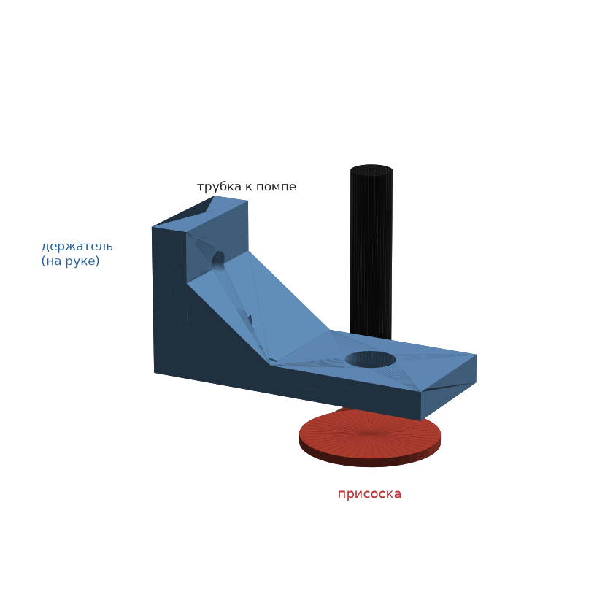
vacuum/assembly_look.png
