BZKDP/robot-arm/arm/printed/j4_roll_quad_hall_v6/J4_QUAD_HALL_WIRING_AND_CALIBRATION_RU.md

# QUAD HALL INDEX V3 — печать, проводка и сборка

## Что выбрано

- 4× аналоговый SS49E на J1 через 90°.
- 4× аналоговый SS49E на J4 через 90°.
- 1× магнит D3×2, аксиально намагниченный, на каждый сустав.
- 1× ADS1115 на каждый сустав: A0…A3 принимают четыре аналоговых выхода.
- Оба ADS1115 подключаются к уже купленному TCA9548A на сенсорной ESP32.

Это даёт четыре абсолютных контрольных положения на оборот (0/90/180/270° после калибровки). Между метками положение считается по STEP. Это индексная коррекция, не непрерывный абсолютный энкодер.

## Печать

PETG, сопло 0,4 мм, слой 0,20 мм, 5 стенок, 35–45% infill, без поддержек.

- На один сустав: `PLATE_HALL_QUAD_INDEX_V3_ONE_JOINT_PRINT.stl`.
- На два сустава сразу: `PLATE_HALL_QUAD_INDEX_V3_TWO_JOINTS_PRINT.stl`.
- Сначала отдельно желательно: `hall_quad_SS49E_body_pocket_fit_test_3_sizes_PETG.stl` и `hall_quad_magnet_bushing_fit_set_OD4p00_4p15_4p30_PETG.stl`.

## Крепёж на один сустав

- 4× M3×12 DIN 912 — кассета к торцу CM36.
- 4× M3×6 DIN 912 — прижимное кольцо в пластик.
- 1× капля эпоксидки/фиксатор для магнита.

## Установка датчиков

1. Плоская маркированная сторона каждого SS49E смотрит вверх к магниту.
2. Выводы согнуть только после примерки корпуса; уложить по одному в три отдельные радиальные канавки.
3. Если конкретный клон корпуса тоньше кармана, положить поверх корпуса прокладку Kapton/PET 0,10–0,20 мм; датчик не должен двигаться под прижимом.
4. Для каждого SS49E: VCC=3V3, GND=GND, OUT=свой отдельный канал ADS1115.
5. На суставе объединить только VCC и GND. Получится шестижильный жгут: 3V3, GND, OUT0, OUT1, OUT2, OUT3.
6. Перед окончательной затяжкой проверить, что магнит нигде не цепляет при полном обороте.

## Калибровка

Для каждого из четырёх датчиков сохранить базовый уровень без магнита и пик при проходе магнита. Центр метки определять по максимуму отклонения от базового уровня, направление — по порядку срабатываний каналов.
