BZKDP/robot-arm/arm/firmware/motor1_safe_test/LERDGE_TMC2209_page1.png

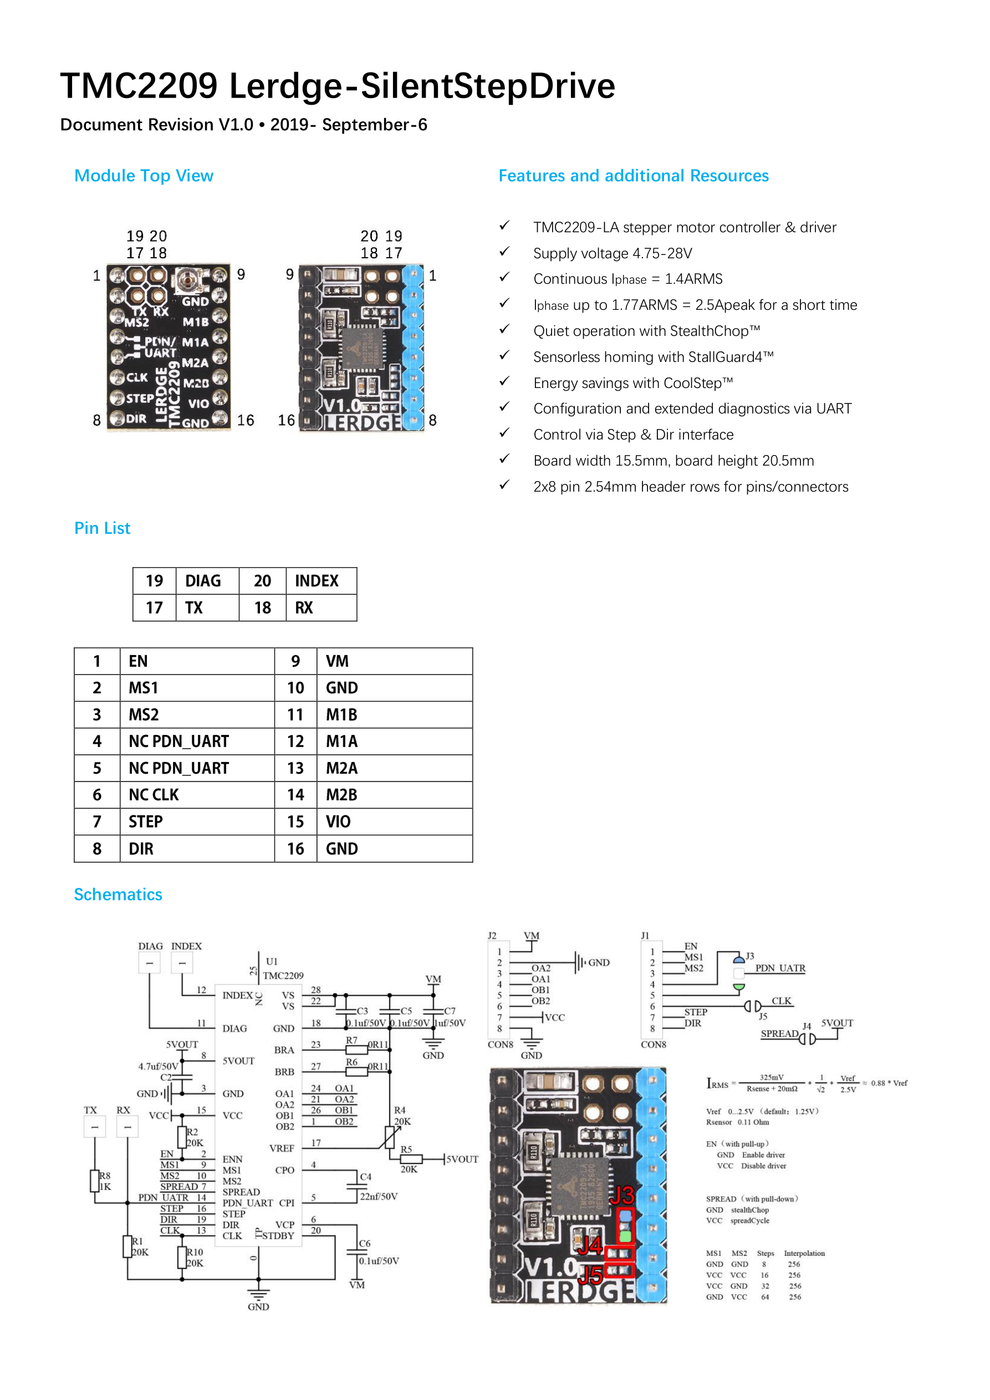
arm/firmware/motor1_safe_test/LERDGE_TMC2209_page1.png
