BZKDP/robot-arm/arm/measure_A_output_as5600.png

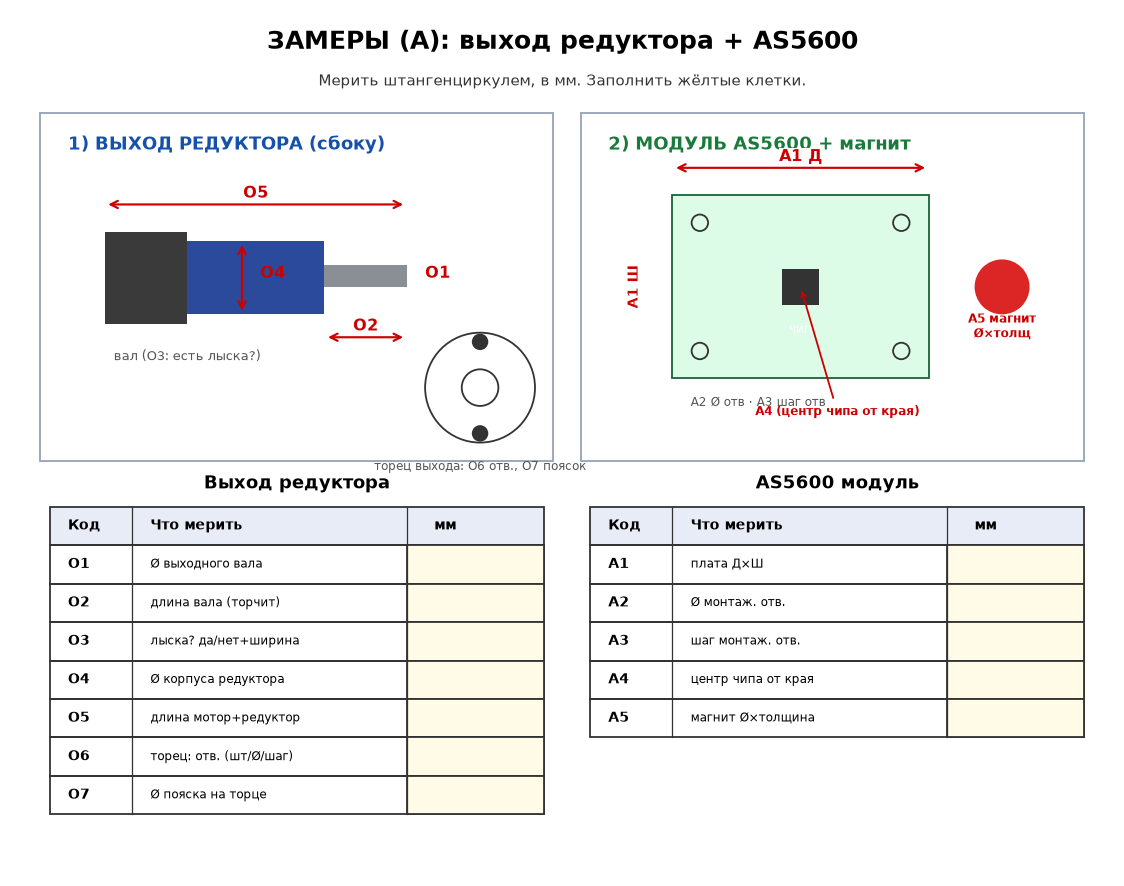
arm/measure_A_output_as5600.png
