BZKDP/robot-arm/arm/measure_B_frame.png

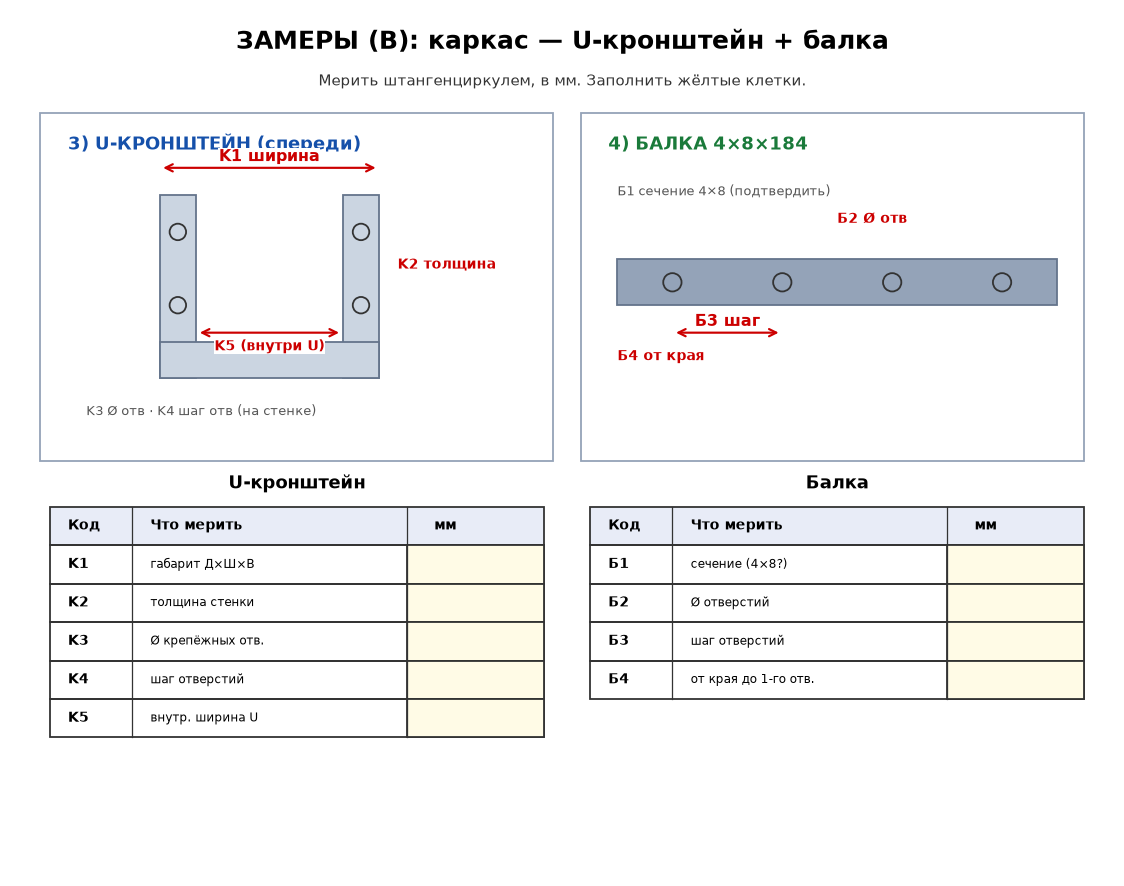
arm/measure_B_frame.png
