BZKDP/robot-arm/arm/measure_sheet.png

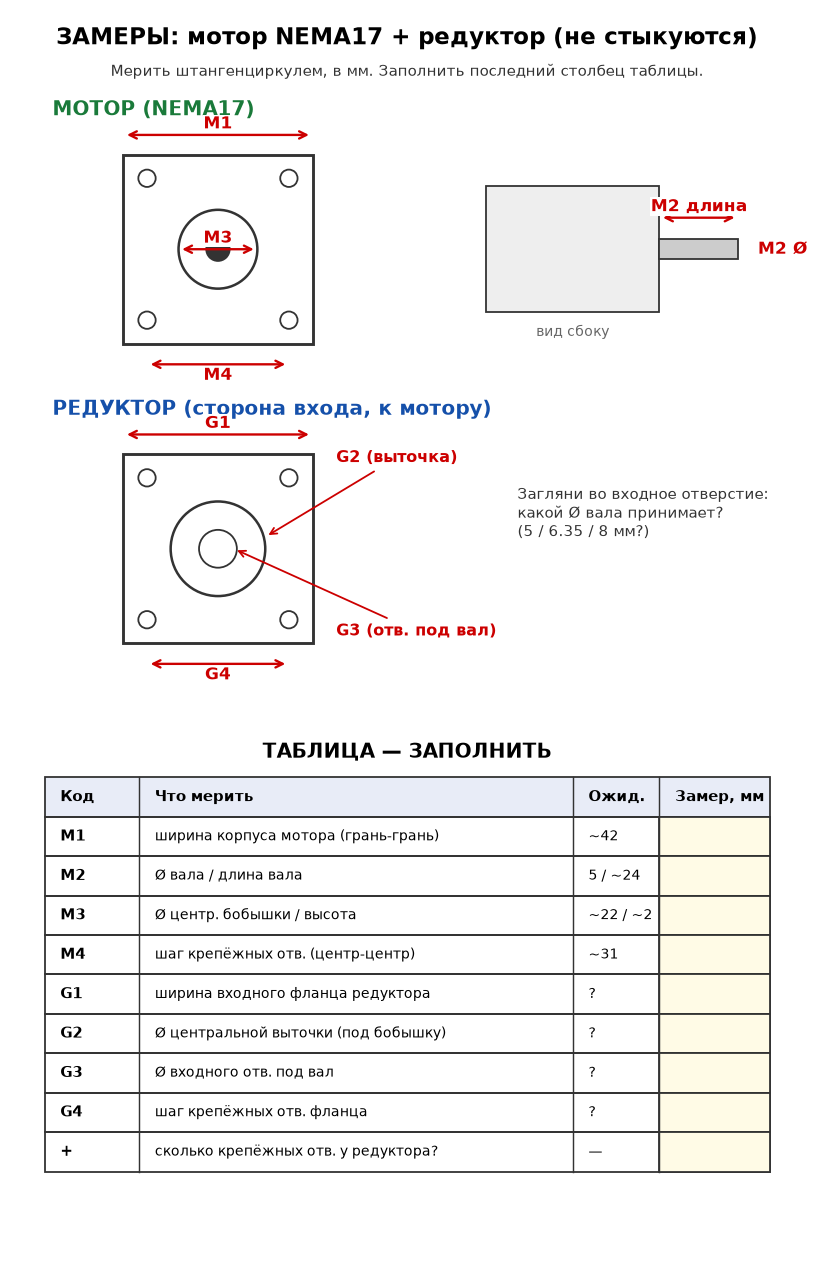
arm/measure_sheet.png
