BZKDP/robot-arm/arm/printed/_bridge_v5_verified.png

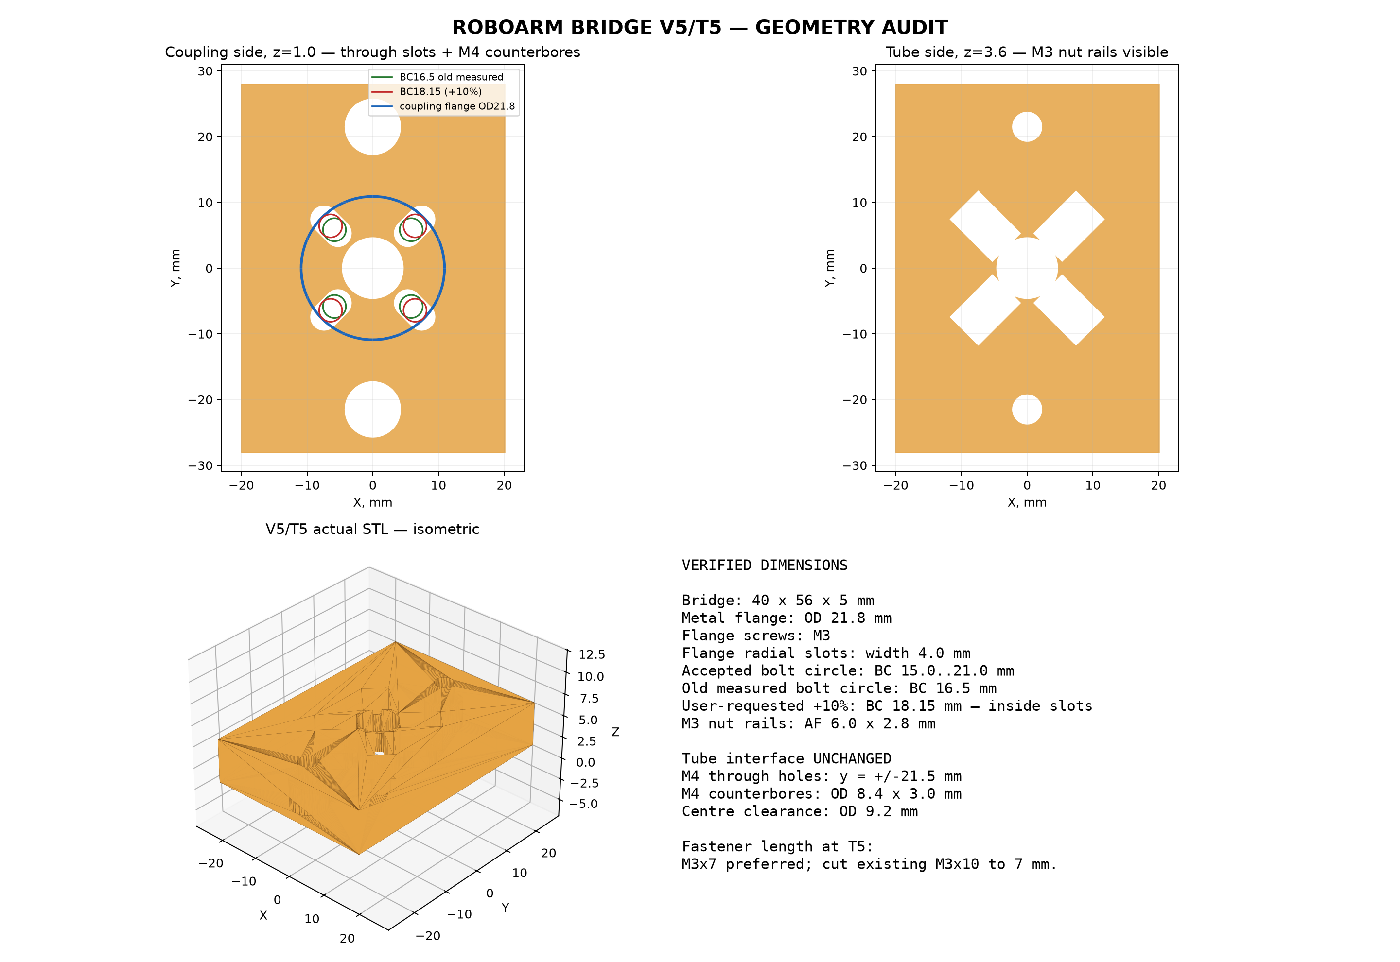
arm/printed/_bridge_v5_verified.png
