BZKDP/robot-arm/arm/printed/_gearbox_measure.png

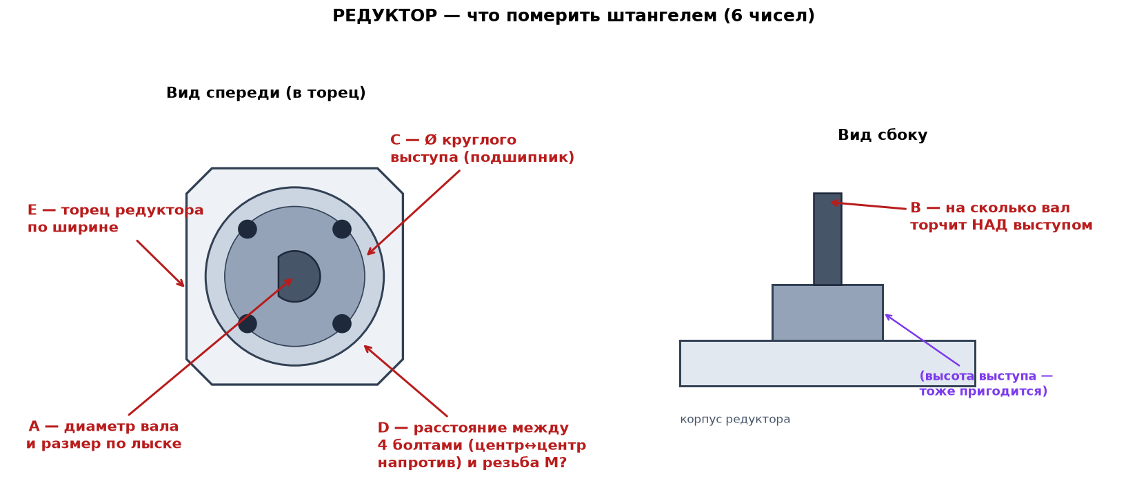
arm/printed/_gearbox_measure.png
