BZKDP/robot-arm/arm/printed/_H_measure.png

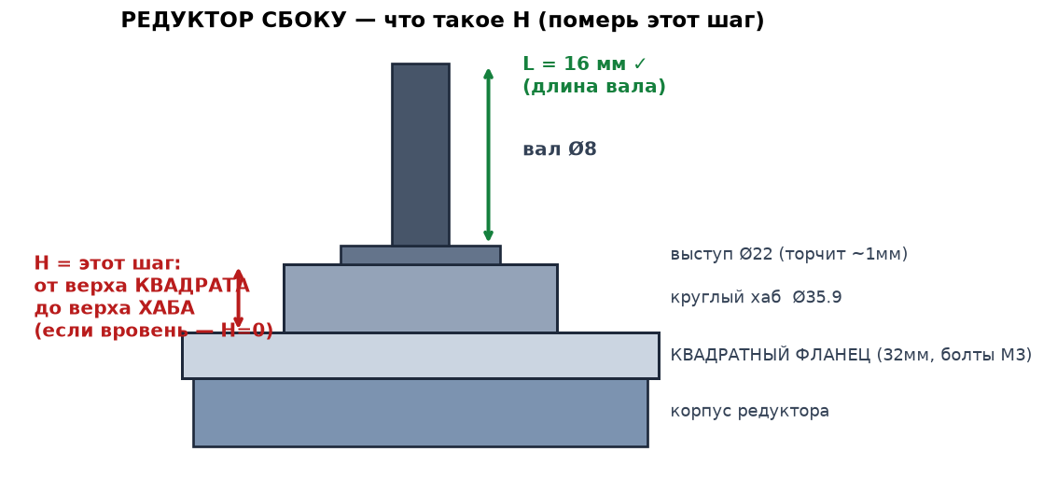
arm/printed/_H_measure.png
