BZKDP/robot-arm/arm/full_arm_v11_quad_hall/ARM_V11_QUAD_HALL_CHANGES_RU.md

# ARM V11 — изменения датчиков

- J1: 4×SS49E через 90°, один вращающийся D3×2.
- J4: идентичная кассета 4×SS49E, один вращающийся D3×2.
- На каждый сустав предусмотрен ADS1115; оба идут через TCA9548A во вторую ESP32.
- Печатная механика находится в `printed/hall_quad_index_v3` и `printed/j4_roll_quad_hall_v6`.
