BZKDP/robot-arm/arm/printed/_bearing_clearance_fix.png

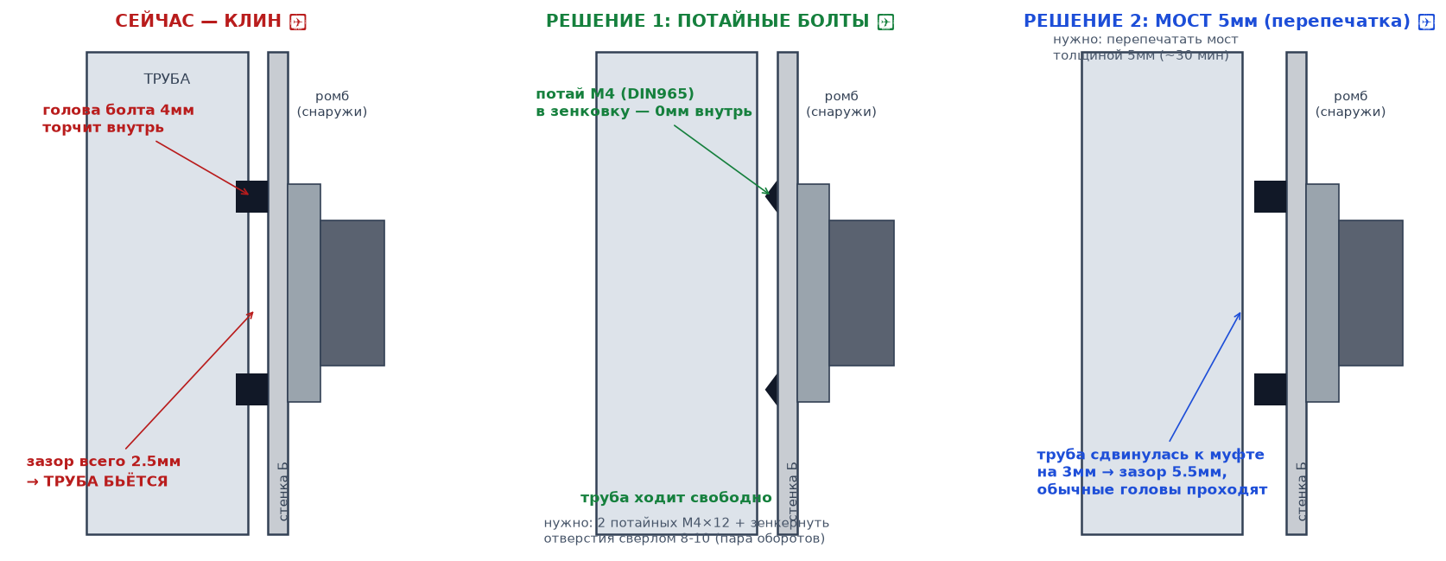
arm/printed/_bearing_clearance_fix.png
